davidgoddard/mower2026/external-hardware/esp32/motor-controller/README.md

# Motor Controller V2

## Purpose

This folder contains a self-contained ESP32 motor controller sketch for the second-generation mower protocol.

File:

- `motor-controller.ino`

## What it does

- runs as I2C slave at address `0x66`
- accepts explicit left/right wheel output commands (`-1.0..1.0`, where `1.0` is full output)
- accepts changed commands immediately and a refreshed unchanged command once
  per second as the Pi drive heartbeat
- rejects an older non-zero sequence that arrives after a newer neutral or
  disabled command; safety commands are always accepted so a restarted Pi can
  stop the motors even after its sequence counter resets
- disables drive if the command heartbeat exceeds its 2.5-second lease
- uses an independent five-second ESP task watchdog to recover a stalled sketch
- preserves asymmetric ramp-up / ramp-down behavior
- preserves stop-before-reverse behavior
- counts FG/tach pulses
- returns a direct-read, fixed 32-byte feedback snapshot at 20 Hz
- calibrates both current-sensor zero points on demand immediately before the
  first non-zero drive request from the Pi, while both PWM outputs are forced off
- builds feedback in an inactive buffer and atomically swaps buffers, leaving
  the I2C request callback with only a fixed-size `Wire.write()`

## I2C exchange

- Command: Pi writes a framed command only when it changes or its one-second
  refresh interval elapses.
- Feedback: Pi directly reads the latest 32-byte snapshot; there is no preceding
  feedback-request write.
- The feedback sequence is owned by the ESP32 and increments for every newly
  generated snapshot.
- `watchdogHealthy` reports whether the command heartbeat lease is current;
  fault bit 0 reports an expired or not-yet-established command lease.

## Important note

This firmware already uses the current wire protocol and feedback contract, but the wheel-speed execution is still intentionally simple:

- direct commanded PWM output with local ramping only
- no hardware-tuned closed-loop controller yet

That is good enough for manual bring-up and feedback validation, but not yet final precision control.

## Pin assumptions

Inherited from the legacy build:

- SDA `16`
- SCL `17`
- left PWM `5`
- left DIR `18`
- right PWM `14`
- right DIR `19`
- left tach `21`
- right tach `22`

## ESP32 wiring reference

The current motor controller sketch targets an ESP32-WROOM-32 dev board pinout.

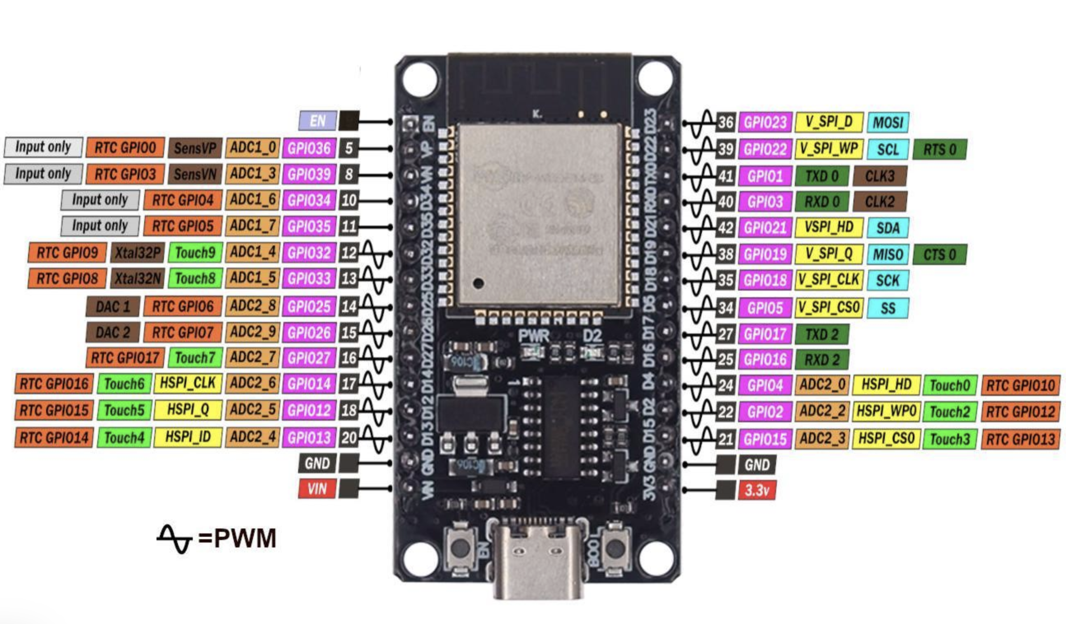
[picture p2: docs/images/esp32-wroom-d32.png]
ESP32-WROOM-32 pin reference


Motor controller signal mapping for the current sketch:

| Function | GPIO | Note |
| --- | --- | --- |
| I2C SDA | `GPIO16` | Pi-to-motor command and feedback bus |
| I2C SCL | `GPIO17` | Pi-to-motor command and feedback bus |
| Left motor PWM | `GPIO5` | PWM-capable output |
| Left motor direction | `GPIO18` | Digital output |
| Right motor PWM | `GPIO14` | PWM-capable output |
| Right motor direction | `GPIO19` | Digital output |
| Left motor FG/tach | `GPIO21` | Input with `3.3 V` pull-up |
| Right motor FG/tach | `GPIO22` | Input with `3.3 V` pull-up |

Wiring constraints:

- common ground between the ESP32, motor driver, and motor feedback wiring is required
- the `FG` lines are treated as `3.3 V` logic inputs on the ESP32 side
- route each `FG` line through a `74132` Schmitt-trigger gate before the ESP32 input
- use an external `4.7k-10k` pull-up to `3.3 V` on each `FG` line for mower installation
- do not feed `5 V` directly into the ESP32 GPIO pins
- do not power the `74132` from `5 V` when its outputs feed the ESP32

## FG feedback note

The current motors appear to provide `FG` speed feedback rather than a full quadrature encoder.

Known characteristics from the motor documentation:

- yellow wire = `FG`
- output type = open-collector `NPN`
- pulse rate = `12 pulses / round`

That means:

- the ESP input needs a pull-up
- the `74132` should be powered at `3.3 V` and used to square up each FG waveform before `GPIO21` / `GPIO22`
- an external pull-up to `3.3 V` is preferred over relying only on the ESP32 internal pull-up
- direction is inferred from a cached "last commanded direction" sign per wheel (`g_leftDirSign` / `g_rightDirSign`). The cache is updated in lockstep with the DIR-pin write inside `applyMotorHardware`, so the encoder ISR can sign each pulse from the cache without an extra `digitalRead`. This is correct during ramp-down and during the brake-to-stop coast (the cached sign is unchanged so coast pulses inherit the prior direction) and during direction reversals (the firmware ramps PWM through zero before flipping the cached sign, so deceleration pulses keep the OLD sign and post-flip pulses pick up the NEW sign).

If the mower reports motion while motor power is off, inspect FG wiring and the pull-up arrangement first.

## Manual test support

Use the companion host-side script:

- `../manual-tests/motor_manual_test.js`
- `../manual-tests/motor_mode_test.js`
- `../manual-tests/motor_idle_noise_test.js`

That script is intended to run on the Pi and exercise:

- spin one way
- spin the other way
- forward
- backward
- direction swaps
- gentle arcs

The idle/noise script is intended to run on the Pi with zero command and the mower stationary. Use it to verify that the FG lines do not produce false pulse counts when the motors are unpowered or idle.

The direct mode script is intended for confirming left/right inversion and mirrored motor mounting. It accepts physical wheel modes such as:

- `FF` = both wheels forward
- `FR` = left forward, right reverse
- `F0` = left forward only
- `0F` = right forward only

Expected result for a healthy idle run:

- `PASS`
- zero encoder deltas for the full run
- `watchdogHealthy: true` while the Pi command heartbeat is current, including
  a current zero-output or disabled command

The production Pi client establishes a disabled command during sensor-hardware
initialization and refreshes the latest active, zero-output, or disabled command
until the hardware gateway closes. This keeps idle health checks meaningful
without enabling the H-bridges; loss of the Pi still expires the lease.

Current sensing is deliberately not calibrated during ESP32 startup because the
ESP32 and Pi can be powered before the motor battery and current sensors are in
their operating state. The first non-zero command from mowing, web manual drive,
or game-controller drive sends a dedicated calibration request. The ESP32
invalidates any prior drive command, forces both PWM outputs off, averages 128
samples from both sensors, and only then can the Pi send the requested motion.
Until this happens, reported motor current is zero rather than an invalid value.
For direct maintenance clients that do not send the dedicated request, the ESP32
also recognizes the first non-zero wheel command, retains it with drive gated
off, performs the same calibration, and applies the command on the next control
step.
An explicit disabled motor command marks the calibration stale, since the motor
battery may subsequently be disconnected without rebooting the Pi or ESP32. The
next drive interaction therefore performs a fresh calibration.

## Before flashing

Check and adjust in the sketch if needed:

- inversion flags for left/right motors
- full-output pulses-per-second estimate
- PWM pins and tach pins
