davidgoddard/mower2026/docs/functional-specification.md

# Functional Specification

## Scope

This specification defines the mower control system that runs on a Raspberry Pi and coordinates with:

- a GNSS ESP node which is itself hooked up to a UM982 dual antenna GNSS module
- a motor ESP node
- a IMU 

All 3 of the above are sharing an i2c link running at 400k baud configured on the Pi.

The motors have output pulses for speed and rotational information and there are current sensing modules on the motor power lines.  This information is available over i2c.

Both heading and position information is available from the GNSS module over i2c.

At the current project stage there is no calibrated translational-speed model for mower motion. Runtime logic shall not use meters-per-second vehicle-speed assumptions or speed-based plausibility gates for control, GNSS validation, or learning behaviour unless this specification is explicitly extended to add that capability.

## System goals

The system shall:
- Provide a web page through which a user can:
    - verify the mower state seeing current GNSS pose, IMU reported heading and motor state.  
    - request a run of the turn tuning
        - separate large-angle and small-angle training runs shall be available
        - small-angle training shall keep repeating each bucket until the absolute error is below 2 degrees
        - large-angle training shall likewise keep repeating each requested angle until the absolute error is below 2 degrees
    - request a run of drive tuning
    - define the mowing areas
        - within each area capture zero or more obstacle perimeters
        - define the outer perimeter
        - allocate a name ot the area
    - start mowing of an area
- when turning: continually monitor the turning and adjust its internal control parameters to reduce errors:
    - turns should use IMU heading changes only
    - GNSS heading shall not be used or written into the IMU baseline while a turn is active; it may be considered only after motor output is zero and yaw motion has settled
    - encoder/motor-feedback-derived turn angle, wheelbase-based heading and IMU/encoder turn disagreement are diagnostic values only; they shall not steer, stop, correct, validate or otherwise influence a turn or any navigation decision
    - turns should request one wheel to go forward, the other backward to turn on the spot and run the motors at full speed.
    - turns should learn when to request zero speed (brake) so that the in-built motor ramping down time is built into the stopping distance/angle thus aim to stop with zero degree error
    - small-angle turns shall combine live IMU angular progress and angular rate with a learned per-direction, per-angle coast horizon from 3° to 60°; elapsed wall time alone shall never complete a turn
    - every turn ever should add to the learning
- when driving: continually monitor the driving and adjust its internal control parameters to reduce errors:
    - Every drive should be as straight as possible and arrive at the target with a minimal X and Y error distance
    - Every drive should follow a sequence of events:
        - settle
        - get current pose
        - if current angle to target is more than 5 degrees then call the turn component with the required angle
        - if the turn component does not report success, stop that segment and do not issue the translation
        - settle 
        - get current pose again
        - compute the travel line to the target
        - apply a straight-line drive controller that:
            - holds full forward or full reverse wheel power throughout the drive — the cutting blade and drive are mechanically coupled and slow speeds risk stalling on grass
            - applies proportional and CTE-rate damping left/right wheel trim to keep the mower on the line and suppress repeated baseline crossings
            - keeps both wheel commands in the selected travel direction; it shall never pivot, scrub one wheel, or reverse one wheel after translation has begun
            - stops the line drive if body-heading error becomes grossly inconsistent with the established line outside the final approach window, leaving any subsequent re-alignment to the segment executor and `TurnController`
            - uses the same geometry for reverse travel with the correct body-heading reference
        - loop reading current pose and measure CTE and remaining distance
        - when remaining distance to target is less than the learned braking distance request zero motor speed; if a severe short-drive overshoot has learned a braking distance at or beyond the leg length, request zero on the first post-start pose update rather than discarding the correction.
        - always stop when the arrival tolerance is reached, even if braking was not used
        - wait learned brake time
        - settle
        - get current pose
        - compute new control parameters based on the CTE and X/Y errors
- short drives up to 1 metre shall use positive and negative stop-trigger learning buckets at 5,10,15,20,25,30,35,40,45,50,55,60,70,80,90 and 100cm, and longer plateau drives shall use separate forward and reverse full-speed brake distances while still retrying each training distance as a forward/reverse pair until both legs meet the configured endpoint bound on both absolute X and absolute Y error (currently 3cm)
- short-drive tuning runs shall be able to alternate forward and reverse legs, taking a fresh pose/heading sample for each leg so the mower can train without walking far away from the test area
- short-drive tuning runs shall clear any stale stop latch at the start of a new user-requested run so a fresh Start action actually starts motion
- drive learning shall use a larger learning step for larger distance errors so a 10cm miss adapts faster than a 4cm miss; short-drive overshoot corrections shall not be clipped to the requested leg length
- drive learning shall maintain separate CTE gains for forward and reverse motion so reverse steering can learn independently from forward steering
- qualified completed mowing strips shall update only the direction-specific proportional and CTE-rate damping steering gains; they shall not alter braking or turn parameters. Training runs retain their existing wider learning responsibilities
- every straight translation shall also apply a bounded, transient terrain trim only when motor-current imbalance and encoder response per applied PWM corroborate the same loaded side. The trim shall slew gradually, decay when evidence disappears, reset between drives, and be disabled by stale/unsafe feedback, watchdog failure, motor faults, obstruction or wheel-slip evidence
- the drive tuning page shall let the operator choose a starting distance, defaulting to 50cm, so already-learned shorter buckets can be skipped during a session
- the drive tuning page shall train the fixed short-bucket distances through 100cm and then longer forward/reverse-brake sample distances at 200, 300 and 400cm
- the drive tuning page shall present a compact short-distance training view with a single start action, stop action, and a simple results table containing distance, average CTE, maximum CTE, X error, and Y error; its Status column shall report success only when execution completed and the configured X/Y endpoint requirements were both met
- the Drive & Paths page shall provide a second mowing start action that drives to the selected area perimeter and then begins the first strip nearest that perimeter without tracing the outer perimeter first
- the Drive & Paths page shall allow an operator to open a stored mowing area perimeter in an on-screen editor, straighten a selected section between two fixed anchors, or replace a selected section with a movable corner between two fixed anchors; the original and edited outlines shall remain visible until the operator explicitly saves the corrected perimeter, and saving shall retain the editor with the saved outline until the operator explicitly closes it
- the Drive & Paths homepage shall retain a header navigation strip linking to the other operator pages
- the system shall persist successful completed mowings in a small JSON datastore with completion date, area name, strip heading angle, and strip width; stopped or failed mowings shall not create history entries
- after the final mowing strip, the mower shall take the shorter route around the recorded area perimeter and return to the GNSS position at which that mowing session started; this return is part of the resumable mowing workflow and the mowing is not complete until the return succeeds
- the Mowing Records page shall allow the operator to save reusable named area, angle, and strip-width presets, delete those presets, record the blades' last-sharpened date, and configure the forward motor travel in metres before sharpening is due; blade usage shall accumulate the larger calibrated forward encoder distance reported by either motor in each feedback sample, while reverse encoder movement shall not count
- while creating a named mowing definition, the Mowing Records page shall show the selected area's actual boundary and generated mowing strips, refreshing as its angle or width changes so the settings can be visually fine-tuned before saving
- saving, updating, or deleting a mowing definition shall show explicit success or error feedback; saved definitions shall be available from an edit picklist, and clicking or keyboard-selecting a saved definition in the table shall load it into the form and refresh its preview
- a saved mowing preset shall populate the Drive & Paths area, angle, and width controls without preventing the operator from overriding those settings; the page shall remember the selected preset across refreshes and continue to show its name until the operator changes the area, angle, or width
- whenever an operator changes a field in an editable settings form, background refreshes shall stop replacing values in that form until the operator saves or cancels the edit; Save shall resume authoritative refreshes using the saved values, while an adjacent Cancel button shall discard the unsaved fields, reload the authoritative values, and resume refreshes. Live status and safety telemetry that does not write into the edited form shall continue updating.
- derive mowing patterns that avoid obstacles and ensure the least number of strips are mowed filling the mowing area with strips that are spaced at 3/4 of the cutting width.
- provide a one-off peg-layout utility for the saved Rear Lawn which uses Pattern A's 23-degree long axis, the production-shaped area perimeter, and every saved obstacle exclusion to divide the lawn from the top of the Drive & Paths map into successive bands of approximately 83.25 square metres of usable area. The mower shall segment-drive from its live trusted-GNSS pose to the first upper-left peg point, pause there for 10 seconds, and then alternate across and down the lawn with the same pause at every outer peg point. Transit to each peg shall use the production mowing free-space router and configured mowing standoff; obstacle-routing vertices are transit points and shall not create extra peg pauses. Preview shall be the default, physical execution shall require an explicit command-line flag, and loss of trusted GNSS, a failed segment, an unsafe route, or operator interruption shall stop the run.

## Operation

A Systemctl registered file must be available that will start the main application server which in turn will make the web page available.

```
sudo systemctl restart mower
```

## Configuration

The system shall store persistent configuration in the `config/` folder, split by concern:

- `config/motor-calibration.json`
  - motor ramp-up time
  - motor ramp-down time
  - motor-specific calibration values
- `config/imu-yaw-calibration.json`
  - persisted IMU yaw scale factor used by the sensor controller
- `config/pose-calibration.json`
  - encoder meters-per-tick calibration
- `config/path-following-parameters.json`
  - closed-loop detection, verification standoff, turn-only threshold, and obstacle outward offset values used for traced obstacle path following
- `config/turn-learning-parameters.json`
  - turn brake distances and turn learning history
- `config/drive-learning-params.json`
  - drive brake distance, forward/reverse CTE gain, and learning history

The application shall:
- load these files at startup
- create them with defaults when missing
- persist updates back to the same file
- keep hardware calibration separate from operational learning

## Stop Behaviour

The system shall maintain a global stop state that can be raised by:
- user action, such as pressing the stop button or calling the stop API
- execution failure, timeout, or other runtime safety condition

When stop is set:
- all active loops shall check the stop state and return or exit promptly

Before the application exits for an uncaught exception or unhandled rejection, it shall latch the global stop and issue an immediate motor emergency-stop command.

Mowing resume checkpoints shall be persisted in request order using atomic replacement. Rapid checkpoint updates and clear/save transitions shall not share a temporary filename, corrupt the canonical resume file, or terminate active control when persistence fails.
- every motor command written after that point shall carry the stop-disabled flag so no later command can accidentally re-enable drive while the stop latch remains set
- the sensor controller loop shall continue to send zero wheel speed commands while the current operation remains active
- the motor disable shall be asserted only when the active user-requested operation ends
- active operations shall not continue silently in the background

The stop state shall be cleared only when:
- the user requests a new operation
- the system restarts

Stop requests and clears shall be logged centrally, including the source that raised or cleared the state.

## Primitives

### Logging

A logger must be available that is asynchronous and runs in its own thread and writes out to a session log file using JSONL format entries.

Each time the main app is started a new session file must be created.

For log retention, keep:
- session files from the current startup date
- session files from the most recent prior date with logs

Remove older dated session files.

Entries should include the time, the application context, the class that invoked it and then the data.  

Log entry timestamps should be local time for operator readability.

Most Logs should be added only to aid debugging and removed once no longer required.

A sustained GNSS rejection shall log immediately when its primary reason changes and then at most once per minute while that reason remains active. Periodic entries shall include the number of suppressed repeated samples so an outage remains measurable without producing one warning per second.

Key events in application state progression such as starting something in response to a user request should be added to structure the logs but kept to a minimum.

### I2C bus

There must be one I2C bus in the entire application.

A controller for this will expose asynchronous read and write methods with a simple priority mechanism.

A "Stop" message must be sent next if one has been queued - priority 1

A "Motor Speed" message must be sent priority 2

A "GNSS" read is priority 3

A "IMU read" is priority 4

If a message of one of the priorities has already been queued, then replace the payload if applicable with the latest but keep only one message for that logical key in the queue.  Ie. if a new Motor Speed request arrives, only store the new speed but maintain only one entry in the i2c message queue.

The controller should send all messages in the queue in the priority order as soon as possible and clear the queue as quickly as possible.

A recoverable failure from one I2C address (`EIO`, `EREMOTEIO`, `ENXIO`, or a short transfer) shall be retried on the existing bus handle and shall not close or reopen the controller shared by the other nodes. A controller-wide busy or timeout failure may close and reopen the bus before retry. This distinction prevents a rebooting GNSS client from repeatedly disrupting motor commands and IMU samples.

### Web server

The user will interact with the controller through a web page.  A server will provide the support for this web page through HTTP API.

A HID games controller interface shall be supported for manual driving.

The web page must remain responsive at all times

#### Drive & Paths Home Page

The root web page shall be the Drive & Paths operating page. Its header shall contain compact live representations of the IMU, GNSS and motor-odometry widgets. Selecting any compact widget shall open the expanded dashboard at `/dashboard`.

The expanded dashboard provides a real-time view showing the current state of all sensors with graphical and numerical displays:

**IMU Widget:**
- Compass display showing heading (navigation convention: 0° = north, clockwise positive)
- Numeric heading value in degrees
- Pitch indicator: circular level meter showing front-to-back tilt angle
- Roll indicator: circular level meter showing side-to-side tilt angle
- Status indicator (running/error/idle)

**GNSS Widget:**
- Compass display showing GNSS heading (navigation convention)
- Position coordinates (X, Y in meters)
- Fix type (none/single/float/fixed)
- Position accuracy in meters
- Satellite count
- Numeric heading value
- Status indicator

**Motors Widget:**
- Left and right wheel speeds (m/s) derived on the Pi from raw encoder feedback only
- VU meter displays for motor current draw:
  - Real-time current level shown as gradient bar (green → yellow → red)
  - Peak hold indicator (holds maximum for 2 seconds)
  - Numeric display: current / peak in amps
  - Scale: 0-10A maximum
- PWM percentage for each motor
- Watchdog health status
- Fault flags (hexadecimal)
- Status indicator

**Navigation:**
- Header menu buttons for Turn Tuning and Drive Tuning pages
- Back buttons on tuning pages return to dashboard

**Heading Display Convention:**
All compass displays and heading values shown on the web interface use navigation/field heading convention (0° = north, clockwise positive). The internal system uses a different convention (0° = east, counterclockwise positive) which is converted for display purposes.

#### Primitives API

The primitives JSON API (`/api/primitives`) exposes sensor domains as distinct sections:
- `imu` - heading, pitch, roll
- `gnss` - position, heading, fix quality
- `motors` - speeds, currents, PWM, watchdog, faults

For motors, primitives include both:
- last commanded wheel output percentages
- latest feedback sample (derived wheel speed, encoder deltas, PWM, current, watchdog/fault state)

### Sensor Interface

A component is required to interface the controller to the sensor information.

The sensors are interfaced through i2c at 400000Khz set by the Raspberry Pi baud rate for i2c.

The sensor interface shall be implemented as one Sensor Controller boundary in the application layer with a clear separation between:
- application-facing sensor state and polling orchestration
- hardware-facing adapters/drivers for each device.

The Sensor Controller will be responsible for polling each configured sensor device on its own cadence and storing only the latest successful state (plus last error state where relevant). A single scheduler loop wakes every ~8 ms and dispatches reads only to the sensors whose individual deadline has elapsed: IMU at ~125 Hz, motor feedback at 50 Hz, and GNSS at 20 Hz. Polling is asynchronous to the main control code. Consecutive GNSS transport/decode failures shall exponentially reduce only the GNSS polling rate, capped at a one-second retry interval; the normal 20 Hz cadence resumes immediately after a valid sample, without reducing motor or IMU polling.

The Sensor Controller is the single owner of sensor polling cadence.  Device-specific polling loops are not to be run independently outside this controller in production runtime.

The Sensor Controller should expose a snapshot/read API for the latest sensor state so other components can consume sensor data without direct hardware coupling.

#### Motor interface

The sensor controller shall poll motor feedback at the motor cadence (~50 Hz) and expose the latest motor state in primitives.

The sensor controller shall expose motor command methods for:
- setting left and right wheel target percentages, where 1.0 is full output and 0.0 is stop
- issuing a stop command

Motor wheel commands shall be latest-wins across active, neutral and disabled states: all three use one logical I2C queue key, so if the application enqueues several commands before the bus drains only the newest state reaches the ESP32. An in-flight command may finish, but the newest command must be the next motor command written. While the global system-stop flag is latched, ordinary wheel-output requests shall be suppressed and the sensor loop shall continue reasserting the disabled state until the flag is explicitly cleared.

The motor I2C client shall own one resettable refresh timer for the latest active, neutral or disabled motor command. A changed command replaces the latest value immediately, cancels the prior timer, is queued to I2C as soon as possible, and starts a new one-second refresh interval. The timer callback shall read the current latest command rather than retain an older command snapshot. Command producers are not responsible for heartbeat traffic.

The Pi-to-motor-node command protocol shall use normalized percentages rather than metres-per-second targets.
The ESP32 motor controller shall treat the requested target percentage as the top-of-ramp destination and apply ramp-up/ramp-down over the configured duration.

Neutral and disabled motor commands must use the highest bus priority (`1`); commands requesting motion use priority (`2`).

Application-level motor command convention shall be:
- positive wheel speed means forward
- negative wheel speed means reverse

Where hardware wiring/motor node direction differs, inversion shall be applied only at the hardware adapter boundary, not in application control logic.

Motor feedback shall include, at minimum:
- encoder pulse delta per wheel since the previous sample
- watchdog health and fault flags
- motor current for both wheels

The sensor controller shall detect likely obstructions/stalls from its latest motor feedback, the current motor command and the latest pose estimate. During translational driving, commanded motion must produce meaningful trusted-GNSS positional progress over a short grace-adjusted observation window. During an in-place pivot, commanded motion must instead produce meaningful IMU heading change. Until the installed current sensors have been validated under load, motor current of at least 10 A sustained for approximately two seconds is independently sufficient stall evidence; it must fall below 9.5 A to clear that observation, preventing threshold chatter. On a confirmed stall, the controller shall emit an obstruction event, request a global stop and log the condition once.

The stall observation window shall restart whenever commanded motion changes between an in-place pivot and translational driving. Pivot progress shall be measured from IMU heading change rather than GNSS position. Forward or reverse progress shall be measured from trusted GNSS position; encoder movement alone must not hide a chassis that is stationary because its wheels are slipping.

The ESP32 motor node shall send raw encoder pulse deltas and PWM/current telemetry only. Because the ESP32 and Pi are powered before the separately connected motor battery makes the current sensors stable, current-zero calibration shall not occur at ESP startup. The shared Pi motor-command path shall request calibration before its first non-zero mowing, web-manual, or game-controller command; the ESP shall disable both outputs throughout calibration and report zero current until calibration has completed. A disabled motor command shall mark that calibration stale because the motor battery may be disconnected while the Pi and ESP remain powered, requiring the next drive interaction to calibrate again.
The Pi-side sensor controller shall convert encoder deltas into wheel speed estimates using the persisted encoder calibration.

Encoder pulse deltas are required so higher level components can integrate distance over time.

Motor commands and feedback shall use framed i2c request/response messages with these message types:
- `0x21` wheel speed command
- `0x22` feedback sample

Motor i2c default address shall be `0x66` and remain configurable for bring-up/testing overrides.

#### Manual drive controller interface

Manual drive arming/disarming shall use:
- right-top button to enable manual drive
- left-top button to disable manual drive and stop motors

Joystick speed/steering demands shall be mapped to left/right wheel speed targets using the previous proven manual-drive shaping model (including deadband and spin/arc behaviour), then sent via the standard motor command primitive. Manual drive shall remain on the normal motor-node path, but may use a faster manual-specific ramp profile than autonomous motion so operator start/stop response stays crisp.

Manual-drive commands must never bypass the motor node control path.

Manual-drive output commands shall be coalesced so tiny analogue stick jitter does not create unnecessary I2C writes, and unchanged held commands shall not be resent to the motor node.

If controller connectivity is lost while manual drive is armed, manual drive shall issue a gentle stop (zero wheel command, drive enabled) but shall keep manual drive armed for a short reconnect grace window so a flaky HID link can recover without the operator re-arming. If the grace window expires without reconnection, manual drive shall disarm via the normal stop path. A controller disconnect shall never trigger a hard motor disable.

#### IMU interface

The sensor controller must maintain IMU-based orientation, integrating yaw values and calculating tilt from the IMU.

**BMI160 IMU Sensor:**
- Gyroscope: 3-axis angular velocity for heading integration
- Accelerometer: 3-axis acceleration (X, Y, Z) for pitch and roll calculation

The runtime shall treat the BMI160 gyro as a `2000 dps` range sensor with the corresponding `16.4 LSB/dps` conversion already baked into the driver.

**Orientation Data Provided:**
- **Heading**: Integrated from the gyro vector projected onto the gravity axis derived from pitch and roll, normalized to signed range `[-180, 180]`
- **Pitch**: Tilt front-to-back (rotation around Y-axis), calculated from accelerometer
  - Positive pitch = nose up, negative = nose down
  - Formula: `pitch = atan2(-ax, sqrt(ay² + az²)) * 180/π`
- **Roll**: Tilt side-to-side (rotation around X-axis), calculated from accelerometer
  - Positive roll = right side down, negative = left side down
  - Formula: `roll = atan2(ay, az) * 180/π`

**Calibration and Zeroing:**
At startup, the IMU performs calibration:
1. Gyroscope bias: Averages all three gyro axes over the default stationary calibration window to determine drift offsets
2. Pitch/roll zeroing: Averages tilt calculations over the same stationary calibration window to establish level reference

This allows the mower to zero its orientation on uneven ground during startup. All subsequent readings subtract these calibrated offsets.

**Heading Reset:**
The sensor controller shall support an external absolute heading update (for example from GNSS) which resets the maintained IMU heading to the supplied value. During normal operation, the GNSS heading must already be close to the IMU heading. Every GNSS position or heading value consumed by pose fusion must pass the checks for that individual epoch; a latched TRUSTED state used for promotion/demotion hysteresis shall never make a currently rejected sample eligible for fusion. While the mower is stationary and safe to rebase, five consecutive GNSS samples that independently pass fix, position, heading-validity, heading-accuracy, baseline, and heading-stability checks shall permit a reset regardless of the IMU/GNSS heading difference. GNSS position accuracy shall be used separately for trusting x/y updates. After reset, yaw integration continues from the new heading baseline.

Heading resets must be timestamp-aware. When the caller can provide the controller-clock time of the reset, the sensor controller shall use that timestamp as the next integration reference; otherwise it shall use the current controller clock. This ensures rebasing the IMU does not discard or double-count a gyro interval during or immediately after a turn.

GNSS heading resets shall be deferred whenever the latest motor command is non-zero or the latest tilt-compensated IMU yaw rate is above the stationary threshold. The system may still observe the GNSS heading and use good GNSS position data in that state, but it must not write the GNSS heading back into the IMU heading baseline until the mower is stopped and yaw motion has settled.

When a non-zero motor command transitions to a stop command, the sensor controller shall capture a compact IMU diagnostic summary for the just-finished motion. Pose fusion shall prefer that stop-time summary when later logging a GNSS heading rebase, because the sustained stationary wait may otherwise hide the turn evidence from the rolling diagnostic window.

**Internal Heading Convention:**
IMU heading uses internal convention (0° = east, counterclockwise positive). The web interface converts this to navigation convention (0° = north, clockwise positive) for display.

#### GNSS interface

GNSS samples shall be obtained over the shared I2C bus from the GNSS node using request/response framing.

The GNSS node default i2c address is `0x52` and should remain configurable for bring-up/testing overrides.

The GNSS response payload should provide planar position and heading primitives, including:
- timestamp
- `xMeters`, `yMeters`
- fix type / quality
- optional heading and heading accuracy
- optional ground speed
- sample age and related health/debug ages where available.

The application and current GNSS firmware shall use one 40-byte GNSS payload layout. Bytes 36–39 report the GNSS ESP boot identifier, reset-reason code, and coordinate-origin source so the Pi can distinguish a radio/receiver-quality outage from an ESP restart and origin reacquisition.

The application shall validate exact frame length, protocol version, CRC,
node/message type, and request/response sequence before accepting a GNSS sample.
The firmware's `sampleAgeMillis=65535` no-receiver-sample sentinel shall be
treated as unavailable telemetry rather than as a genuine zero-satellite
measurement; the last successful satellite count may remain visible only when
clearly accompanied by stale/error state.

The I2C GNSS request path should be resilient to transient client errors using short retries on the existing shared bus handle before surfacing a read failure. Sustained failures shall be rate-limited as specified for the Sensor Controller, with one recovery event when valid frames resume.

The GNSS ESP shall derive the production local coordinate frame only from verified RTCM 1006 base-station data. After startup or reset it shall publish `fixType=none`, zero local coordinates, and unusable position accuracy until that stable origin is available; it shall not silently redefine the lawn origin from the first rover fix.

#### Planar coordinate and heading conventions

All runtime position, heading, and geometry calculations shall be performed on a Cartesian X/Y plane in meters.

Latitude/longitude shall not be used in control, planning, guidance, or estimator math.

If upstream GNSS data originates in latitude/longitude, conversion to planar X/Y meters must happen before the data enters the application estimator/control flow.

Internal heading conventions shall be tied to the X/Y plane:
- 0 degrees points along +X
- positive angles rotate counterclockwise toward +Y.

GNSS heading values that use field/navigation convention (clockwise from north) must be rotated into the internal X/Y heading convention before use in estimator/control logic (for example `internalHeading = normalize(90 - fieldHeading)`).

The GNSS heading exposed to application consumers must be this rotated internal heading and normalized to the signed range `[-180, 180]`.

The GNSS position exposed to application consumers shall be the mower control point rather than the raw antenna phase centre whenever a calibrated body-frame offset is available. That offset is fixed in mower coordinates and must be applied using the IMU heading aligned to the GNSS position's effective sample time (Pi arrival timestamp minus the receiver-claimed sample age), with wrap-safe interpolation between buffered IMU samples. The current arrival-time heading shall not be applied to a delayed position during a turn. Diagnostics shall retain the raw antenna coordinates, effective correction timestamp, correction heading, and corrected control-point coordinates.

IMU heading integration direction must match this same internal heading convention so that IMU and GNSS heading increases/decreases are aligned.

# Mid level building blocks

## Turning on the spot

An asynchronous turn component that takes on the responsibility of turning the mower.

Input is a single normalised turn angle

In general the code:

- note the start heading from the IMU only
- starts the motors at full power, 
- monitor the IMU heading only until the brake point is passed and wait
- Once at or beyond the brake point zero the motors
- wait for 2 * the motors configured ramp-down time
- re-read the IMU heading only
- compute the arrival error angle
- use the error angle to adjust the brake angle to improve future turn accuracy

Consideration must be given to the smaller angles where the brake angle is close to the angle to turn to ensure that the motor is asked to power up.  I.e. even if within the braking distance the motors still need to be engaged and the system must be able to turn reasonably small angles this way.

The web server and web app need a dedicated tab that shows requested and achieved angles for all turns between 10, -10, 20, -20 ... and 170, -170, 180, -180 degrees.  A suggestion is to show a table with the requested angles as the column headings and the achieved angle shown in the cell below.

The web page must provide a button to launch into a sequence of test iterations where one iteration goes through all angles to be tested.  

There shall be no separate stationary-pose helper. Whenever the system needs a pose reading, it shall use the normal live pose provider directly so the tuning and validation paths exercise the same building blocks as the rest of the app.

Every turn must feed back the error of the achieved angle to improve the braking angle to attain a zero degree error.

Being able to turn 10 degrees will be tough but consideration should be given to handle this being aware that the braking distance might be greater than the angle to turn and yet the system should engage motors and try to stop on target and so a different implementation might be required for small angles below N.

The operation of the braking is such that once the mower is up to full speed which it does not know so we will use a magnitude based gate, then small angles are managed one way and angles above the gate simply run at full speed until the remaining angle is less than the learned brake angle.  There will be one brake angle for positive and negative turns. 

For small angles, request zero speed when the remaining angle is no greater than the live IMU angular rate multiplied by the learned coast horizon. The horizon is bucketed by requested angle and direction so drivetrain asymmetry is retained. Overshoot increases the horizon and therefore brakes earlier; undershoot decreases it. A lack of physical angular progress must not be mistaken for completion merely because time has elapsed.

The transition from small to large angles will be a configuration value set initially to 30 degrees.

The control data such as braking distances learned, perhaps for a given angle, must be persisted and picked up the next time the server starts and must also be used by the next turn immediately.

If the system receives a "Stop" request from a user interaction or a failure condition, the turn must be stopped immediately.

An active turn shall treat the global system-stop latch as authoritative even while IMU samples continue arriving. Sensor feedback loss shall resolve the turn promptly as stopped rather than allowing healthy IMU events to keep the turn watchdog alive indefinitely. Primitive turn and line controllers shall not clear the global stop themselves; only the user-requested operation entry point may do so.

## Driving from point to point

An asynchronous segment-driving component that is responsible for moving the mower from one position(current) to a target position in the X/Y plane.

The input is a single target position

The segment drive goal is to turn to face the target and then drive as straight a line as possible arriving as close to the target as possible.

The straight-line portion is a self-contained line-drive component that assumes the mower is already aligned with the line of travel.  It is responsible for minimising cross-track error (CTE), along-track X error, and arrival Y error, while learning brake distance and CTE gain for both short and long drives.  Forward and reverse motion use separate line-control branches so the reverse case can treat the target as behind the mower while still using the same straight-line learning model.  The target arrival is mandatory. For an extremely short drive whose learned braking distance is at least the whole leg, the braking request is issued on the first post-start pose update; the learned evidence is not ignored merely because the physical ramp-down distance exceeds the requested travel. A heading preview term may assist steering while there is still comfortable distance to run, but it should taper off close to the target so that it does not create a sharp turn-in at arrival.  The live CTE correction should become progressively stronger as lateral drift grows so the mower fights a bowing path early rather than waiting for the next run to learn from it.

To control this the drive component will learn how to keep CTE small or zero and keep X/Y arrival errors small or zero.  In priority terms, X is more important than Y but Y should naturally be small if CTE is tuned well.

The logical sequence of steps is:
 
- get current pose
- calculate angle to target
- call the turn component with that angle
- get current pose 
- calculate line to target
- apply power to motors and wait for the initial command/current-calibration handshake to drain through I2C before accepting pose updates as drive progress or braking evidence
- monitor and correct CTE and monitor remaining distance.
- when at or beyond the braking distance stop the motors.
- wait for twice the configured motor ramp down time for things to settle
- get current pose
- use current pose to compute final X/Y errors 
- update configuration paraemters to improve the next CTE and X/Y and braking
- produce summary for web page
- return

`TurnController` owns motor ramp-down and settling for every alignment pivot, so the drive controller shall not add a duplicate time delay. After that settled turn completes, the drive controller shall read the fused position again and recompute both remaining distance and target bearing before constructing the straight line. A small residual heading error may be accepted when its projected lateral displacement fits within the requested CTE envelope, allowing the line controller's tapered short-drive heading correction to recover it as an arc. Otherwise the drive controller shall make no more than two corrective IMU turns, each with the ordinary turn-owned settling, before starting translation.

When an operation supplies an authoritative translation-path validator, the drive controller shall invoke it from the settled live pose after every alignment pivot and again immediately before handing off to straight-line motion. A rejection shall end the manoeuvre while motor output is neutral; the controller shall not make a corrective pivot or begin translation from that rejected pose. Mowing shall supply this validator for every segment using the frozen area and obstacle geometry. A wheelbase-contained pivot may leave the fused reference point up to 25 cm beyond the recorded outer perimeter; that pose is recoverable only through a sampled, obstacle-free segment whose distance outside the area decreases monotonically to an inside target. Obstacle-interior starts and positions farther than 25 cm outside remain hard failures.

An operational straight drive may supply an authoritative CTE-reference start distinct from the live mower pose. Initial and post-turn target bearings shall still be calculated from the settled live pose to the original planned endpoint, so translation begins without trying to manufacture a new start point. Mowing-strip CTE, line heading, along-track progress and arrival geometry shall remain referenced to the immutable planned entry-to-exit baseline. A displaced start may therefore create one initial convergence arc, but it shall not redefine the remainder of the strip as a new diagonal.

Before a normal or resumed mowing-strip translation starts, the executor shall validate the settled post-pivot pose against that immutable baseline. Residual heading is compared with the configured turn-alignment tolerance and observed pivot displacement with a 15 cm anomaly threshold. Entry CTE recovery shall use a 1.5-times hysteresis around the configured segmented-drive CTE limit, so ordinary GNSS variation just outside the line controller's target does not launch a point reapproach that the immutable-baseline controller can already converge. An ordinary offset inside those limits remains the line controller's convergence task. If a recovery limit is exceeded and the settled control point remains at least 25 cm from the planned entry, the executor may make one geometry-checked return to that entry (without the normal 15 cm mowing deadband) and one final alignment attempt. Inside 25 cm, a settled strip-facing heading shall be preserved and residual positional/CTE convergence delegated to the immutable-baseline strip controller; the executor shall not turn toward the close entry point when pivot displacement could consume the useful translation and force an immediate opposite turn back to the strip heading. This is a bounded quality recovery rather than a separate terminal safety gate: if the second observation is still outside a quality threshold, the executor shall log the degraded entry and pass the live pose to the existing geometry-checked drive controller, which retains responsibility for another material heading realignment, translation-path rejection, and convergence onto the immutable strip baseline. It shall not require operator resume merely because a single GNSS epoch or a small turn straddles a quality threshold, and it shall not redefine the strip or regenerate the remaining plan.

Straight-line telemetry shall record signed CTE against that immutable baseline, CTE integral, distance to the target band, baseline crossings and whether crossing amplitudes decay. One initial crossing is acceptable convergence. Repeated or non-decaying crossings shall teach additional direction-specific CTE-rate damping; once damping is already substantial, persistent repeated crossing may cautiously reduce excessive proportional authority. High CTE without oscillation may still strengthen proportional correction. Persisted steering learning shall retain enough range to continue adapting while qualified mowing evidence remains outside the target band; historical parameter values shall not become artificial saturation points. The combined proportional, heading, damping and terrain correction shall remain inside the existing steering-trim ceiling, and both wheels shall remain in the selected translation direction.

The drive controller shall not impose a duration-based timeout on a drive. Drives are bounded by measured error: arrival tolerance, the optional cross-track-error limit, and the global stall detector. Ground speed is not guaranteed and a drive that is making honest progress shall be allowed to continue.

Operational mowing drives may specify a 15 cm minimum useful translation. The controller shall remeasure distance after its alignment pivot and treat the operation as successfully reached when less than that minimum remains, preventing a pivot-induced pose change from causing another turn and centimetre-scale corrective drive. Calibration and training drives shall not inherit this mowing-only deadband.

Mowing strip sequencing shall divide the clipped free space using sweep topology. Whenever successive mowing offsets cause a mowable interval to appear, disappear, split or merge, the affected intervals shall form distinct stable regions. This decomposition shall discover visitable pockets and branches created by the outer area boundary as well as the regions around recorded obstacles. Each region shall have two complete sweep templates, one for each entry direction. The planner shall optimise the order and orientation of this small set of templates as a closed regional cycle whose last-to-first transition is also safely routable. The live mowing position shall select the nearest safely approachable region entry and rotate that fixed cycle rather than changing its transitions; after wrapping, every region is therefore completed once with the same efficient regional ordering. Within a selected region the adjacent-strip sweep remains a hard constraint. The rotated region IDs, order, strip IDs, entry/exit points, connectors and cost estimate form part of the mowing plan and shall be persisted before motion so resume continues the identical route. After the final region the mower shall return by the shortest safe route to the original GNSS position recorded when the mowing session began, and completion shall not be reported before that return succeeds.

Every region-to-region transition considered by the optimiser shall first be constructed and validated by the production safe-connector logic. An edge which cannot remain inside the mowing area and outside every obstacle shall be excluded rather than selected on geometric distance and rejected after optimisation.

Previously mown ground is a routing cost, not a forbidden area. Connector planning shall progressively consider direct travel, both directions around a shared boundary, both directions around intersecting obstacles, both directions around the area perimeter, and finally a shortest path through a visibility graph of safe inset-area and expanded-obstacle vertices. Only leaving the mowing area or entering an obstacle are hard exclusions. A connected mowing area shall therefore retain a route between every visitable region even when that route crosses completed strips or retraces an earlier connector.

The recorded outer perimeter is an authoritative traversable fallback when numerical inside-area sampling rejects travel exactly along that boundary. Regional optimisation shall evaluate cheap directly safe transitions and assign a finite high cost to transitions requiring routed travel; full perimeter or free-space route construction shall be deferred until the selected traversal is known so preview latency does not scale with every hypothetical regional edge.

The sparse free-space routing graph shall attach each requested transition endpoint to every visible roadmap node and shall preserve consecutive edges around each expanded obstacle standoff loop. Dense nearby strip waypoints must not isolate an obstacle-to-area transition by displacing the first visible escape node from a fixed nearest-neighbour set.

Every generated mowing strip, including its endpoint-to-standoff sections, shall be retained as a connected retrace edge in the routing graph. Consequently an obstacle-side endpoint can retreat along previously mown strips to the outer perimeter, and the outer perimeter provides the common connection between all otherwise separated mowing regions. Failure is valid only when no such connected free-space route exists.

Obstacle or perimeter clipping shall discard mowing-strip fragments shorter than 0.15 m. Such fragments are below the minimum post-pivot drive, are treated as arrival-position noise already covered by the mower footprint, and must not become route destinations whose configured standoff lies beyond the fragment. For longer strips shorter than twice the configured endpoint standoff plus 0.15 m, both endpoint standoffs shall shrink symmetrically to retain at least a 0.15 m mowing drive.

Using events for all sensor value inputs.

Ideally the heading is known at all times.  The mower shall run from the IMU heading continuously.  At startup, the first good GNSS heading shall rebase the IMU immediately if the mower is not already commanded to move and yaw motion is settled.  After that, GNSS headings shall only nudge the IMU when the fix is "fixed", the heading accuracy is good, the heading is stable, the mower is stopped, yaw motion has settled, and the new GNSS heading is already very close to the current IMU heading.  If the mower remains stopped and safe to rebase, five consecutive GNSS samples that pass every heading-quality check other than IMU agreement shall rebase the IMU regardless of the size of the heading difference, so the agreement gate cannot permanently prevent recovery from drift.  When the GNSS gives a silly value or loses fix quality a form of dead-reckoning is achieved by keeping the IMU heading and using the last known good position estimate.  Likewise for position, use GNSS when the fix is good but if fix is lost, then use a dead-reckoning using the motor feedback.  This will require a calibrated motor feedback tick to distance value.

It is suggested that the above fusion of values to make sensor readings is encapsulated into one place and can be called everytime a current pose is required.  The turn controller will directly hook the IMU and will not use this component.

Drives should use full speed.
When the start and end positions are obtained using good quality GNSS fixes, the code can optionally update the motor feedback tick to distance configuration value to improve dead-reckoning performance.

Dead-reckoning calibration shall first drive a GNSS-measured straight, defaulting to 10 m, and derive independent left and right metres-per-tick values by dividing that settled GNSS distance by each wheel's encoder count. It shall then drive long forward arcs in both directions, defaulting to 180 degrees, and calculate an effective moving track width for each arc from the difference between the calibrated wheel distances divided by the IMU heading change in radians. The suggested track width shall be the mean of the available CW and CCW results. Calibration shall retain and present the raw counts and calculated values; it shall not reject an arc or claim wheel slip from a dead-reckoning endpoint residual. Material disagreement between the two directional track-width results shall be reported for operator review before applying the calibration.

### Braking distance learning

Once the mower reaches full speed, the braking distance should stabilize and be roughly constant for all distances driven on level ground.  The system should learn a single brake distance parameter that applies to all drives once at full speed, but the drive controller must still stop on arrival even if braking was not applied early enough or is not needed.
In practice the learned full-speed brake distance should be allowed to move down to around 10cm, because the mower may only need a short ramp-down overrun once it is already at speed.

For very short drives where the mower does not reach full speed (due to motor ramp-up time), a different braking strategy is required.  These short drives should still engage motors and attempt to reach the target, but shall use short-distance stop-trigger buckets at 5,10,15,20,25,30,35,40,45,50,55,60,70,80,90 and 100cm with separate positive / negative learning variants, and paired forward/reverse retries when a bucket misses tolerance.

Short-drive tuning shall use a line-drive training mode that alternates forward and reverse legs around a local anchor so the mower can train in a compact area without needing a long run-up or large amount of free space.

The drive tuning web page shall trickle-feed short-distance training progress while a run is active so the operator can see the current bucket, pair attempt and latest leg result before the full run completes. Short-distance training shall still learn both brake fractions and CTE gain, but the live steering curve should remain nonlinear so the mower fights drift harder as it grows instead of waiting for the next run to discover the bow.

The brake distance may vary depending on terrain slope (uphill vs downhill).  Future enhancements could incorporate IMU pitch angle to adjust brake distance dynamically, but the initial implementation should focus on learning a single brake distance for level ground operation.

The learning algorithm should:
- maintain one primary brake distance parameter (in meters) for full-speed drives
- update this parameter after each drive based on X-axis arrival error
- if overshot target (positive X error): increase brake distance
- if undershot target (negative X error): decrease brake distance
- converge quickly since all full-speed stops should behave similarly

For short drives where full speed is not reached, the system shall:
- use dedicated stop-trigger buckets at 5,10,15,20,25,30,35,40,45,50,55,60,70,80,90 and 100cm
- use separate forward and reverse full-speed brake distances for longer plateau drives, while still sampling straight-line training at 200, 300 and 400cm
- maintain separate positive and negative variants of the short-drive buckets
- continue short-drive learning runs until the absolute X error is below 4cm, retrying forward/reverse pairs together when either leg misses the target
- sample the current pose and heading immediately before each leg starts so the mower drives from its current local frame
- pause briefly before each leg starts so the operator can see a clear training cadence on the web page
- stop a leg early if the cross-track error grows larger than the requested run distance, to avoid the mower drifting far away from the test area

For segment-drive learning, the system shall:
- use a fixed line defined by the mower's current pose and heading at the start of the run
- train segment distances from 105cm to 6m in 20cm increments
- use the segment controller so each leg turns to face its target and then drives the segment
- repeat each forward/reverse pair until the absolute X error is below 4cm
- present live learning progress and per-run results on the drive tuning page

For segment testing, the system shall:
- collect 7 rough waypoints by taking a live pose, driving forward for about 3 seconds, stopping, settling, and then sampling the next pose along the same line
- drive first back to the earliest waypoint using the existing segment controller
- then run 10 further test segments to random non-nearest waypoints using the same segment controller
- present live IMU and GNSS widgets on the left and a real-time results table on the segment testing page
- show distance to waypoint, required heading change, achieved heading change, drive quality, average CTE, maximum CTE, and X/Y errors for each run

## Path following

Automatic return to charge shall be triggered only when integrated drive-motor current usage reaches the configured remaining-capacity reserve. Combined wheel travel may be accumulated and displayed as a diagnostic but shall never request recharge. An explicit operator request may still schedule recharge after the active strip.

Recharge transit shall execute the complete ordered safe route returned by the mowing transit planner. When a direct approach is unsafe, the planner shall route on the inward standoff perimeter rather than offering raw recorded area vertices as shortest-path nodes; a mathematically in-bounds route along a physical wall is not an executable transit. The complete route shall be checked against the area and obstacles before motion, and meaningful route corners shall use the same stop, standard turn, and short outgoing-edge capture as routed mowing connectors. The mower shall follow that route until the charging drive-to point becomes safely reachable, then perform the final docking line. The return-to-mow route shall meet the same requirements. Consuming a route's starting waypoint shall retain the incoming first segment as the active projection segment rather than testing the mower against a later perimeter segment.

A closed perimeter trace entered from an inward approach pose shall use that live pose only for the initial join. Any perimeter vertices skipped by an ahead join shall be rotated to the end of the route rather than discarded. After joining, the mower shall traverse every authoritative perimeter edge and close at the first joined perimeter point; it shall not replace perimeter sections with diagonal shortcuts to either the join point or the inward approach pose.

A preferred area-trace entry derived from a strip intersection shall be projected onto the authoritative cleaned area perimeter before it is inserted into the trace route. Numerical clipping residue shall not create a new exterior perimeter vertex.

The initial drive to a mowing-area perimeter entry, including **Mow From Perimeter**, shall validate the complete approach before motion. From inside the area it shall use a safe routed transit when a straight line would cross an out-of-bounds concavity or obstacle. From outside the area it may enter only through the nearby boundary edge on an inward, obstacle-free approach; it shall reject a shortcut across exterior ground to a distant entry edge. A route that cannot be validated shall fail before motor movement.

Continuous perimeter and connector steering shall update at 50 Hz, express wheel-command slew limits per elapsed second, preserve full requested output on the faster forward wheel, and vary the inner wheel using the learned forward CTE, CTE-rate damping, and heading gains shared with straight driving. Persistent CTE above twice the configured target corridor while its filtered trend continues away from the path shall stop as non-converging before the wider route-loss guard is reached. The runtime shall log periodic tracking samples and a completed-run CTE summary so controller output can be correlated with actual convergence. Before motion, the complete ordered route shall be assessed to choose one stable moving-lookahead distance between the configured minimum and 1 metre maximum. The chosen distance shall be the longest candidate whose chords from every sampled route position remain within the configured maximum departure from the intervening reference path. The arrival section alone shall never impose the traversal lookahead. Ordered projection shall remain on the incoming edge of an unconsumed pivot corner, even when a hairpin's outgoing edge passes closer to the live pose; only explicit ordered progress or completion of the corner manoeuvre may consume that vertex. If even the minimum candidate cannot satisfy the departure limit at a genuine corner, the limit shall not be relaxed: the follower shall approach the corner, pivot, and perform a committed straight capture on the outgoing edge. Every planned connector and area-boundary execution path shall fail closed when its mower-centre geometry cannot be validated inside the allowed area and outside obstacles; an unsafe fallback path shall never be returned for execution.

There is a need to be able to trace around obstacles using manual driving and then have the mower re-trace that path whilst mowing. 

A path driving component is required which will take an array of path points which may be far apart or very close together and drive that path and return.

### Tracing

The user will be able to use manual driving or simply dragging the mower around an obstacle. The position part only is obtained and logged every time it moves more than 10cm.
Path and area-perimeter recording shall accept fused GNSS and dead-reckoning poses from pose fusion, shall ignore unknown-quality poses, and shall reject implausible jumps between consecutive recorded points, so degraded positioning cannot write large spikes into saved boundaries.

The root web page is the combined Drive & Paths page for this purpose, with the live manual-drive canvas at the top and the path recording and management controls alongside it.

A path will be associated with a name which will default to 'Obstacle N' where N is an increasing number based on already stored obstacles.  The user can add new names. For any name, the user can erase which removes it completely or they can 'record' in which case it starts capturing the path as the user moves/drives the mower. And a 'stop and save' button which will persist the array of positions against the name.

The same page shall also support recording one or more named mowing area perimeters. A mowing area perimeter is captured from position samples every 10cm, is persisted separately from obstacle perimeters, and defaults to a generated mowing-area name when the operator does not provide one. The live canvas shall auto-scale to show the current position history, stored obstacle perimeters, and stored mowing area perimeters together. During mowing, the runtime shall append the fused pose to a mower-owned JSONL progress file at 1 Hz. The Drive & Paths page shall load that file once when the page starts, then extend the displayed trail from live pose polling without repeatedly re-reading the file. The mowing-progress trail shall remain at constant opacity and persist across Wi-Fi loss, page refreshes, and **Carry On Mowing** operations. The runtime shall clear the progress file only after a new **Mow Area** or **Mow From Perimeter** request has been validated and begins successfully; **Carry On Mowing** shall append to the existing file. A large position discontinuity shall break the rendered trail rather than erase previously recorded progress or draw a false connecting segment.
Operators shall avoid deliberately starting or stopping a mowing area perimeter recording on a sharp corner. When a recorded mowing area loop closes with a rough non-corner seam, the perimeter cleaner may locally blend roughly 1 metre of the start/end neighbourhood using the neighbouring tangents before adaptive smoothing so the join becomes a single smooth boundary rather than a kinked splice.

For a selected mowing area perimeter, the page shall be able to preview logical mowing strips before motion starts. The operator can choose the strip heading, including by dragging a line on the canvas, and can choose the strip spacing. Explicitly clicking **Preview** shall clear the previously displayed and browser-stored mowing-progress trail so the generated plan is shown on a clean canvas; restoring an existing preview or editing its controls shall not clear that trail. The initial strip spacing shall be 30cm for the 40cm blade width to provide overlap. Once changed, the strip spacing shall be persisted in browser storage and restored after page refresh in preference to the default or an older area-capture value. The exact last generated preview shall also be persisted and restored with the mower's stored mowing-progress trail; restoring the page shall not regenerate or reorder the preview using the mower's current pose. When an active or resumable mowing operation has a frozen execution plan, that authoritative plan shall take precedence over the browser snapshot. The system shall clip the parallel strip lines to the selected mowing area perimeter and draw the resulting strips on the canvas.

Mowing strip previews shall treat recorded obstacle perimeters as exclusion zones. Strips shall be split rather than crossing obstacle boundaries, and connector previews between strips shall route around an obstacle perimeter when the direct connector would cross the obstacle.

### Re-tracing

From the same page as for tracing the obstacle's perimeter, there will be a button to 'Drive'.

There will also be a button to 'Verify'.

The drive button shall immediately follow the stored path from the mower's current position.
The verify button shall first execute a segment-style approach to about 10cm short of the nearest recorded point, then continue around the stored path until it returns to that join point. The 10cm standoff exists so the mower has body clearance to turn on the spot at arrival without fouling the recorded edge; it is not an inflation of the path itself.

Stored obstacle and area perimeter traces shall use the continuous path follower so the mower stays in smooth line-following mode once it has joined the perimeter. The complete reference polyline shall remain the execution geometry; it shall not be replaced by fitted circles or corner-cutting chords. Before motion, the complete route shall be sampled at 5cm spacing and assigned one stable lookahead between 25cm and 1 metre. The chosen value shall be the longest 5cm-increment candidate whose chord at every sampled route position remains within 5cm of the intervening reference path. The arrival section alone shall never impose the traversal lookahead. Before issuing its first forward command, the follower shall align once through `TurnController` when the live heading is outside the configured alignment tolerance of the initial moving-lookahead direction; this entry rule applies equally to new, resumed, return-to-start, recharge, and manual continuous routes. The moving target shall then advance by true ordered route distance during control while CTE remains referenced to the current path segment. Ordered projection shall search far enough forward by physical route distance to accommodate several densely sampled points without selecting a waypoint already behind the live pose. Meaningful corners shall cap lookahead at the corner. A lookahead target coincident with the current waypoint shall retain the incoming path heading and shall not create a synthetic outgoing heading. After entry alignment, the continuous steering loop shall have one behaviour only: forward differential steering toward the moving lookahead. It shall never independently request a pivot, recovery, or point-to-point segment drive because of accumulated lookahead curvature or heading error. The faster forward wheel shall remain at the requested mowing output while the inner wheel may slow continuously to zero, allowing the mower to turn about one stationary wheel without stopping. A genuine local waypoint corner identified by the execution-level corner test shall be the only mid-route stop-and-turn case; it shall delegate one outgoing-edge capture of up to 40cm to the ordinary drive controller, which owns the TurnController alignment and straight capture. Route-distance protection shall reject a gross departure beyond twice the corridor immediately, but an ordinary threshold crossing shall have to persist for ten consecutive 50Hz control samples before aborting; a single sample just beyond the threshold shall not stop mowing or start another motion mode. Wheel commands shall be rate-limited between control cycles. Verification, mowing first-encounter boundary traces, and longer perimeter-style inter-strip connectors shall reuse this follower and persist the exact ordered route and completed target index across mowing resume. A finite boundary trace shall finish when ordered progress has reached its final target and the mower has returned within the configured closed-loop detection tolerance. After tracing a boundary encountered at an unmown strip entrance, the ordinary pivot-then-straight controller shall rejoin that strip's inward standoff before strip mowing resumes. Every safe two-point inter-strip connector, regardless of length, shall use the ordinary pivot-then-straight `DriveController`; safe short multi-point connectors of at most 1 metre may also be simplified to that controller, while genuinely routed multi-point connectors retain their planner-provided path and use the aligned continuous follower.

Direct connector simplification shall be allowed only when the live-pose-to-target chord passes the same strict area and obstacle validator used immediately before translation. A chord that cuts across an area concavity shall retain or locally rebuild its routed connector. The 25cm outside-area allowance applies only when the mower is already just outside and the recovery segment moves monotonically inward.

Corner braking shall use the learned stop trigger for the full original incoming-edge length, even while continuous steering corrects CTE on that edge. The continuous follower shall retain ownership throughout: it requests neutral once, waits for calibrated ramp-down and pose settling, verifies arrival at the original vertex, turns once to the outgoing heading, and resumes continuous following. The corner shall not be consumed merely because ordered projection reaches or passes it. No capture chord or forward/reverse corrective translation shall be issued; a settled miss beyond the larger of the configured pivot distance and ordinary segmented-drive CTE limit shall fail closed.

Ordinary point-to-point segment drives shall turn in place when alignment exceeds the normal turn threshold and then drive a straight line. A target inside the 15 cm minimum useful translation distance shall instead be accepted before any alignment turn. After a strip-entry pivot, a settled position inside that same deadband shall be accepted without a corrective centimetre-scale drive or a second turn when heading is already suitable for the strip. Curved driving is reserved for continuous perimeter and obstacle-path following. Continuous lookahead may span gentle successive curve points, but shall stop at a meaningful recorded corner so the controller neither rounds an obstacle corner nor cuts across an area boundary unnecessarily.

Immediately before executing a planned inter-strip connector, the executor shall validate it against the same authoritative mowing area and obstacle geometry used for live safety. If that frozen connector is unsafe from the settled strip-end pose, the executor shall preserve its intended destination and make one local routing attempt from the current fused GNSS position to that destination. If continuous following subsequently aborts because the live pose has persistently left the connector corridor, the executor shall make the same single local routing attempt from the new settled pose rather than stopping the entire mowing job for a recoverable connector miss. A safe replacement shall be persisted as the active connector operation and executed without regenerating or reordering the remaining mowing plan. An unavailable, unsafe, or repeatedly failed replacement shall fail closed with the specific connector error.

A continuous follower shall reject recovery motion when the live pose is more than the minimum continuous lookahead from its ordered route and shall command neutral motor output before every successful, stopped, or failed return. When resuming a boundary trace from a live pose 25 cm to 1.5 m from the saved remainder, mowing shall discard the stale join, use the ordinary segment drive to reach a verified safe tangent-approach point, use the ordinary turn controller to align with the chosen perimeter direction, and only then start continuous following from genuine perimeter points. The displaced live pose shall never be prepended to the closed perimeter because that would create both an unsafe approach chord and a synthetic corner. When resuming an interrupted inter-strip connector from more than 25 cm away, mowing shall preserve the frozen strip order, locally plan a safety-checked transit from the current fused pose to the saved pending connector target, append the untouched remainder of that connector, persist the replacement as the active resume operation, and execute it from its first moving target. If no safe transit exists, recovery shall fail before commanding motion and expose a specific resume error. Greater boundary displacement or an unsafe boundary approach shall likewise fail before commanding perimeter-follow motor motion.

Before starting a perimeter follow, the runtime shall choose the nearest recorded perimeter point, turn to align tangentially with the selected travel direction, then re-evaluate the nearest join point from the post-turn pose while preserving that chosen direction. This prevents the mower from short-cutting the loop or jumping into the wrong lane after the alignment turn.

The recorded perimeter points are the boundary to follow as faithfully as the simplifier allows. No outward inflation is applied to either obstacle or area perimeters; the original manually driven trace is presumed to already respect the safe edge of the obstacle or area.

Driving a mowing area perimeter assumes the mower is already on or close to the perimeter: the runtime shall choose the nearest recorded perimeter point and continue in the direction that best matches the mower's current heading. Verifying a mowing area perimeter shall drive to the nearest perimeter point, stop there, turn to align with the chosen path direction, then continue around the perimeter using the same continuous path follower as the other perimeter workflows.

At execution time the segmented executor shall re-anchor the target list to the nearest target to the mower's current pose and skip targets already reached, so it resumes from where the mower meets the boundary rather than returning to the saved path's first point. The executor shall abort the run if the measured segment cross-track error exceeds the configured path-following limit.

Generated strip previews define geometry only. They do not start mowing motion until an execution workflow is added.

The closed-loop tolerance, closed-loop detection tolerance, verification approach standoff, verification turn-only distance, segmented-drive simplification tolerance, segmented-drive maximum vertex turn angle, segmented-drive maximum segment length, segmented-drive minimum segment length, segmented-drive maximum CTE, and path-retry reverse distance shall be loaded from persisted path-following configuration rather than being hard-coded in the path helpers.

A "Stop" button shall be prominent on the screen and immediately terminate a drive.

Driving should initially be performed at full speed as this ensures the blades are moving quickly and it overcomes the friction — a slow drive could get stuck. The fastest forward-moving drive wheel powers the rotating blades, so autonomous forward steering may reduce the inner wheel but shall keep the outer wheel at the requested full output. It shall not reduce both forward wheel outputs together in response to curvature, heading error, or cross-track error. When the requested curvature cannot be achieved reliably within the available differential output, the mower shall stop, pivot, and then resume forward travel.

## Obstructions - retry

The mower has two current meters; one for each motor. The system shall classify obstruction events into three types:

- **high_current** — either motor draws above the configured current threshold (currently 10 A pending validation of the installed sensors). This is treated as the mower hitting thick grass or a clump that the blades may yet cut through with another run-up.
- Motor-feedback integrity is safety-critical: impossible encoder deltas shall be rejected, feedback recovered after an outage shall not be trusted until three consecutive coherent frames have arrived, and ten consecutive failed polls shall latch a system stop and request a hardware motor disable. Repeated identical poll failures shall be rate-limited in the session log and summarized on recovery.
- The Pi shall establish a disabled motor command during hardware initialization and refresh the latest active, neutral, or disabled command before the ESP command lease expires. Idle motion-start checks shall therefore observe a current healthy watchdog without enabling the H-bridges, while loss of the Pi heartbeat shall still expire the lease and leave drive disabled.
- **wheel_slip** — wheels are turning per encoder feedback but the fused position is effectively stationary.
- **stall** — trusted GNSS position remains stationary during translational driving, IMU heading remains stationary during a pivot, or motor current remains high while motion is commanded. Encoder-stationary evidence is a fallback when the motion-specific reference is unavailable; spinning encoders do not by themselves prove chassis progress.

`high_current` events trigger the configured obstruction recovery. In addition, a GNSS non-progress `stall` during an active mowing-strip translation may be retried exactly once when the triggering feedback reports no sustained high current and no motor-controller fault flags. The strip drive shall first settle under the global sensor stop, then require a fresh GNSS-quality pose and revalidate the direct line from that pose to the unchanged persisted strip target against the mowing area and every obstacle. Only that specific `motor_stall_detected` stop may then be cleared before the normal turn-then-drive controller is invoked again.

A second stall on the same strip attempt, an unsafe or unavailable retry line, loss of GNSS quality, an operator or area-safety stop, a pivot stall, or a fault/high-current stall shall not be cleared by this one-shot path. `wheel_slip` and all other `stall` events shall stop the active operation and abort the session.

The high-current retry strategy depends on the active operation:

- **Line driving**: reverse for the configured duration (initial 2 s, roughly half a metre at full speed), settle, then drive forward to the original target again.
- **Path following / boundary tracing**: stop the segmented executor cleanly, then retrace the most recently completed targets backward — re-issuing each as a reverse-direction segment drive — until measured reverse displacement reaches the configured retreat distance (initial value 0.5 m). Each reverse leg must report success. When no completed target is available, the timed reverse must complete and produce at least 10 cm of measured chassis displacement. A stopped reverse, a reverse with insufficient displacement, or a stall/wheel-slip event during recovery shall abort the session and shall not restart the boundary follow. Once clear, restart the same boundary follow; the executor resumes from the current location.
- **Turn on the spot**: turn the opposite direction for the configured escape duration, then resume the original turn from the new heading. Angles must be managed so that the original target heading is still reached even after the back-up.

If the same operation accumulates more than the configured maximum number of high-current retries (initial value 3) without making progress, the session shall be aborted and the motors powered off.

Logging shall indicate that the retry has occurred, which obstruction type was detected, and the context (line driving, path following, or turning).

## Mowing Strip Planning

### Strip geometry

The mowing planner divides a recorded area perimeter into a set of parallel mowing strips whose axis is set by the operator-chosen heading angle.  The planner projects the perimeter polygon onto the normal to that axis and generates one strip line per spacing interval across the full width of the area.  Each strip line is then clipped to the area polygon boundary so strip endpoints land exactly on the perimeter.  Where a recorded obstacle polygon intersects a strip, the overlapping section is removed and the strip is split into two or more shorter sub-strips, each of which is treated as an independent mowing segment.  The strip spacing defaults to 30 cm for a 40 cm blade to provide a 10 cm overlap on each pass.

### Traversal sequencing and directional consistency

Once all strips are computed the planner sequences them as an adjacent-strip sweep. The first strip is chosen at the lowest normal-axis offset and entered from the end with the highest projection along the mowing direction, or is chosen nearest a supplied perimeter start. After the first transition the planner records which side of the area (which normal-axis direction) it advanced toward and locks that crossing direction in for the remainder of the plan. The preferred start affects only the first strip. Subsequent choices must use the next unmown normal-axis offset in that direction while one remains; only when the local sweep is exhausted may the planner cross back or seek an isolated fragment.

Geometric strip fragments shorter than 30 cm shall not enter the executable mowing sequence or create their own sweep regions. These narrow boundary slivers are covered by the mandatory area/obstacle perimeter trace. The 30 cm planning minimum deliberately exceeds the drive controller's 15 cm minimum command so pose settling and arrival tolerance cannot turn a previewed cutting pass into a sequence of stationary turns. The executor shall never count a drive explicitly skipped as below the minimum command distance as a completed mowing strip.

When adjacent measured strip traces prove a cutter-width coverage gap for the configured confirmation distance, the mower shall drive the full bisector between those traces and then remow the current strip. The repeat restores the mower to the current strip's planned exit so the alternating traversal direction and the next persisted connector remain correct.

Before a mowing point-to-point movement, the 15 cm minimum useful translation shall be checked before an initial alignment pivot and again after any necessary pivot. A target already inside that deadband shall not cause a stationary turn. At strip entry, residual heading within the ordinary 5-degree line-drive turn threshold shall be left to forward CTE/heading convergence rather than causing an immediate opposite corrective pivot.

Mowing start and resume require both a fused pose whose position quality is `gnss` and an IMU heading that has been synchronised to an individually accepted absolute GNSS heading since the current pose-fusion process started. If GNSS position is unusable at start, mowing shall remain stopped with reason `poor_gnss`; if the absolute heading baseline has not yet been established, it shall remain stopped with reason `gnss_heading_not_synchronized`. Once established, heading synchronisation remains valid while the IMU owns heading between safe stationary GNSS rebases; an isolated rejected GNSS-heading epoch shall not erase that established baseline. If pose quality remains below `gnss` for 2 seconds during mowing, the runtime shall request a global stop with reason `poor_gnss`. Brief validator transitions shorter than that debounce do not stop an otherwise healthy mow. This gate applies to autonomous mowing only.

Drive and turn learning shall obey `config/learning-policy.json`. The default `training_only` mode permits parameter updates only for dedicated web tuning and validation sessions; ordinary mowing, path driving, retries, and ad-hoc movement shall use the learned parameters without modifying them. An explicit `always` mode may enable operational learning for controlled experiments.

Within each strip the mower always enters at one end and exits at the other, giving a boustrophedon (back-and-forth) pattern across the area. A directly reachable fragment on the adjacent offset always outranks a candidate that requires obstacle-perimeter routing, regardless of route-cost score. Cost scoring chooses only among candidates that satisfy those sequencing constraints.

Disconnected sweep regions shall be ordered as the open route that the mower will actually execute from its selected entry. Transition scoring shall use a bounded geometric distance plus a penalty when direct travel is unavailable, so region ordering remains responsive for complex lawns. Complete safe connector geometry shall then be constructed and validated for every selected transition; an unsafe selected route shall fail planning. The planner shall not optimise an artificial closed regional cycle and then rotate that cycle to the entry point.

### Boundary standoff distance

No mowing strip or connector segment shall bring the mower closer than 15 cm to any recorded boundary (area perimeter or obstacle perimeter) unless that boundary is being explicitly driven as part of a boundary-tracing pass (see below).  This standoff gives the mower sufficient room to execute a turn-on-the-spot at a strip end without fouling the boundary.  The standoff distance of 15 cm is a configurable parameter stored in the path-following configuration.

### First-arrival boundary tracing

For Carry On, trusted GNSS means both trusted fused position and an accepted absolute GNSS heading baseline established during the current pose-fusion process; checking position quality alone is insufficient.

The first time the mower reaches any boundary — whether the outer area perimeter or an obstacle perimeter — during a mowing session it must perform a complete boundary trace of that boundary before continuing with strip mowing.  This ensures a clean mowed edge is cut all the way around the area and around each obstacle, which the strip pattern alone would not achieve since strips stop short of the boundary by the standoff distance.

When mowing stops or errors after an operation has begun, the Drive & Paths page shall offer a **Carry On Mowing** control. Carry On shall be rejected before clearing the global stop unless fused pose quality is trusted GNSS and motor feedback has produced at least three consecutive coherent frames, the newest no more than 250 ms old, with no watchdog failure or motor fault flags. The saved state shall include the active operation, its exact ordered route and, for continuous boundary or connector following, the completed target index so resumption continues from the interrupted ordered path position rather than restarting the saved execution geometry. An interrupted multi-point connector shall always be replaced by a validated route from the current fused pose to its saved pending target, followed by the untouched connector remainder, even when the mower remains inside the old route corridor. An interrupted mowing-strip translation is the exception: if the mower has not reached that strip's exit target, Carry On shall first return to the frozen plan's entry standoff for the current strip, then turn and mow that strip again from start to finish before continuing the unchanged strip sequence. The control shall become available after the active executor has settled and shall remain available across process restarts while the saved state exists. A temporary failure of any initial page request shall not prevent later mowing-status polling or leave Carry On permanently hidden, and Start/Carry On actions shall allow only one request at a time. If the resumed GNSS pose is outside the mowing area by no more than 75 cm, Carry On shall first find the nearest perimeter point, construct a target at least 25 cm inside the area, reject a recovery line that intersects an obstacle, pivot toward that target through the ordinary drive controller, and drive into the area before continuing the saved operation. A resumed pose materially inside a recorded obstacle shall fail closed with the obstacle index and live coordinates logged so the operator can carry the mower into mapped free space. The sole automatic exception is a fused-control-point offset no more than 25 cm inside one obstacle after a wheelbase-contained pivot: the executor may follow only the unchanged saved point-to-point target when that target is outside every obstacle, 5 cm samples of the complete line remain inside the mowing area, avoid every other exclusion, monotonically reduce penetration into the source obstacle until clear, and the settled forward heading itself immediately reduces that penetration. This same bounded check applies immediately after a mowing-strip entry pivot, so a mower already facing safely out may proceed without an artificial stop-and-resume cycle. A deeper start, a tangential or initially inward heading, a line that moves farther inside, re-entry, another obstacle, or any unsafe target shall remain stopped. After outside-area recovery, this bounded obstacle-offset recovery, or operator relocation, any saved point-to-point operation shall be checked from the new live pose: a direct line that leaves the area or intersects an obstacle shall be replaced by a safety-checked, persisted mowing transit route rather than issuing one unconstrained straight drive to the stale target. An unsafe live pose, a farther outside pose, unavailable safe target, blocked or unsafe recovery route, or failure to enter the polygon shall fail closed without resuming mowing.

An interrupted boundary trace shall rebuild its boundary join from the settled live pose before continuing. Carry On shall not replay a failed corner capture against the same stale incoming baseline.

During each mowing-strip translation the executor shall retain a spatially sampled trace of trusted fused positions. The terminal trace point shall use the drive result's final position when supplied and otherwise the current trusted fused position. After a strip completes, consecutive strips in the same sweep region shall be compared along their shared mowing axis. If the perpendicular separation of the two actual traces exceeds the plan's cutter width for at least 20 cm, the executor shall create a temporary line whose corresponding endpoints are the midpoints of the two actual driven traces. It shall mow that bisector in the previous strip's direction, then re-mow the current strip in its original direction before proceeding. The repair sequence and its line anchors shall be resumable, and each adjacent pair shall receive no more than one automatic repair.

The sequence on first arrival at a boundary is:

1. **Stop short.** The mowing strip or connector brings the mower to within the standoff distance (15 cm) of the boundary, then stops.  The boundary is flagged as not yet traced.
2. **Align to the boundary tangent.** The mower turns on the spot to face tangentially along the boundary at the nearest recorded boundary point, choosing the direction that will travel around the boundary in the correct orientation (clockwise around obstacles, following the recorded direction for the area perimeter).
3. **Line-follow the boundary.** The mower switches to the continuous path follower and follows the recorded boundary path at the highest configured non-stalling output. For a known sharp corner, that same follower shall use the original incoming edge's learned braking distance to settle at the exact recorded vertex, turn to face the outgoing edge, and continue. No second line-drive manoeuvre shall be inserted. The trace continues until it returns to the point at which it joined the boundary — the join point is detected when the mower is within the closed-loop tolerance of that starting point and has travelled enough distance to have genuinely completed a loop.
4. **Mark boundary as traced.** The boundary is flagged as fully traced for this mowing session.
5. **Resume strip sequencing.** The mower returns to the strip end at which it first stopped and continues the normal strip-mowing sequence from that point.

### Connector routing at strip ends

At the end of a mowing strip the mower cannot simply drive a straight line toward the start of the next strip.  The perimeter boundary, an obstacle edge, or uneven terrain may lie immediately in that direction, and driving blindly across unknown ground risks the mower falling into a hole, hitting a kerb, or colliding with an obstacle.

The safe transition sequence at a strip end is therefore:

1. **Stop at the standoff point.** The strip drive ends when the mower reaches the point on the strip that is the standoff distance back from the boundary.  If this is the first arrival at this boundary the mower performs the boundary trace described above before continuing.
2. **Turn to face along the boundary.** The mower performs a turn-on-the-spot to align its heading tangentially with the recorded boundary at the nearest boundary point.
3. **Line-follow the boundary to the next strip entry.** When the connector contains a perimeter leg, the mower stays in the same continuous path-following mode and travels along the recorded boundary — known safe ground — until it reaches the standoff point of the next strip's entry end.  Because the boundary has already been traced at this stage, this leg travels inward of the boundary by the standoff distance rather than on the boundary line itself.
4. **Segment drive down the next strip.** At the next strip's entry standoff point the mower executes a segment drive: it turns on the spot to face along the strip axis and then drives the strip in a straight line using the straight-line drive controller until it reaches the standoff point at the far end.

This means inter-strip travel is always composed of two phases: a boundary-following phase (safe known ground, inside the standoff margin) and a segment-drive phase (straight mowing pass).  The planner pre-computes the full sequence of strip standoff endpoints and connector waypoints before motion starts so the operator can preview the entire planned route on the canvas.

### Cost model summary

The total connector cost between two strips is the geometric path length of the connector: the Euclidean distance, or the obstacle-perimeter walk distance when a direct line would cross an obstacle.

The planner selects the traversal sequence that minimises total connector cost across all strip transitions, minimising total non-mowing travel distance.
