davidgoddard/mower2026/docs/system-map.md

# System mapping

This document maps problem domains to candidate files removing the need for Codex to scan files looking for where logic etc. is located

## Constants
- `src/constants.ts`: system-wide DESIGN DECISION constants (see `docs/CONSTANTS-ARCHITECTURE.md`).
  - timing design decisions: sensor poll intervals (sensor loop / IMU 100Hz, GNSS polling 20Hz, motor polling 50Hz), pose-fusion downstream emit cadence (50Hz), manual drive loop rate, retry policies
  - authoritative Pi-side I2C defaults: GNSS (0x52), motor (0x66), IMU (0x69), and bus number (1); production startup, server/gateway fallbacks, sensor modules, and manual hardware utilities import these values rather than repeating literals
  - ESP32 sketches retain their own compiled slave-address constants because they cannot import the TypeScript module; those firmware constants must match the Pi-side defaults
  - manual drive tuning: 12 parameters for joystick response, deadbands, spin thresholds
  - motor configuration: direction signs for hardware inversion, max wheel speed
  - network configuration: HTTP server defaults, port validation
  - calibration parameters: IMU sample count
  - turn controller parameters: polling interval, settle times, learning rate, angle handling
- Implementation constants (protocol formats, scaling factors, register values) are LOCAL to their modules, not in this global file.

## Configuration
- `src/config/jsonFileStore.ts`: shared JSON persistence helper for config files.
- `src/config/motorCalibration.ts`: motor ramp calibration and persistence.
- `src/config/imuCalibration.ts`: IMU yaw scale calibration and persistence.
- `src/config/poseCalibration.ts`: encoder calibration persistence (per-direction left/right m/tick are optional Phase-4 fields; pose fusion picks forward vs reverse per encoder-delta sign when both are present, otherwise falls back to the symmetric values).
- `src/config/geometryCalibration.ts`: body-frame GNSS-to-vehicle reference offset persistence.
- `src/config/pathFollowingConfig.ts`: path tracing/following safety parameters for closed-loop detection, approach standoff, turn-only threshold, segmented-drive simplification (chord tolerance, max vertex turn angle, max/min segment length, max CTE), and path-retry reverse distance.
- `config/motor-calibration.json`: persisted motor calibration values.
- `config/imu-yaw-calibration.json`: persisted IMU yaw scale factor.
- `config/pose-calibration.json`: persisted pose calibration values.
- `config/geometry-calibration.json`: persisted GNSS position offset values for the vehicle control point.
- `config/path-following-parameters.json`: persisted segmented-drive perimeter follow parameters.
- `config/drive-learning-params.json`: persisted drive learning values, including forward/reverse CTE proportional and damping gains plus qualified operational steering sample counts.
- `config/turn-learning-parameters.json`: persisted turn learning values.
- `src/config/mowingRecordsStore.ts`: atomic JSON persistence for completed mowing history, reusable area/heading/strip-width presets, and blade-sharpening distance settings/usage.
- `src/maintenance/bladeUsageTracker.ts`: accumulates blade wear from the hardware gateway's already-normalized motor feedback as the larger calibrated logical-forward encoder distance in each sample; reverse wheel movement is ignored and usage is periodically persisted by `MowingRecordsStore`.
- `data/mowing-records.json`: runtime-created mowing records datastore.

## Heading and Angle Types
- `src/geometry/headingTypes.ts`: branded types for heading representations to prevent mixing incompatible angle conventions at compile time.
  - `FieldHeading`: GNSS/navigation heading, clockwise from north, range [0, 360)
  - `InternalHeading`: Cartesian heading, counterclockwise from +X axis, range (-180, 180]
  - `RelativeAngle`: signed angular difference for turns/errors, range (-180, 180]
  - `RawAngle`: unnormalized angle marker type
  - conversion functions: `fieldToInternal()`, `internalToField()`
  - angle operations: `headingDifference()`, `addRelativeAngle()`
  - normalization: `normalizeAngleTo180()`, `normalizeAngleTo360()`
- `test/headingTypes.test.js`: comprehensive tests for heading type system including edge cases and real-world scenarios.
- `docs/heading-types-guide.md`: developer guide for using branded heading types safely.

## Logging
- `src/logging/sessionLogger.ts`: public async logger API and session lifecycle management.
- `src/logging/logWriterWorker.ts`: dedicated worker-thread JSONL writer.
- `src/logging/types.ts`: logging entry and API types.
- `src/logging/index.ts`: logging exports.
- `test/logger.test.js`: logger unit tests (local timestamp format, scope, transitions, retention).

## UI Dialogs
- `src/server/homePage.ts`: full expanded sensor/control dashboard served at `/dashboard`; the root route now serves Drive & Paths.
- `src/server/appDialogs.ts`: shared lightweight modal alert/confirm overlay used by operator pages.
- `src/server/manualDrivePage.ts`: Drive & Paths page asset loader and HTML/CSS/JS assembly for the manual-drive UI.
- `src/server/manual-drive-page/page.html`: Drive & Paths HTML shell.
- `src/server/manual-drive-page/page.css`: Drive & Paths styles, including map/layout styling and the responsive stored-perimeter editor modal.
- `src/server/manual-drive-page/page.js`: Drive & Paths browser logic for map drawing, mowing preview, recording, and path actions.
  - an explicit mowing-plan Preview click clears the displayed/browser-stored mowing-progress trail before generating the clean preview; restoring previews and changing controls leave progress intact
  - initial page loading tolerates individual request failures and always starts the recurring state/status poll, so a brief server restart cannot leave Carry On hidden permanently; mowing Start and Carry On requests are single-flight to prevent duplicate submissions
  - mowing previews shade the strips by planned region so the selected regional traversal is visible before motion
  - served as the `/` home screen (and at `/manual-drive`) with compact live IMU, GNSS, and motor-odometry widgets linking to `/dashboard`
  - area-perimeter saves include the current mowing strip heading and strip spacing, and selecting an area restores those saved defaults into the preview controls
  - the mowing controls also expose a perimeter-entry start path that skips the initial area loop trace and goes straight into the first strip
  - each stored mowing area exposes an editor that overlays the original and proposed boundaries, supports two-anchor straightening and two-anchor/one-control-point corner reshaping, undo/reset, and explicit save
  - the homepage header includes navigation to all operator pages, and its mowing controls can apply reusable presets while still allowing per-run angle and width edits
  - the selected reusable mowing preset is retained in browser storage across page refreshes; manual area, angle, or width changes return the selector to custom settings
- `src/server/mowingRecordsPage.ts`: left-aligned mowing history, reusable definition, and distance-based blade-sharpening maintenance page served at `/mowing-records`; definition inputs call the production mowing-plan preview API and render the selected area with its generated strips for fine tuning before save, with visible mutation feedback plus picklist, pointer, and keyboard selection for loading and previewing saved definitions. Maintenance and definition forms preserve unsaved fields across data reloads and expose adjacent Cancel buttons that restore server values before refreshes resume.
- `src/server/appServer.ts`: mowing-definition saves validate area display names through `PathStore.pathExists()` so names containing spaces resolve to the same sanitized file used by preview and loading.
- `src/server/turnTuningPage.ts`: turn tuning UI uses the shared popup overlay for alerts and confirm prompts.
- `src/server/driveTuningPage.ts`: drive tuning UI uses the shared popup overlay for alerts.
  - staged tuning flow: short-distance brake/CTE learning, long heading-bias tuning, and long heading-gain tuning
- `src/server/segmentTestingPage.ts`: segment testing UI uses the shared popup overlay for alerts.

## Stop State
- `src/control/systemStop.ts`: global stop latch for user actions, timeouts, and runtime safety faults.
- `src/server/appServer.ts`: stop API entry points and operation reset wiring.
  - `POST /api/stop` is the unconditional emergency-stop route used by the web UI; it raises `systemStop`, immediately sends a hard motor halt, and then fans out stop requests to active controllers/runners.
  - every other POST action route clears `systemStop` before handling, so any non-stop operator action on the web UI re-enables motion after a prior stop button press
- `src/sensing/sensorController.ts`: sensor loop stop checks and stop-command keepalive while stopped.
  - while the global stop latch is set, ordinary wheel-output writes are suppressed before they can alter commanded state or reach I2C; the sensor loop keeps reasserting disabled frames until a new user-requested session clears the latch
  - neutral stop requests while `systemStop` is latched must resend disabled motor frames rather than zero-speed enabled frames, so the ESP32 keeps seeing a hard stop and never resumes on a stale command
  - stall progress is motion-specific: trusted GNSS displacement for translation and IMU heading change for pivots; encoder rotation alone does not prove chassis progress, while at least 2.8 A sustained for roughly two seconds is independently sufficient to stop, with 2.6 A clear hysteresis
  - IMU yaw-bias auto-recalibration is idle-only: motion-session owners suppress it during tuning/test runs, and the controller only re-arms after a long idle period.
  - GNSS-to-IMU heading rebase readiness ignores motor encoder feedback: rebasing is blocked for the full lifetime of every motion session and until motor commands are zero, fresh IMU yaw-rate samples remain within 1 degree/second for one continuous second.
- `src/control/manualDriveCoordinator.ts`: manual-drive stop clearing and disconnect handling.
  - live HID input while manual drive is armed clears a latched global stop so the operator can consciously recover from a stall/stop during manual manoeuvring
  - unchanged held-stick commands are coalesced; the motor I2C client is the sole owner of latest-command heartbeat refreshes, including neutral and disabled states, while HID snapshots retain their independent stale-input halt window
  - shutdown now unregisters HID event listeners and closes the controller before awaiting the control-loop drain, so tests and process shutdown do not stay alive on stale manual-drive events
- `src/control/turnController.ts`: turn stop checks and stop handling.
  - IMU heading watchdog timers are internal safety timers only and are `unref()`'d so an abandoned turn test does not keep Node alive by itself
  - owns its sensor motion session until the asynchronous turn result resolves, including ramp-down, settling, and final IMU measurement, so pose fusion cannot rebase heading mid-turn
  - small turns brake from live IMU angular progress and rate multiplied by the learned angle/direction coast horizon; elapsed time alone cannot terminate a slow or traction-limited pivot
- `src/control/driveController.ts`: drive stop checks and stop handling.
- `src/pathfollowing/segmentedBoundaryExecutor.ts`: perimeter-follow stop checks and stop handling.
- `src/pathfollowing/mowingExecutor.ts`: mowing workflow stop checks while approaching, tracing, mowing, and following connectors.
  - Carry On first recovers a GNSS pose up to 75cm outside the area to a validated 25cm-inset target through the ordinary pivot-then-straight drive controller; farther, blocked, or unsuccessful recovery fails closed
  - after outside recovery, a saved point-to-point operation is never driven blindly from the new pose: an area- or obstacle-crossing direct segment is replaced by a validated and persisted transit route to the unchanged target
  - continuous operations persist their exact ordered route with progress and validate connector samples against the area and obstacles before initial or resumed execution
  - area boundary tracing now uses the continuous follower and aborts the mow if tracing fails, instead of continuing into strips from a bad pose
  - after tracing a boundary encountered at an unmown strip entrance, re-approaches that strip's inward standoff through the ordinary pivot-then-straight drive controller before strip mowing resumes, including after resume
  - before a normal or resumed strip drive, validates settled pivot displacement (15 cm anomaly threshold), immutable-baseline CTE (1.5-times recovery hysteresis around the configured CTE limit), and residual heading; an excessive result at least 25 cm from entry gets one geometry-checked return to the frozen entry and one final turn, while a closer correction keeps the settled strip heading and delegates residual convergence to the immutable-baseline strip controller instead of point-facing toward a target too near to translate usefully
  - normal mowing segment requests use the 15 cm post-pivot minimum translation; the single exceptional strip-entry correction disables that deadband so an observed position error above the configured 5 cm CTE limit can actually be corrected; routed connectors and perimeter traces use the conservative continuous follower
  - an unsafe frozen inter-strip connector receives one local repair attempt from the current fused pose to its unchanged destination; the replacement must pass executor safety validation and is persisted for resume without replanning the remaining strips
  - area-escape monitoring uses an `unref()`'d interval so safety polling still works during execution but does not pin test shutdown if a run aborts early
  - after the final strip, follows the shorter direction around the recorded area perimeter and then returns to the session's original GNSS start position; the return path and start point are persisted for stop/resume recovery
  - qualified strip-entry pivots identify themselves as mowing turns so the configured mowing-and-training policy can update turn learning
- `src/pathfollowing/mowingCoverage.ts`: compares adjacent measured strip traces perpendicular to the planned strip heading and detects sustained cutter-width gaps; constructs the full bisector between both traces for the coverage repair pass, after which the executor remows the current strip to restore the planned alternating traversal endpoint
- `src/pathfollowing/mowingPlanner.ts`: clips strips to the area and obstacles, removes sub-30cm boundary slivers that the mandatory perimeter trace covers, assigns stable sweep-topology regions only to executable passes, builds both sweep orientations for every region, and optimises the actual open route from the preferred entry using a fast distance-plus-routing-penalty estimate before fully constructing and validating only the selected safe connectors. Free-space transit routing uses the inward-offset area loop, never raw physical-boundary vertices, when a concavity prevents a direct line. Region metadata and the combined-wheel-travel estimate are persisted in the plan and returned by preview APIs.
- `src/pathfollowing/mowingExecutor.ts`: the initial approach to a selected perimeter entry uses safe transit routing from an inside start; an outside start may enter only through its nearby boundary edge on an obstacle-free inward path. An approach that would cut across an out-of-bounds corner fails before motion. This applies to both Mow Area and Mow From Perimeter.
- `src/pathfollowing/continuousPathFollower.ts`: continuous perimeter and routed-connector control that performs one TurnController-owned entry alignment before starting, then runs 50Hz forward-only differential steering with elapsed-time wheel-command slew limiting, learned forward CTE/heading gains, learned incoming-edge corner braking, ordered local-path projection, and a stable route-wide moving lookahead. The single execution-level genuine-corner test delegates only the outgoing pivot to `TurnController`; sustained route-deviation confirmation owns abort decisions.
  - applies the straight-drive learner's forward CTE-rate damping as well as proportional CTE and heading correction, logs one-second tracking samples plus a completed-run CTE summary, and aborts a persistent growing error near the configured tracking corridor instead of waiting for the broad route-loss limit
  - owns each genuine corner from incoming-edge tracking through the learned braking trigger and calibrated settle, verifies the original vertex directly, turns once to the outgoing heading, then resumes continuous following
  - contains no discrete forward/reverse corner correction and no synthetic capture chord; a missed vertex fails closed instead of starting another translation mode
  - route projection interprets the current index as the next target vertex and always retains its incoming segment; consuming a start point therefore cannot make a recharge/return transit falsely appear distant from the mower
  - ordered projection cannot select the outgoing edge of an unconsumed pivot corner, preventing a nearby hairpin exit from advancing route progress before the mower reaches and pivots at the vertex
- `src/pathfollowing/conservativeLookahead.ts`: samples the complete stored boundary at 5cm spacing before motion, independently of the mower's arrival section, and selects the longest stable 25cm-to-1m lookahead whose chords remain within the configured path-deviation budget everywhere; reports when genuine corners require learned braking and a pivot rather than relaxing safety, and normalises floating-point residue on collinear paths to zero.
- `src/maintenance/motorBatteryUsageTracker.ts`, `src/config/rechargeConfigStore.ts`, `src/server/batteryManagementPage.ts`, and recharge wiring in `src/server/appServer.ts`: integrate drive-motor current into the battery-use estimate and trigger automatic recharge only at the configured remaining-Ah reserve. Combined wheel travel remains a displayed diagnostic and never enters recharge eligibility; explicit operator recharge remains available. Recharge and return routes are geometry-validated before motion, identify whether the trigger was explicit or battery-driven in one start log, and use the routed-connector corner pivot/capture behaviour. Battery polling continues updating read-only metrics while an edited settings form is protected from replacement; Save or Cancel releases that edit lock, with Cancel reloading stored settings.

## Pose Fusion
- `docs/pose-fusion.md`: detailed pose-fusion design, end-to-end flow diagram, GNSS validator state machine, and degraded-input behaviour notes.
- `src/sensing/poseFusion.ts`: fused pose estimate
  - maintains the latest IMU/GNSS/encoder-derived pose estimate
  - throttles downstream `poseUpdate` emissions so control consumers do not rerun on every upstream IMU/GNSS/encoder event burst
  - GNSS heading accuracy and fix quality drive IMU heading priming/rebasing; GNSS position accuracy is used separately for trusting x/y pose updates
  - the first intrinsically good GNSS heading primes the IMU while stationary, then IMU remains the live heading reference; normal GNSS nudges require close agreement and a safe stationary rebase state, while five consecutive intrinsically good GNSS heading samples may rebase by any angle when the mower is stationary and safe to rebase
  - consumes only GNSS position and heading values that pass the checks for their current epoch; validator promotion/demotion hysteresis never permits an individually rejected sample to snap position or rebase heading
  - encoder-implied turn, wheelbase-derived heading, slip comparison and DR confidence are diagnostics only; no turn controller, line controller, path follower or other navigation decision consumes them
  - GNSS pose is only trusted when fix quality, position accuracy, heading accuracy, heading stability, and the current IMU/GNSS heading alignment gate all pass for the part of pose being updated
  - `getCurrentPose()` returns the latest fused pose without settling
  - sustained GNSS rejection reasons log on transition and then as one-minute summaries with suppressed-sample counts instead of producing a warning every second
- `src/sensing/gnssValidator.ts`: GNSS sample acceptance / trust state machine
  - position and heading are validated separately, with heading requiring position to pass first
  - no speed-based or meters-per-second physical-jump gate is allowed at the current project stage; trust is based on GNSS quality/accuracy plus temporal promotion/demotion and heading consistency only
  - heading trust now demotes only after a much longer failure window so brief slow-mower glitches do not flicker it off

## Motor Control
- `src/motors/motorProtocol.ts`: normalized motor command frame contract and raw motor feedback telemetry types.
- `src/motors/motorCodec.ts`: motor command/feedback frame encoding and decoding.
- `src/motors/motorNodeClient.ts`: Pi-side motor I2C client, including ramp timing injection and percent-based command transmission.
  - before the first non-zero command, sends a dedicated current-zero calibration request and waits for the ESP32 sampling window; this shared path covers mowing, web manual drive, and game-controller drive
- `src/sensing/sensorController.ts`: converts raw motor encoder deltas into wheel-speed estimates using persisted calibration.
  - runs the top-level sensor loop, with IMU on every loop tick while GNSS and motor polling run at their own lower cadences to reduce CPU and I2C load
  - exponentially backs off only failed GNSS polls to at most one per second, rate-limits repeated identical errors, restores 20 Hz immediately on recovery, and logs GNSS ESP boot-ID changes
  - rejects impossible encoder jumps, requires three coherent frames after a motor-feedback outage, rate-limits repeated poll errors, and safety-stops motion after ten consecutive failed feedback polls
  - exposes motion-start motor-feedback health: three coherent frames, a frame age no greater than 250 ms, healthy watchdog state and zero motor fault flags
- `src/sensing/sensorHardwareGateway.ts`: clamps normalized wheel outputs (`-1..1`) and applies direction mapping before sending to the motor client.
- `external-hardware/esp32/motor-controller/motor-controller.ino`: ESP32 motor controller firmware; acts as a ramped PWM bridge that applies commanded wheel targets, handles safe zero-crossing on reversals, and reports encoder/current telemetry back to the Pi without local wheel-speed regulation.
  - current zero calibration is requested by the Pi after the motor supply is available; the ESP invalidates prior drive state, forces both PWM outputs off, samples both channels together, and reports zero current before the first calibration
  - direct maintenance clients are also safe: a first non-zero command while uncalibrated is retained but cannot enable PWM until the same calibration has completed
  - no local motor-command watchdog is enforced; the node intentionally holds the last accepted command until the Pi sends a different target or an explicit disable
  - command frames and feedback-request metadata are now copied under a small critical section so the control loop cannot consume a partially written command struct while the I2C callback is updating it
- `src/motors/motorMapping.ts`: motor sign mapping and normalized wheel-output clamp helpers.

## GNSS ESP32 Firmware
- `external-hardware/esp32/gnss-mower/gnss-mower.ino`: rover-side GNSS ESP32 firmware; receives broadcast RTCM over ESP-NOW without requiring receive-peer registration, relays corrections to the UM982, parses receiver logs, and serves compact GNSS frames to the Pi over I2C. ESP-NOW startup verifies and reports fixed-channel selection, initialization, and callback registration; callback-wide packet count/source-MAC telemetry occurs before filtering, while base diagnostic probes have dedicated count/age telemetry and are never forwarded to the receiver. ESP-NOW callbacks enqueue bounded RTCM packet copies for main-loop processing, and I2C receive callbacks preload CRC-framed immutable payload snapshots with request-time freshness checks for the original ESP32. Receiver logs are checksum-validated; UART RX/TX buffering and startup servicing are bounded.
  - the 40-byte payload and 51-byte framed sample are compile-time constrained to the Pi contract; stale receiver state is published as the explicit `sampleAgeMillis=65535` unavailable sentinel rather than as a live solution
  - Pi decoding rejects that unavailable sentinel and rejects response frames whose protocol version, exact length, CRC, node/message identity, or sequence does not match the active request
- `external-hardware/esp32/gnss-base-station/gnss-base-station.ino`: base UM980 RTCM ingestion, CRC validation, bounded transmit queue and asynchronous broadcast-only ESP-NOW delivery. Each message has two identical-identity passes for direct/relay loss recovery, with one outstanding callback, stale-queue expiry and reboot recovery for missing callbacks. Send counts describe local transmissions, never rover acknowledgement.
- `test/gnssFirmware.test.js`, `test/firmware/gnss-firmware.cpp`, and `test/firmware/stubs/`: native regression tests execute both actual sketches with deterministic UART/radio/I2C substitutes.
- `docs/gnss-transport-verification.md`: firmware scheduling, build/test results and hardware acceptance procedure.
- `external-hardware/esp32/gnss-relay/gnss-relay.ino`: optional ESP-NOW range relay; filters packets by the configured base MAC, forwards each packet unchanged so the rover can deduplicate direct and relayed copies, and pulses the onboard GPIO2 blue LED after each successful forward.
- `external-hardware/esp32/gnss-base-station/README.md`: base-station wiring and peer-configuration notes.

## Turn Controller
- `src/control/turnController.ts`: turn execution controller with self-learning brake points
  - executes on-the-spot turns using IMU heading integration
  - polls heading at the sensor controller update rate
  - large-turn rate estimation uses a rolling `1000ms` IMU progress window before converting rate × learned scalar into a predicted coast angle
  - adaptive per-angle timeout learning per turn angle and direction
  - small-angle turns brake after a learned number of milliseconds from turn start
  - large-angle turns use live angular velocity multiplied by a learned per-bucket scalar to predict coast and decide when to brake; intermediate requested angles interpolate between their nearest stored buckets for prediction only
  - pauses for a deliberate one-second settle before final measurement and learning, and inserts a one-second pause between successive training turns so the operator can see each turn fully finish before the next begins
  - both large-angle and small-angle training now repeat each requested angle until the turn error is within target or the per-angle retry cap is reached
  - emergency stop support during turn execution
  - checks the global stop on live IMU updates, so motor-feedback loss resolves a non-moving turn promptly instead of re-arming the IMU watchdog indefinitely; nested turn execution never clears the operation-owned stop latch
  - large-angle and small-angle tuning runners for comprehensive parameter learning
  - integrates with retry system for obstruction recovery
- `src/control/turnValidationRunner.ts`: wrapper for real-pose turn validation sweeps
  - uses the live pose provider directly at the start and end of each turn
  - chooses a large turn target for each iteration, with turn magnitudes above 45 degrees
  - records IMU-achieved angle versus real pose change for tuning-page inspection
- `src/control/turnLearningModel.ts`: turn parameter learning and persistence
  - direction-specific learning (CCW vs CW asymmetry)
  - small-angle learning uses 3° rate-horizon buckets up to the configured small-angle threshold; each bucket supplies the milliseconds of live angular-rate projection used to predict coast, intermediate requested angles interpolate between neighboring buckets, and learning only writes back when the requested angle is effectively on a real bucket
  - default small-angle rate-horizon buckets are seeded from clean tuning results through 30° and conservatively extrapolated above 30°; loading a pre-calibration parameter file migrates only buckets with zero samples, preserving genuinely trained values
  - small-turn learning uses normalized achieved angle so tiny reverse movement cannot be mistaken for a near-360° overshoot
  - large-angle learning uses independent 10° angular-rate scalar buckets per direction above the small-angle threshold; each scalar multiplies the live angular rate to predict remaining coast, and intermediate requested angles interpolate between neighboring bucket scalars for prediction only while learning only writes back when the requested angle is effectively on a real bucket
  - JSON persistence at `config/turn-learning-parameters.json`
- `src/control/turnControllerTypes.ts`: turn controller type definitions
- `src/server/turnTuningPage.ts`: modern responsive web UI for turn tuning
  - real-time turn execution and monitoring
  - shared angle field used for single-turn execution and as the starting bucket/angle for small-angle and large-angle training sweeps
  - results table with error visualization and without the misleading legacy brake-distance display
  - each turn result row now shows the active control mode, learned bucket, and the actual brake trigger used (timeout for small turns, predicted brake angle for large turns)
  - real-pose validation sweep table comparing IMU and pose fusion headings
  - learning parameter display showing the actual persisted small-angle rate-horizon buckets, large-angle rate-scalar buckets, and learning-rate diagnostics used by the current controller
  - sticky IMU and GNSS live widgets in a left sidebar, cloned from the main dashboard
  - prominent STOP button for emergency abort
- `src/server/driveTuningPage.ts`: drive tuning UI with live primitive sidebar
  - short-distance drive training controls and results table
  - sticky IMU and GNSS live widgets in a left sidebar, cloned from the main dashboard
- `src/control/segmentTestRunner.ts`: segment test harness
  - collects a rough line of 7 waypoints by briefly driving forward, stopping, settling, and then sampling the next live pose
  - runs one return-to-start segment and then random non-nearest waypoint segments using the existing segment controller
  - records distance to waypoint, required heading change, achieved heading change, drive quality, average CTE, maximum CTE, and X/Y errors
- `src/server/segmentTestingPage.ts`: segment testing UI
  - sticky IMU and GNSS live widgets in a left sidebar, cloned from the main dashboard
  - start/stop controls on the right
  - live results table for the collected segment runs, including required heading, achieved heading, signed heading difference, average CTE, and maximum CTE; CTE and X/Y arrival errors are displayed in centimetres while source telemetry remains in metres
- `test/turnController.test.js`: turn controller unit tests
- `test/turnValidationRunner.test.js`: real-pose validation wrapper tests
- API endpoints:
  - `GET /turn-tuning` - turn tuning web page
  - `GET /api/turn/status` - controller state and history
    - also returns persisted turn-learning parameters and learning diagnostics for the turn-tuning page
  - `POST /api/turn/execute` - execute single turn
  - `POST /api/turn/train-large` - run large-angle training sequence
  - `POST /api/turn/train-small` - run small-angle training sequence
  - `POST /api/turn/train-real-pose` - run real-pose validation sweep
  - `POST /api/turn/stop` - emergency stop current turn
  - `POST /api/turn/clear-history` - clear turn history
  - `POST /api/turn/reset-learning` - reset parameters to defaults

## One-off Peg Layout
- `scripts/run-peg-layout.mjs`: read-only-by-default command-line runner for the Rear Lawn peg-marking operation. It loads production-shaped lawn and obstacle geometry, prints the actual equal-area bands, checks the live service and trusted GNSS pose, routes every leg through the production mowing transit planner, calls the ordinary segment-drive API, pauses only at peg endpoints, and requests the global stop on failure or interruption.
- `scripts/peg-layout-geometry.mjs`: pure rotated-axis polygon geometry for equal usable-area bands, actual cross-lawn spans, configured endpoint standoff, and the alternating upper-left to upper-right peg order.
- `test/pegLayoutGeometry.test.js`: fixed-width, obstacle-area, and serpentine-order coverage for the one-off geometry.
- `docs/peg-layout-utility.md`: operator preview, execution, stop, and interpretation guidance.

## Drive Controller
- `src/control/driveController.ts`: segment drive controller that turns to face the target, recomputes bearing from the settled post-turn pose, performs a bounded corrective IMU turn only when the projected residual would exceed the requested CTE envelope, and then delegates straight-line travel
  - segment orchestration only; no straight-line CTE, brake, or arrival learning logic
  - accepts an optional operation-owned translation-path validator and invokes it after every settled alignment turn and immediately before line-drive handoff; a rejected live pose ends the manoeuvre before any corrective turn or translation
  - accepts an optional authoritative CTE-reference start; target bearing always comes from the settled live pose while the line controller keeps CTE on the planned entry-to-exit baseline
  - automatic turn-to-face-target before driving
  - requires every initial or corrective `TurnController` result to be successful; an errored or stopped turn cannot fall through into translation
  - short and long point-to-point segments use the same turn-then-straight rule; only an explicit caller request may skip the initial pivot
  - callers may supply a minimum useful translation; mowing uses 15 cm and checks it before spending power on an initial pivot as well as after any necessary pivot, while training leaves the option unset
  - delegates to line controller immediately after the turn, then records successful segment history
  - `getCurrentPose()` exposes the live fused pose for higher-level path executors that need to re-evaluate progress between segment drives
  - stop requests are unconditional: they are awaited through both the turn phase and the line-drive phase when active, and still issue an immediate stop command even when no drive is currently active
  - surfaces short-distance and segment training progress to the drive tuning page state while a training run is active
  - segment-learning runner for 105cm to 6m fixed-line runs in 20cm steps
  - integrates with retry system for obstruction recovery
- `src/control/driveLineController.ts`: straight-line drive controller with proportional-plus-CTE-rate cross-track trim, bounded live terrain compensation, and brake distance learning
  - executes straight-line drives from current position to target position
  - holds full forward (or full reverse) wheel power and combines proportional CTE, CTE-rate damping, heading and bounded terrain trim inside the existing steering ceiling; both wheels remain in the selected travel direction for the whole translation, and a gross heading loss stops the line rather than escalating into an in-place pivot
  - keeps CTE/heading/progress geometry on an optional immutable planned baseline even when the live translation start is displaced
  - derives transient terrain trim only from corroborated current imbalance and encoder response per applied PWM; it slews, decays, resets per drive and fails neutral on unsafe evidence
  - reverse travel uses the same geometric controller with the correct body-heading reference
  - hard arrival stop plus separate forward/reverse full-speed brake distance learning for longer sample drives
  - per-run RunRecord instrumentation: anchor / brake-trigger / settled pose snapshots, 2 Hz steering/current heartbeat, peak encoder tick-rate, signed-CTE convergence/crossing metrics, and obstruction/slip/GNSS-demoted events surfaced to the learner; emits `drive.line.run_record` and writes `<MOWER_LOG_DIR>/run-records/<date>.jsonl`
  - encoder calibration is NOT updated opportunistically from line drives; calibration is owned by the dead-reckoning workflow
  - short-drive stop-trigger learning uses exact buckets at 5, 10, 15, 20, 25, 30, 35, 40, 45, 50, 55, 60, 70, 80, 90, and 100cm
  - straight-line training runs those short buckets plus longer sample drives at 2m, 3m, and 4m, with the short/long distinction taken from the intended training distance rather than raw floating-point geometry
  - explicit training requests beyond the canned bucket list are preserved as custom distances instead of silently falling back to the full default training sweep
  - short-drive legs resample the current pose and heading before each forward/reverse leg, so targets are built from the mower's live heading rather than a stale pair anchor
  - short-drive legs pause briefly before motion, clear stale stop latches at the start of a new run, and stop early if cross-track error grows beyond the requested run distance
  - the initial wheel command is awaited before the pose listener is attached, preventing current-sensor calibration latency from allowing a short leg to brake and complete before its start command reaches the motor ESP
  - self-contained stop handling and learning updates for the line-following phase
- `src/control/runRecord.ts`: per-line-drive RunRecord schema and JSONL writer (Phase-1 instrumentation)
  - one record per drive: anchor / brake-trigger / settled poses, coast distance measured, peak encoder tick-rate, events seen during run, heartbeat samples
  - written to `<MOWER_LOG_DIR>/run-records/<YYYY-MM-DD>.jsonl`; best-effort, never throws into the controller
  - emitted alongside the existing `drive.line.run_record` log event by `DriveLineController`
- `test/runRecord.test.js`: unit tests for the JSONL writer (date routing, append ordering, basic schema fidelity)
- `src/control/driveSteeringMetrics.ts`: pure distance-domain CTE convergence analysis, including hysteretic baseline crossings, crossing-amplitude decay, CTE integral and distance to the target band
- `src/control/adaptiveTerrainSteering.ts`: bounded per-drive terrain-load compensator using corroborated motor-current and encoder-response asymmetry; stale or unsafe feedback clears its trim
- `src/control/driveLearningModel.ts`: drive parameter learning and persistence
  - long-drive brake distance learning from final X error with separate forward/reverse values
  - short-drive brake distances bucketed at the exact short distances from 10cm through 100cm; large overshoot corrections may exceed the leg length (bounded by the overall training-distance ceiling) and therefore request braking on the first post-start pose update; all longer plateau drives use the long forward/reverse brake distances
  - direction-specific proportional CTE gain and CTE-rate damping adaptation uses convergence and repeated-crossing metrics; one initial convergence crossing is not treated as oscillation
  - qualified mowing strips use a steering-only learning scope, so terrain-dependent line evidence cannot perturb the already-tuned braking or turning models
  - JSON persistence at `config/drive-learning-params.json`
- Drive sequence: settle → get pose → turn to target → turn-owned settle → recompute distance/bearing from the settled pose → optionally realign when the residual cannot fit the requested CTE envelope → delegate line drive with tapered short-drive heading/CTE correction and arrival braking → measure errors → update learning
- API: `driveToTarget(target)`, `reverseForDuration(ms)` for retry recovery
  - `POST /api/drive/train-short` - short-drive forward/reverse training sequence
  - `POST /api/drive/train-segment` - segment-drive forward/reverse training sequence

## Retry System (Obstruction Recovery)
- `src/retry/retryManager.ts`: **EVENT-DRIVEN RECOVERY SYSTEM** - handles obstruction detection and context-aware recovery
  - subscribes to `obstructionDetected` events from sensor controller via the appServer wiring
  - generic recovery fires for `high_current`; `stall` and `wheel_slip` otherwise stop and abort the active session
  - before generic dispatch, an active `MowingExecutor` may claim one low-current, fault-free translation non-progress stall while actually driving a mowing strip; after the drive settles it requires fresh GNSS, revalidates the live-pose-to-frozen-target line, clears only the matching sensor stall, and reissues the ordinary strip drive once
  - session tracking: max 3 recoverable-obstruction retry attempts per session before abort
  - implements `RecentTargetSink` so the segmented executor can record completed targets while a path follow runs; the path-context recovery walks that trail backward
  - context-aware recovery strategies:
    - **Line driving**: reverse 2 seconds (~half a metre at full speed), retry forward to original target
    - **Path following / boundary tracing**: stop the segmented executor, retrace the most recently completed targets in reverse (rear-first via `DriveController.driveSegment(target, -1)`) until measured reverse travel reaches the configured retreat distance, then call `pathRestart(waypoints)` which re-runs the same boundary follow. Every recovery leg must return a successful drive result; the fallback timed reverse must complete and show at least 10 cm of physical displacement before the perimeter can restart. A stall or wheel-slip event during recovery aborts the session.
    - **Turn on spot**: escape turn opposite direction 2 seconds, retry original heading from the new pose
  - emergency abort: powers off motors after max retries exceeded
- `src/retry/checkpointStore.ts`: checkpoint storage for recovery points
  - maintains circular buffer of last 10 checkpoints
  - context-specific checkpoint retrieval (line, path, turn)
  - automatic cleanup of old checkpoints
- `src/retry/retryTypes.ts`: type definitions for retry system
  - `ObstructionType`: high_current, wheel_slip, stall
  - `OperationContext`: line, path, turn
  - `Checkpoint`: recovery point with pose and context metadata
- `src/retry/operationContextTracker.ts`: in-process holder for the active `OperationContext`. Perimeter routes and the mowing run set "path" while running; the obstruction-event handler reads this to decide whether to dispatch to recovery and which flow to use. Returns `null` when nothing is active so unrelated obstruction events are ignored.
- Obstruction detection conditions (sensorController):
  - sustained motor current at or above 10A is independent stall evidence pending validation of the installed sensors
  - Wheel slip: encoder movement but position stationary — stops and aborts the active operation
  - Stall: no physical position progress while a motion command remains active; encoder-stationary evidence is used as a fallback when trusted position is unavailable. The narrowly bounded active-strip retry described above is the only low-current stall exception.
- `src/server/appServer.ts` wiring:
  - constructs `OperationContextTracker`, `CheckpointStore`, and `RetryManager` after the drive/turn controllers
  - injects a `turn(angleDeg)` adapter that calls `turnController.executeTurn({ targetAngle, direction })`
  - injects `pathRestart(waypoints)` that re-runs `executeSegmentedBoundaryPath` with the same recent-target sink
  - subscribes `sensorController.on("obstructionDetected", ...)` and routes the event to `retryManager.handleObstruction(...)` only when the operation-context tracker reports an active context
  - `runSegmentedPerimeterFollow` helper wraps each perimeter-follow route (path drive/verify, area-perimeter drive/verify) with operation-context set/clear + retry session start/end + path checkpoint registration
  - area-perimeter save/drive/verify now reuse the same inward-safe smoothing + continuous-follow approach used by obstacle tracing, except the safe offset is inward rather than outward
  - mowing run wires `recentTargetSink: retryManager` into `MowingExecutor` and brackets the background execution with the same retry-session lifecycle
  - releases the settled `MowingExecutor` reference after complete/stopped/error so `/api/mowing/status` can advertise the saved resume state; the Drive & Paths page continues polling until that terminal resume state is visible and presents a **Carry On Mowing** button
  - mowing start now seeds an initial path checkpoint with the area boundary itself, so a recoverable failure during the very first "join and trace the perimeter" phase can reverse and rejoin instead of aborting with `no_checkpoint`

## Path Following
- `src/pathfollowing/pathFollowerApi.ts`: **PATH FOLLOWING API** - shared types for recorded paths and path storage
  - `PathPoint`, `StoredPath`: shared geometry types
  - `StoredPath` may include optional `mowingDefaults` for area-specific strip heading and strip spacing
  - `IPathRecorder`: interface for recording paths during manual driving
  - `IPathStore`: interface for persistent path storage
- `src/pathfollowing/obstaclePathShaper.ts`: closed-loop path shaping for recorded perimeters
  - obstacle recordings are smoothed and offset outward so the mower follows just outside the mapped obstacle
  - mowing-area recordings are left raw on disk; the obstacle shaper now delegates area cleanup to the dedicated inward-constrained area cleaner below
- `src/pathfollowing/areaPerimeterPathCleaner.ts`: inward-constrained cleanup for recorded mowing-area perimeters
  - trims start/end overlap, resamples the loop, protects real corners, removes short double-backs, simplifies only when the replacement stays inside or touching the recorded polygon and within the configured 10cm deviation bound, and applies only light safe rounding to unprotected wiggles
- `src/pathfollowing/pathRecorder.ts`: save-time path post-processing
  - legacy save-processing flags remain for compatibility but recording now persists raw points so shaping policy can evolve without forcing a perimeter re-trace
- `src/pathfollowing/segmentedBoundaryExecutor.ts`: segmented perimeter-follow implementation for general stored paths and exact waypoint sequences
  - simplifies manually recorded wiggles using a chord tolerance plus a per-vertex turn-angle gate, so any kept vertex is one the mower will pivot through on the spot
  - subdivides long simplified spans into bounded segment-drive targets
  - re-anchors target execution to the nearest target at runtime and skips targets already under the current pose
  - verification flows can preserve the intentional first join-point target even when the mower is already sitting on it, preventing closed-loop verify from terminating immediately after the tangent turn
  - the passed-waypoint helper also supports a closed-loop start-target progression mode so a preserved join point can become passed once the mower has genuinely moved down the first segment, preventing obstacle verify from orbiting the join point
  - before every segment drive, advances completed waypoints strictly in order using a small pass margin; if the mower has already overshot a tiny segment, that waypoint is skipped only after it is truly passed
  - once the next required waypoint is known, it can still choose a short look-ahead target farther along the same ordered route to reduce needless micro-turns
  - stored obstacle path drive/verify disables that look-ahead and uses exact next-target tracing so the mower does not cut chords across the inside of the obstacle
  - stored obstacle path drive/verify also bypasses runtime simplification/resampling and follows the saved smoothed-safe points directly
  - completion is based on all ordered waypoints having been passed, not merely on exhausting a selected-target list
  - callers that already chose a specific join point can preserve that target order while still dropping any first target that is already within the minimum segment distance of the mower
  - drives targets with the calibrated segment drive controller and aborts when segment CTE exceeds the configured threshold
- `src/pathfollowing/continuousPathFollower.ts`: continuous forward follower for smooth perimeter traces and multi-point lane connectors
  - pre-analyses the complete ordered route and uses one stable conservative lookahead up to 1m; meaningful corners still cap the moving target so obstacle corners cannot be cut
  - supports ordered-progress protection so projection stays on the local segment window instead of jumping ahead to a later non-adjacent segment
  - supports sharp-corner waypoint pivots: when close to a waypoint that implies a steep outgoing turn, it pivots to the new heading instead of trying to arc-cut outside the perimeter
  - supports a caller-supplied minimum trace speed so perimeter loops do not slow into near-stall commands
  - keeps the faster forward wheel at the requested mowing output while allowing the inner wheel to slow below that output, including to zero; a low inner-wheel command alone never triggers a pivot
  - treats a lookahead target coincident with the current waypoint as incoming-segment guidance, avoiding a fictitious zero-vector outgoing heading
  - ordered projection searches a bounded 50cm forward route window so dense samples cannot leave progress pinned to a stale waypoint behind the mower
  - never turns accumulated lookahead curvature or ordinary heading error into a stop/pivot/segment fallback; continuous guidance has one output mode, a forward differential arc with either inner wheel permitted to reach zero
  - aligns once to the initial moving-lookahead direction through the standard `TurnController` before any forward output, covering connector, resume, return-to-start, recharge, and manual continuous-route entry without adding mid-route branching
  - confirms an ordinary route-corridor breach for twenty-five consecutive 50Hz samples before aborting, while retaining an immediate abort at twice the corridor; it never converts route deviation into recovery motion and clears the stateful wheel command on every exit path
  - obstacle encounters and displaced obstacle-boundary resumes up to 1.5m away use a safety-checked ordinary segment drive to a tangent-approach point, then the ordinary turn controller, before continuous following begins on genuine perimeter points; the live off-route pose is never inserted into the closed loop as a synthetic chord/corner
  - inter-strip connector resumes always retain the saved pending target and untouched connector remainder, locally route from the current fused pose to that target, validate and persist the replacement route, then continue without regenerating or reordering the mowing plan; this applies even while the pose remains inside the old route corridor, so an interrupted segment is never resumed from stale geometry
  - a connector corridor-deviation abort gets one equivalent live local replan to its unchanged destination; repeated deviation or unavailable/unsafe routing still fails closed
  - the execution-level local waypoint test is the sole owner of genuine 20° corner stops; `ContinuousPathFollower` brakes at the learned incoming-edge stop trigger, delegates only the outgoing in-place alignment to `TurnController`, and treats the advanced ordered target as authoritative so a completed corner cannot be selected again merely because projection remains closest to its incoming edge
  - perimeter traces and routed perimeter connectors keep the faster wheel at their requested speed while allowing the inner wheel to slow to zero; execution settings persist across mowing resume
  - applies a per-control-cycle wheel-command slew limit so curvature, heading, and CTE corrections change motor demand progressively instead of jumping between fast and slow outputs
  - drives saved or planned polylines using direct left/right wheel outputs instead of turn-drive-turn segments
  - mowing traces/connectors can enable strict ordered progress so nearby non-adjacent segments, including the closing leg back to the join point, cannot falsely jump the follower far ahead in the route
  - advances ordered path progress using the same passed-waypoint logic, then projects the mower onto the ordered polyline and picks lookahead by true forward arc-length progress instead of only waypoint index
  - continuously steers with the learned forward CTE and heading gains shared by straight driving
  - mowing execution sends every safe two-point connector through `DriveController` regardless of length, and may similarly simplify a safe multi-point connector up to 1m; direct simplification uses the same strict live-pose area/obstacle validator as translation, so a chord across an area concavity retains or locally rebuilds the routed connector
  - closed-loop obstacle verify enables the start-target progression mode so the follower can leave the preserved join point after tangential departure instead of repeatedly steering back into a tight local loop
  - adaptively reduces forward speed on tighter local path curvature, larger live heading error, and larger live cross-track error, while allowing broader smoother perimeters to run faster
  - can pivot in place only as a fallback for very large heading errors and now uses pivot-entry / pivot-exit hysteresis so it does not flap between arc-drive and pivot-turn modes
- `src/pathfollowing/pathStore.ts`: JSON-based persistent storage for recorded paths
  - file format: `{name}.path.json` by default, with configurable suffix for separate collections such as mowing area perimeters
  - in-memory caching for loaded paths invalidates every display-name/sanitized-name alias when a shared file is saved or deleted, preventing list-driven reloads from returning stale perimeter geometry
  - path metadata: total distance, point count, creation timestamp
  - mowing area entries may also persist optional strip-heading / strip-spacing defaults alongside the geometry
- `src/pathfollowing/pathRecorder.ts`: records paths during manual driving
  - records fused GNSS and dead-reckoning poses, ignores unknown-quality poses, and skips implausible segment jumps while keeping skip counts in the stop summary
  - always persists raw recorded points so future perimeter-shaping fixes can be applied at runtime without forcing an operator re-trace
- `src/pathfollowing/obstaclePathShaper.ts`: reshapes recorded obstacle loops into a convex, slightly outward-offset, Chaikin-smoothed loop and nudges any stray points back outside the originally recorded obstacle polygon
  - obstacle shaping remains separate from mowing-area cleanup so the obstacle-safe outward offset logic does not leak into area-perimeter handling
  - shaping behaviour is defined by clearly named local constants, including the obstacle outward offset, per-step outside nudge, and Chaikin pass count
- `src/pathfollowing/pathVerification.ts`: rotates a stored path so verification/drive starts at the nearest recorded point and (for closed perimeters) loops back to the join point
  - pose-joined closed perimeter routes use the live pose only for the initial approach leg; vertices skipped by the ahead join are rotated to the end of the route so every recorded perimeter edge is retained before closing at the first joined perimeter point
- `src/pathfollowing/mowingExecutor.ts`: projects a strip-derived preferred area-trace anchor onto the authoritative cleaned perimeter before inserting it, preventing small clipping/intersection residue from creating an exterior perimeter vertex
  - chooses forward or reverse traversal by tangent alignment at the nearest point
  - verification approach stages 10cm short of the join point so the mower has body clearance to pivot before joining the perimeter
  - obstacle verify now reuses the chosen direction but recomputes the nearest perimeter join from the post-turn pose before starting the follow loop
  - mowing area perimeters preserve the recorded geometry verbatim; obstacle paths may now be saved as a smoothed outward-safe loop for easier tracing and then followed by the continuous obstacle follower
  - path safety distances are supplied from `PathFollowingConfig` rather than hard-coded in this helper
- `src/pathfollowing/mowingPlanner.ts`: preview geometry for mowing-area strip plans
  - normalizes the requested mowing axis to 0-180 degrees because opposite directions produce the same strip layout
  - clips parallel strips to the selected mowing area perimeter using the requested strip spacing, defaulting to 30cm spacing for the 40cm blade
  - stages preview generation as plan prep, obstacle-band filtering, strip interval clipping, traversal sequencing, and connector generation so the heavy preview work stays modular
  - selects the nearest obstacle-clear line-of-sight area perimeter entry point for mow-start entry planning
  - outside-area starts may join directly from outside so long as the approach only meets the area boundary at the chosen join and does not cross an obstacle; the "midpoint must stay inside" guard applies only when already inside the area
  - shifts mow-start perimeter joins away from sharp perimeter corners so the first tangent turn and follow do not begin on a fragile corner/kink
  - inside-area starts also require the straight approach midpoint to remain inside the mowing area, helping reject joins that would cut out through a concavity
  - performs sweep-topology decomposition: interval appearances, disappearances, splits and merges caused by either the area boundary or obstacles create stable visitable regions, including concave outer-boundary pockets
  - globally optimises the small set of region templates as a closed cycle, validates its last-to-first connector, and rotates the fixed cycle to the region entry nearest the preferred live start while preserving boustrophedon order inside each region
  - filters the regional optimisation graph through the production safe-connector builder, preventing oblique mowing angles from selecting an infeasible transition and failing later during preview connector generation
  - caches each oriented region-to-region connector evaluation so exact optimisation does not repeatedly run expensive geometry validation for the same edge
  - safe connectors treat repeated ground as a cost rather than a prohibition: they evaluate direct travel, both boundary directions, all intersecting obstacles, both area-perimeter directions, then a free-space visibility-graph fallback before declaring genuinely disconnected geometry
  - treats the driven outer perimeter as an authoritative retrace route when polygon sampling is numerically ambiguous, and defers expensive routed-connector construction until after regional optimisation
  - explicitly connects transition endpoints into the sparse roadmap and preserves expanded obstacle-perimeter loops, allowing obstacle-to-area transitions without unsafe obstacle chords
  - preserves complete generated strips, including boundary-to-standoff sections, as retrace edges joining obstacle-side work to the common outer-perimeter network
  - rejects clipped strip fragments below the 15 cm minimum drive before sequencing and symmetrically caps standoffs on other short strips to retain a 15 cm commanded drive, preventing endpoint overshoot
  - `scripts/verify-mowing-plan-angles.mjs` verifies every integer heading from 0° through 179° against a stored area and all recorded obstacle paths; `npm run verify:mowing-angles` defaults to Rear Lawn at 38 cm and reports every failure
  - `test/manual/mowingPlannerAllAngles.test.js` exposes that exhaustive sweep to the mower MCP runner without adding it to the normal `test/*.test.js` suite
  - records stable strip IDs, region order, region entry/exit points, and an estimated combined-wheel-travel cost in the plan
  - builds connector previews from configured mowing standoff points and follows the same boundary when consecutive strip endpoints touch the same area or obstacle boundary
  - treats obstacle perimeters as holes, splits strips around them, and returns connector paths that route around an obstacle perimeter when a direct connector would cross it
  - exact regional optimisation is used for up to twelve regions; unexpectedly complex layouts use a deterministic bounded fallback
  - returns logical strip segments, region shading metadata, and the selected connector route for preview and execution
- `src/pathfollowing/experimentalAdaptiveAreaSmoothing.ts`: experimental adaptive low-pass area smoothing harness module
  - resamples the recorded area loop, applies curvature-weighted smoothing, and iteratively blends failing points back toward the original geometry until they are inside and within the allowed deviation
- `src/pathfollowing/areaPerimeterPathCleaner.ts`: production mowing-area perimeter cleanup now uses the adaptive smoother plus bounded-error reduction
  - repairs rough non-corner closure seams first by blending about 1 metre of the tail/head neighbourhood into a tangent-aligned join, so start/end recording noise does not survive as a splice kink
  - keeps adaptive smoothing within the configured 10cm raw-boundary deviation budget, then applies a tighter 5cm reduction bound when decimating the smoothed result
  - emits raw, smoothed, reduced, and chosen outlines so the preview UI can compare the recorded perimeter against the production outline
- `src/pathfollowing/mowingExecutor.ts`: mowing execution workflow
  - gates start/resume on both GNSS-quality fused position and a process-local accepted absolute GNSS heading baseline, and stops an active mow as `poor_gnss` after a 2-second sustained GNSS-position-quality loss
  - persists exact in-progress mowing step state through the app-server callback so failed or stopped sessions can resume from the saved operation rather than rebuilding the strip plan from scratch
  - when Carry On resumes an interrupted strip translation before its exit target, returns to that strip's planned entry standoff and mows the complete strip again before continuing the frozen sequence
  - supplies frozen area/obstacle validation to every in-area segment drive; a post-pivot control-point offset no more than 25cm inside one obstacle may execute only its saved, area-safe line when 5cm samples move monotonically out of that obstacle, avoid every other exclusion, and the settled forward heading immediately reduces penetration, while deeper, tangential, or non-outward obstacle starts remain stopped
  - permits a post-pivot outer-boundary offset only within the normal 25 cm escape envelope and only for a monotonically inward, obstacle-free recovery segment
  - gives every strip its planned entry standoff as an immutable CTE reference while leaving the initial bearing tied to the settled live pose, so a displaced start converges onto rather than redefines the frozen strip
  - records trusted actual strip traces; a cutter-width gap sustained for 20 cm triggers one resumable repair that mows the adjacent-strip bisector in the previous direction and then repeats the current strip
  - executes the planner-provided inter-strip connector without replacing its route; planner-approved two-point connectors use direct line drive, while multi-point perimeter connectors use conservative continuous following over the exact ordered geometry
  - when a continuous boundary or connector follow stops, saves the completed waypoint index and resumes from that ordered progress point rather than restarting the saved path at index zero
- `src/server/appServer.ts`: mowing start/resume HTTP handlers reject requests before creating an executor when fused position is not GNSS quality (`409 poor_gnss`) or the current pose-fusion process has not established an absolute GNSS heading baseline (`409 gnss_heading_not_synchronized`)
  - Carry On also rejects with `409 motor_feedback_unhealthy` until the sensor controller reports coherent, recent, fault-free motor feedback
- `src/pathfollowing/mowingCoverage.ts`: pure projection/interpolation logic for comparing perpendicular separation between actual adjacent-strip traces and constructing a repair line through the midpoints of their actual corresponding ends
- `src/config/learningPolicyConfig.ts` and `config/learning-policy.json`: shared persisted `training_only`/`mowing_and_training`/`always` policy enforced inside drive and turn controllers; production enables qualified mowing-strip steering plus explicit training
  - dedicated drive/segment and turn-validation/training runners label their controller requests as `training`; mowing strip translations use `mowing_strip`; turns and ordinary transit remain ordinary operations
- `src/control/driveLearningModel.ts`: persists direction-specific straight-drive learning; qualified mowing traces distinguish sustained drift from repeated baseline crossings and can continue strengthening proportional or damping response beyond the former saturated values, while the line controller retains the unchanged hard wheel-trim and translation-direction limits
- `src/pathfollowing/mowingResumeStore.ts`: JSON persistence for the saved mowing resume state
  - stores the exact active mowing operation, continuous-follow target index, traced-boundary progress, saved strip plan, and recorded area/obstacle geometry used by `/api/mowing/resume`
- `src/pathfollowing/mowingProgressStore.ts`: mower-owned JSONL mowing trail persistence
  - samples fused poses at 1 Hz while a mowing executor is active, queues asynchronous appends outside the pose callback, tolerates a partial final row, and preserves sequence numbering across **Carry On Mowing**
  - stores the current trail at `data/mowing-progress.jsonl`; a validated fresh mowing start truncates it, while resume appends to it
- `scripts/rebuild-mowing-progress-from-run-records.mjs`: operator/development recovery utility that rebuilds a representative mowing-progress JSONL file from timestamped drive RunRecord poses within a supplied mowing-session time range
  - serializes save and clear requests through one ordered promise queue, preventing rapid progress checkpoints from racing each other or an initial clear
  - uses the shared collision-proof atomic JSON writer; app-server persistence failures are logged as `mowing_resume.persist_failed` and do not terminate active motor control
  - on mow start, now tries to select a strip-adjacent area-perimeter anchor that is directly reachable without re-leaving the area after entry; when one is found it re-anchors the strip order to that perimeter point, drives to the associated inside standoff, traces the full area loop once, and then starts strip mowing from that same strip-adjacent point instead of re-planning again from the post-trace pose
  - that forced first area trace now injects the chosen strip-adjacent perimeter point into the traced loop itself and also refreshes the retry checkpoint with that ordered loop, so a stall during the first lap resumes on the same anchored perimeter order instead of falling back to a generic nearest-point boundary restart
  - initial area entry traces the full area perimeter before strip mowing begins; when no safe strip-adjacent area anchor can be chosen up front it falls back to re-anchoring strip order from the live post-trace pose
  - perimeter tracing for areas and obstacles uses conservative continuous following on straight/gentle runs, with explicit locked pivots only at genuine sharp corners or extreme heading errors
  - perimeter tracing now uses a less aggressive tight-arc pivot fallback threshold so, after a corner, it prefers to settle onto the new edge instead of repeatedly flapping between pivot and arc drive
  - mowing-area perimeter tracing now follows the recorded area boundary verbatim at runtime rather than passing it through the obstacle/area shaper, so corner logic sees the operator-drawn perimeter instead of a synthetic convex/smoothed substitute
  - after an explicit perimeter corner turn, continuous following resumes directly on the outgoing recorded edge; no synthetic capture segment is inserted
  - includes a 25 cm outside-area watchdog that stops the mow if the pose escapes beyond the saved area boundary
  - if the mower starts outside the area, adjusts the perimeter-entry approach target so the staging point lies inside the recorded area before tracing begins
  - skips the initial perimeter-entry drive when the live pose is already within the same small "close enough" tolerance of the staging point, preventing large corrective turns for a few centimetres of error
  - approaches the planned line-of-sight area perimeter standoff point before strip mowing
  - traces the area perimeter first and marks it traced before continuing into strips
  - rebuilds the strip order from the mower's actual post-trace pose so the first strip and its connector sequence are chosen from where the mower really ended up, not only from the pre-entry estimate
  - uses the planner-provided strip boundary references so first-encounter tracing is tied to the actual area/obstacle endpoint, not whichever recorded loop happens to be geometrically nearest
  - re-evaluates the nearest perimeter join after the tangent turn, then follows the resulting explicit closed loop without enabling closed-loop start progression in the live follower, preventing immediate perimeter-trace completion at the join point
  - ordinary strip-to-strip transfers now prefer a single direct drive from the live end-of-strip pose to the next strip entry target, so small X/Y arrival errors do not trigger long corrective dances around saved connector geometry
  - follows multi-point inter-lane connectors with the same continuous follower used for perimeter tracing so lane changes and obstacle-wrap connectors stay smooth instead of degenerating into repeated micro turn-drive retargets
  - only falls back to routed connector following when a direct transfer line is blocked by an obstacle
  - skips approach / strip / direct-connector micro-corrections when the live pose is already within 10 cm of the target, avoiding large turns for effectively completed 5 cm moves
  - accepts a settled strip-entry pivot inside the 25 cm point-reapproach usefulness threshold when its heading is already suitable, avoiding a short point-facing reapproach whose pivot displacement can consume the translation and force a redundant opposite turn
  - keeps two-point connectors as direct line drives between standoff targets
  - starts an in-run area watchdog after the initial perimeter trace and requests an immediate stop if the mower drifts more than 25 cm outside the mowing area
  - stops the mowing workflow if a boundary trace does not complete successfully
- `src/server/manualDrivePage.ts`: combined Drive & Paths UI asset loader
  - serves the HTML shell from `src/server/manual-drive-page/page.html`
  - injects shared dialog markup/script/styles and the sensor-widget bundle into the external page assets
  - exposes the page-specific `/manual-drive.css` and `/manual-drive.js` assets through the server routes
  - live position map at the top of the page
  - manual-drive telemetry cards
  - path recording controls for named obstacle paths
  - mowing area perimeter recording controls and stored perimeter management
  - mowing strip preview controls for selecting an area, setting strip width, and setting the strip angle with either a slider or a canvas drag gesture
  - the first mowing-plan field edit protects those controls from recurring area-list refreshes; a successful Preview/Mow commits the values, while the adjacent Cancel changes button restores the prior plan controls and resumes refreshes
  - persists the operator's strip-width selection in browser storage so refreshes do not reset it to 30 cm or overwrite it with an older area-capture default
  - drive and verify actions for stored paths (single segmented drive mode — no per-path algorithm choice)
  - canvas map auto-scales across live position history, obstacle paths, and mowing area perimeters, with a minimum view range and stationary jitter coalescing so centimetre-scale GNSS drift does not dominate the display
  - loads the mower-owned mowing progress trail once during page startup, retains a browser copy as a fallback, and then adds live polled poses; large pose jumps create a visual discontinuity instead of erasing prior progress
  - canvas map overlays generated mowing strips and obstacle-aware connectors for the selected area
  - stored path and area-perimeter detail loads are skipped individually if invalid so one bad/missing file does not suppress all overlays
  - prominent stop button for path following aborts
- `src/server/pathTracingPage.ts`: route wrapper that serves the combined Drive & Paths page
- Path tracing server behavior:
  - drive immediately follows the stored path from the current position via the segmented executor
  - verify first executes a segment-style approach to about 10cm short of the nearest point on the stored path
  - verify then follows the rotated loop back to the join point via the segmented executor
  - drive and verify route handlers always claim their API paths; when runtime controllers are not initialized they return a 503 JSON error with a `missing` dependency list rather than falling through to `not_found`
  - mowing area perimeter drive now uses a simpler merge: choose the perimeter direction closest to the mower heading, perform one alignment turn, then inject the live mower pose as the first follow point and begin continuous follow from roughly 50 cm ahead along that chosen perimeter direction so the join does not degenerate into a chain of tiny virtual turn-drive targets
  - mowing area perimeter verify segment-drives to the nearest perimeter point, turns to align with the chosen path direction, then follows the perimeter
  - mowing plan preview clips parallel strip lines to the selected mowing area perimeter, excludes stored obstacle perimeters, and returns the strips/connectors without starting motion
  - startup does not seed review fixture paths; mowing previews use only operator-recorded area perimeters and obstacle paths
- Path-following API endpoints:
  - `GET /api/path/list` - list stored paths for the page
  - `POST /api/path/record/start` - start recording a named path
  - `POST /api/path/record/stop` - stop recording and save the path
  - `POST /api/path/record/cancel` - discard the current recording
  - `GET /api/path/record/status` - current recording point count
  - `POST /api/path/drive` - drive a stored path from the current position
  - `POST /api/path/verify` - join a stored path at the nearest point and loop back to that join point
  - `POST /api/path/stop` - stop active path following
  - `POST /api/path/delete` - delete a stored path
  - `GET /api/area-perimeters` - list stored mowing area perimeters
  - `GET /api/area-perimeters/{name}` - load a mowing area perimeter with points
  - `POST /api/area-perimeter/record/start` - start recording a named mowing area perimeter
  - `POST /api/area-perimeter/record/stop` - stop recording and save the mowing area perimeter
  - `POST /api/area-perimeter/record/cancel` - discard the current mowing area perimeter recording
  - `GET /api/area-perimeter/record/status` - current mowing area perimeter recording point count
  - `POST /api/area-perimeter/drive` - follow a stored mowing area perimeter from the nearest point and current-facing direction
  - `POST /api/area-perimeter/verify` - drive to the nearest mowing area perimeter point, align, and follow it
- `POST /api/area-perimeter/delete` - delete a stored mowing area perimeter
- `POST /api/area-perimeter/update` - validate and atomically replace the points of an existing mowing area perimeter while retaining its saved mowing defaults
  - `POST /api/mowing-plan/preview` - generate a strip preview for a selected mowing area perimeter, heading, and strip spacing
    - emits `mowing.preview_timing` with timing breakdowns for area load, area shaping, obstacle shaping, and plan generation
    - returns raw, smoothed, and reduced area outlines plus area-geometry timings and per-stage mowing-plan timings for the preview canvas
  - subscribes to `poseUpdate` events from pose fusion
  - records position every 10cm (configurable distance threshold)
  - start/stop recording with named paths
  - automatic point filtering based on movement threshold
- `src/geometry/positionTypes.ts`: geometry functions for path following
  - cross-track error calculation for line/arc following
  - point-to-line distance calculations
  - along-track progress measurement
  - body-frame position translation from raw GNSS reference points to the mower control point
  - circle-fit helper use cases in geometry calibration utilities

## Sensors and Hardware
- `src/imu/bmi160ImuSensor.ts`: BMI160 gyro and accelerometer access over I2C.
  - gyro: 3-axis angular velocity for heading integration
  - accelerometer: 3-axis (X, Y, Z) for pitch and roll calculation
  - bias calibration on startup across all three gyro axes for drift compensation
  - pitch/roll zeroing to establish level reference on uneven ground
- `src/imu/bmi160Registers.ts`: BMI160 register/command constants.
- `src/imu/types.ts`: IMU sample and sensor contracts.
- `src/gnss/gnssProtocol.ts`: GNSS sample contract used by runtime.
- `src/gnss/gnssCodec.ts`: GNSS sample payload decoding for the compact 40-byte GNSS frame.
- `src/gnss/gnssDebugCodec.ts`: low-satellite raw-text debug payload decoding for the diagnostic I2C frame.
- `src/gnss/gnssNodeClient.ts`: GNSS request/response polling client over I2C framed protocol, plus low-satellite raw-text debug fetches.
- `external-hardware/esp32/gnss-mower/gnss-mower.ino`: rover GNSS firmware; relays verified RTCM to the UM982, uses decoded RTCM 1006 base-position messages as the stable local origin, reports no usable position until that origin is available, converts rover lat/lon to local X/Y, serves immutable framed snapshots over I2C, exposes boot/reset/origin diagnostics, and retains the latest low-satellite raw `PVTSLNA` payload for Pi-side logging.
- `src/motors/motorProtocol.ts`: motor command/feedback contracts.
- `src/motors/motorCodec.ts`: wheel-speed command encoding and motor-feedback payload decoding.
- `src/motors/motorMapping.ts`: app-facing forward-positive wheel convention mapping to/from raw motor node direction signs.
- `src/motors/motorNodeClient.ts`: motor command send + feedback polling over framed I2C protocol.
  - includes motor current sensing data in feedback samples
  - owns the ESP32 command heartbeat through one resettable timer: changed commands replace the latest value and restart the timer, callbacks resend only the current command including neutral and disabled states, and hardware-gateway shutdown explicitly cancels refresh
  - active, neutral, disabled and heartbeat wheel frames share the single `motor.command` replacement key; neutral/disabled frames use stop priority so an older queued motion target can never execute after a newer stop
- `src/controller/hidGameController.ts`: HID game controller input adapter and button event source.
- `external-hardware/manual-tests/controller_inspector.js`: HID controller bring-up inspector; prints connection state, decoded axes/buttons, and raw packet data without depending on the legacy full-system parameter file.
- `src/control/manualDriveProfile.ts`: manual drive demand shaping (deadband/arc/spin response).
- `src/control/manualDriveCoordinator.ts`: manual-drive loop; maps controller input to motor commands.
  - arm/disarm mapping: `right-top` arms, `left-top` disarms and stops.
  - coalesces tiny held-stick command jitter and only sends a motor command when the requested wheel pair actually changes.
  - uses a faster 20ms operator loop and manual-specific 120ms ramp-up/ramp-down overrides while still sending commands through the normal motor node path.
  - safety behavior: controller disconnect while armed triggers disarm + stop.
- `src/protocols/commonProtocol.ts`: shared node/message identifiers and frame header shape.
- `src/protocols/codecPrimitives.ts`: optional scalar codec helpers for protocol payloads.
- `src/bus/frameCodec.ts`: frame encode/decode and CRC validation.
- `src/bus/crc.ts`: CRC16-CCITT implementation.
- `src/sensing/sensorController.ts`: single 100Hz sensor polling controller and latest sensor state integration.
  - heading API: `getHeading()` returns `InternalHeading`; `setHeading(InternalHeading, timestampMillis?)` for timestamp-aware absolute heading reset integration.
  - heading convention: uses `InternalHeading` type internally; GNSS field headings converted via `fieldToInternal()`.
  - IMU yaw integration: projects the 3-axis gyro vector onto the gravity axis derived from pitch and roll, then uses `addRelativeAngle()` with `RelativeAngle` deltas from that tilt-compensated yaw rate and applies the persisted IMU yaw scale factor before updating the heading.
  - buffered IMU diagnostics: retains a short in-memory window of recent gyro integrations, snapshots that window when motor motion stops, and can expose a compact summary for turn debugging without per-sample file writes.
  - heading rebase readiness: exposes whether GNSS heading may safely rebase the IMU; rebasing is blocked while a motor command is active or the latest tilt-compensated yaw rate exceeds 1 deg/s.
  - GNSS geometry correction: buffers recent IMU headings and applies the configured body-frame offset to raw GNSS reference coordinates using a wrap-safe interpolation at the fix's effective timestamp (arrival minus receiver sample age), avoiding arrival-time heading artefacts during pivots; diagnostic events retain both raw and corrected inputs.
  - GNSS fault isolation: backs repeated transport/decode failures off exponentially to a one-second maximum interval, logs the first/reason-changed failure and recovery, and identifies GNSS-node restarts from the firmware boot ID without slowing motor or IMU polling.
  - IMU pitch/roll: calculated from accelerometer using atan2 formulas
  - motor command deadband: sub-10% wheel outputs are treated as zero before hardware transmission and zero-timestamp tracking.
  - minimum active motor command: non-zero wheel outputs are raised to at least 30%, and one-wheel motion commands are converted before reaching hardware.
  - motor API: `setMotorWheelOutputs(...)` publishes the requested state before awaiting I2C and sends the desired wheel pair through the normal queue, so an older async send cannot restore stale non-zero state after a stop; `stopMotors()` issues a ramped zero-output stop with the drive still enabled so the ESP32 honours the configured deceleration profile, and `emergencyStopMotors()` issues a hard H-bridge disable for the operator stop button / stall detection / watchdog only
  - **obstruction detection**: emits `obstructionDetected` events for high motor current, wheel slip, and stall conditions; requests global stop when stall is detected after the startup grace period and a generous motion-observation window shows no meaningful progress; pivot-to-translation and translation-to-pivot command changes restart that observation window
- `src/sensing/sensorEvents.ts`: type-safe event definitions for sensor controller.
  - `ImuHeadingUpdateEvent`: heading, pitch, roll from IMU
  - `GnssPositionUpdateEvent`: position, heading, fix quality from GNSS
  - `MotorFeedbackUpdateEvent`: wheel speeds, encoder deltas, PWM, current, watchdog/fault state
  - `ObstructionDetectedEvent`: obstruction type, motor currents, wheel speeds, active motion kind, sustained-current evidence and raw controller fault flags
- `src/sensing/sensorHardwareGateway.ts`: hardware adapter boundary between application sensor controller and physical sensor drivers, including the optional low-satellite GNSS debug-line fetch used for Pi-side raw-text logging.
  - direct gateway construction resolves omitted GNSS and motor addresses through `src/constants.ts`, matching the production server entry point
- `src/i2c/types.ts`: I2C transport and queued request types.
- `src/i2c/priorities.ts`: queue priorities for stop/motor/GNSS/IMU operations.
- `src/i2c/i2cBusController.ts`: single-bus queued priority controller with key-based request replacement.
- `src/i2c/liveI2cTransport.ts`: live Raspberry Pi I2C transport (`i2c-bus` module wrapper).
  - retries address-level failures (`EIO`, `EREMOTEIO`, `ENXIO`, or short transfers) once on the same handle so one restarting client does not disrupt the other nodes; only controller-wide `EBUSY`/timeout faults reopen the shared bus before retry
- `external-hardware/manual-tests/*.js`: Pi-side hardware utilities use the built defaults from `dist/constants.js` and retain the same `MOWER_I2C_BUS_NUMBER`, `MOWER_GNSS_I2C_ADDRESS`, and `MOWER_MOTOR_I2C_ADDRESS` overrides as production where applicable.
- `external-hardware/manual-tests/imu_manual_test.js`: manual BMI160 bring-up poller script; uses built runtime modules from `dist/i2c/*` and `dist/imu/*` after `npm run build`.
- `external-hardware/manual-tests/imu_gnss_turn_calibration.js`: interactive IMU/GNSS heading capture utility; press `S` to start a run and locally align the IMU to the current GNSS heading, then press `E` to save paired start/end headings, a suggested yaw-scale correction to JSONL, and the averaged export to `config/imu-yaw-calibration.json`.
- `external-hardware/manual-tests/rotation_center_calibration.js`: manual GNSS geometry calibration utility that spins the mower through at least one full rotation and writes `config/geometry-calibration.json`.
- `test/i2cBusController.test.js`: queue priority and replacement behavior tests.
- `test/liveI2cTransport.test.js`: verifies same-handle retry for client faults and reopen/retry for controller-wide faults.
- `test/bmi160ImuSensor.test.js`: BMI160 initialise/calibration/read conversion tests.
- `test/sensorController.test.js`: sensor controller loop and state integration tests.
- `test/motorNodeClient.test.js`: motor command priority, duplicate suppression, active/neutral/disabled latest-command heartbeat, queued motion-to-neutral replacement, shutdown cancellation, and feedback-frame decode tests.
- `test/motorMapping.test.js`: motor direction sign mapping tests.
- `test/manualDriveProfile.test.js`: manual-drive demand shaping tests.

## Pose Estimation and Sensor Fusion
- `src/sensing/poseFusion.ts`: **POSE ESTIMATION IS HERE** - combines GNSS, IMU, and encoder feedback for best-estimate pose.
  - maintains current position (X, Y meters) and heading (InternalHeading)
  - quality tracking: "gnss" (RTK fixed/float), "dead-reckoning", or "unknown"
  - GNSS position updates: accepts high-quality GNSS fixes (RTK fixed/float with <0.1m accuracy)
  - GNSS heading fusion: updates from a currently valid stable GNSS dual-antenna heading when available, already close to the current IMU heading, and safe to rebase; while stationary and safe to rebase, five consecutive samples that pass all GNSS heading checks except IMU agreement rebase the IMU regardless of disagreement angle; GNSS heading write-back is deferred while the sensor controller reports active motor motion or active yaw, and latched trust never admits a rejected current epoch.
  - turn-heading ownership: active turns use IMU yaw exclusively; GNSS rebasing waits until after motor and yaw settling, while encoder-implied turn and IMU/encoder disagreement remain dashboard/log diagnostics with no navigation authority
  - exposes a primitive snapshot flag indicating whether the IMU has been synchronised to an accepted absolute GNSS heading during the current process, so the web UI does not confuse one unconsumed epoch with loss of the established baseline
  - logs heading-only GNSS rejection reasons, including the validity flag and reported antenna baseline, even while GNSS position remains trusted
  - turn diagnostics: logs the motor-stop IMU summary when GNSS heading rebases after a stop or consistent offset, so turn evidence can be reviewed without 200Hz disk writes
  - IMU heading integration: continuously integrates IMU yaw for heading during GNSS gaps
  - encoder dead-reckoning: integrates motor encoder deltas for position during GNSS gaps
  - heading reset API: `setHeading()` for external absolute heading corrections
  - pose API: `getCurrentPose()` returns current position, heading, and quality
  - encoder calibration is persisted via `src/config/poseCalibration.ts`
  - emits bounded-rate `poseUpdate` events for downstream control consumers, while trusted GNSS corrections can still force an immediate emission
- `src/geometry/positionTypes.ts`: branded types for position and pose.
  - `Meters`: branded number for type-safe distance values
  - `Position`: X/Y position in meters
  - `Pose`: position + heading + quality indicator
  - geometry functions: `distanceBetween()`, `angleTo()`, `crossTrackError()`, `calculateXError()`
  - vehicle geometry helpers: body-frame offset translation and projection for GNSS control-point calibration

## Operation And Server Entry
- `src/server/main.ts`: production entrypoint (compiled to `dist/server/main.js`).
  - directly starts the single app/control HTTP server by delegating to `src/server/controlMain.ts`, so the operator pages and `/api/*` share one process and one port
- `src/server/controlMain.ts`: hardware-facing runtime entrypoint (compiled to `dist/server/controlMain.js`).
  - defaults to the single production app port (`8090`) when no explicit port env var is provided
- `src/server/webServer.ts`: optional proxy-style web server that serves operator pages and proxies `/api/*`, `/health`, and other non-page requests to a separate control process; kept for non-production use only.
- `src/server/appServer.ts`: app/control HTTP server bootstrapping, routing, and graceful shutdown.
  - owns both the operator pages and the hardware-facing API routes in the production runtime
  - serves shared browser assets including `/sensor-widgets.js` and `/operator-page-common.js`
  - owns the mowing executor lifecycle (`MowingExecutor`) and dead-reckoning calibrator lifecycle
  - API endpoints: `GET /dead-reckoning`, `POST /api/dead-reckoning/start`, `POST /api/dead-reckoning/stop`, `POST /api/dead-reckoning/apply`
  - API endpoint: `POST /api/mowing/start`, `POST /api/mowing/stop`, `GET /api/mowing/status`, `GET /api/mowing/progress`
- `src/server/homePage.ts`: expanded dashboard served at `/dashboard`, including navigation to Drive & Paths and a low-satellite warning banner when raw GNSS counts drop below the trusted threshold.
- `src/server/deadReckoningPage.ts`: focused three-phase dead-reckoning calibration page (GNSS-measured straight, long forward CW arc, long forward CCW arc); presents raw encoder totals, independently derived wheel scales, each arc's converted wheel distances and effective track width, followed by explicit apply controls.
- `src/server/driveTuningPage.ts`: simplified drive tuning page with a start-distance input, a single short-distance training action, and a compact results table that polls live status without browser caching; result distances are signed, with reverse-learning legs displayed as negative values, and Status is derived from both execution completion and the configured X/Y acceptance requirements.
- `src/server/sensorWidgets.js`: **WEB COMPONENT DEFINITIONS** — pure static JS served at `GET /sensor-widgets.js` (cached 1 hour).
  - `<imu-sensor-widget>`: custom element with shadow DOM; attributes: `status`, `error`, `heading-deg`, `pitch-deg`, `roll-deg`, `synced`
  - `<gnss-position-widget>`: custom element with shadow DOM; attributes: `status`, `error`, `heading-deg`, `heading-accuracy-deg`, `x-meters`, `y-meters`, `position-accuracy-meters`, `fix-type`, `satellites`, `synced`
  - Both components own all their CSS inside shadow DOM — page styles cannot reach in, so appearance is identical on every page by construction
  - CSS custom properties (`--primary-color`, `--bg-primary`, etc.) pierce the shadow boundary so the shared colour palette still applies
  - `synced="true"` attribute triggers a green border highlight; `synced="false"` triggers an amber border highlight via `:host([synced="..."])` CSS selectors
  - Pages update widgets via `element.setAttribute('heading-deg', value)` — no element ID bookkeeping needed
- `src/server/liveSensorWidgets.ts`: **WIDGET MODULE BRIDGE** — thin TypeScript module that serves the web component bundle and provides page helpers.
  - `SENSOR_WIDGETS_JS`: `Buffer` of `sensorWidgets.js` read once at startup; served by appServer at `/sensor-widgets.js`
  - `getSensorWidgetScriptTag()`: returns `<script src="/sensor-widgets.js" defer></script>` for page `<head>`
  - `getSensorWidgetLayoutStyles()`: returns minimal layout CSS (flex/grid placement of the custom elements); contains no typography or colour rules so it cannot override component shadow CSS
  - used by: deadReckoningPage, driveTuningPage, homePage, segmentTestingPage, turnTuningPage
- `src/server/operatorPageCommon.ts`: shared browser utility bundle for operator pages; served at `/operator-page-common.js`.
  - centralises `window.operatorPage.fetchJson(...)`, `postJson(...)`, and `stopAll()` so operator pages share one fetch/error-handling contract
- `src/server/primitivesStore.ts`: in-memory primitives state holder for the live web widgets.
  - primitives payload shape contains `imu`, `gnss`, `poseFusion`, and `motors` sections.
  - `poseFusion.usingGnssHeading` is the app-level flag consumed by the live widgets to show whether the IMU has an accepted absolute GNSS heading baseline in the current process.
  - all four sections (`imu`, `gnss`, `poseFusion`, `motors`) are guaranteed non-null objects — initialised with defaults at construction and deep-merged on update.
- `docs/sensors.md`: sensor boundary/API contract, heading convention, GNSS frame/payload documentation, and primitive field purpose.
- `scripts/mower-launch.sh`: launcher used by both `npm run start` and systemd; pins `MOWER_LOG_DIR` to the repo `logs/` folder by default.
- `systemd/mower.service.template`: systemd unit template for runtime process management; explicitly sets `MOWER_LOG_DIR` to the repo `logs/` folder.
- `systemd/install-mower-service.sh`: installer for `/etc/systemd/system/mower.service`.
- `test/server.test.js`: server unit/integration tests.

## Dead-Reckoning Calibration
- `src/control/deadReckoningCalibrator.ts`: three-phase dead-reckoning calibration procedure
  - Phase 1 (straight line, default 10 m): line-drives forward and independently derives left/right `metersPerTick` from the settled GNSS chord and each wheel's encoder total
  - Phase 2 (arc CW, default 180 degrees): drives a constant-speed forward clockwise arc until the IMU reaches the requested sweep and derives effective moving-turn track width from the calibrated left/right travelled-distance difference divided by IMU heading change
  - Phase 3 (arc CCW): mirror of phase 2
  - arc endpoint disagreement and encoder/IMU progression remain diagnostic data and do not reject calibration or claim wheel slip; CW/CCW track-width spread above 20% is reported for operator review
  - outputs the straight-derived per-wheel scales and mean CW/CCW effective track width for operator review before applying
  - completed status retains phase anchors, counts and calculated values but removes the high-rate telemetry arrays before exposing the result to the one-second web poll
  - settle diagnostics: logs `dead_reckoning.pose_not_settled` with the live blocker reason plus pose-fusion diagnostics whenever the 2-second settle dwell is interrupted, logs `dead_reckoning.pose_settled_anchor_rejected` when the pose is settled but the raw GNSS anchor is unusable, and logs the final fused/gnss snapshot on timeout
  - integrates with `systemStop` for safe abort during any phase
  - API: `run()`, `requestStop()`, `getState()`
- `src/server/deadReckoningPage.ts`: dead-reckoning calibration web UI (see Operation And Server Entry above)
  - defaults to a 10 m straight and 180-degree arcs, accepts 90–180-degree arc sweeps, and retains the completed result after motion stops

## Project Build And Test Tooling
- `package.json`:
  - `build`: TypeScript compile (`node ./node_modules/typescript/bin/tsc -p tsconfig.json`)
  - `test`: runs full unit test suite (`node --test test`)
  - `start`: runs production launcher (`./scripts/mower-launch.sh`)
  - `lint`: runs static validation via TypeScript (`npm run typecheck`)
  - `typecheck`: strict type validation (`node ./node_modules/typescript/bin/tsc --noEmit -p tsconfig.json`)
- `tsconfig.json`: TypeScript compiler and project type-check settings.
- `src/index.ts`: main module exports including heading type system for external consumers.
- `test/index.test.js`: basic runtime module tests including heading normalization.
- `scripts/run-area-smoothing-harness.mjs`: local/manual harness that loads an area perimeter, runs the experimental adaptive smoother, prints stats, and writes an SVG overlay for visual inspection.

## Remote Tooling — On-Mower MCP Server
- `docs/mcp-server.md`: usage guide and operator/workstation setup for Codex and Claude Code. **Required reading** when remote on-mower verification is needed.
- `tools/mcp-server/server.js`: HTTP MCP server that runs on the mower. Exposes workstation-agent tools for remote verification and diagnosis: `getLatestLogs(...)` with optional regex filtering, `readFile(...)` for bounded remote file inspection, `build`, `test` (including narrowed test-file / test-name runs and optional saved output), and `sync` (`git fetch --all --prune` + `git pull --ff-only`). Bearer-token auth, stateless streamable-HTTP transport, per-request server/transport pair.
- `tools/mcp-server/package.json`: isolated dependency manifest for the server (`@modelcontextprotocol/sdk`, `zod`); kept separate from runtime dependencies so the mower app's `node_modules` is not affected.
- `systemd/mower-mcp.service.template`: systemd unit template; reads `MOWER_MCP_TOKEN` from `/etc/mower-mcp.env` and runs the server as the `mower` user on port 8765 by default.
