davidgoddard/mower2026/docs/sensors.md

# Sensors API

This document defines the current sensor boundary and the payload contracts used by the mower runtime.

## Overview

The application has one sensor polling owner:

- `SensorController` (`src/sensing/sensorController.ts`)

Hardware access is isolated behind:

- `SensorHardwareGateway` (`src/sensing/sensorHardwareGateway.ts`)

This keeps application logic independent from device/protocol details.

## Polling Model

- One scheduler loop drives all sensor reads, but each sensor has its own
  cadence. The loop wakes at `SENSOR_SCHEDULER_TICK_MS` (8 ms by default)
  and only enqueues an I2C read for a sensor whose own deadline has elapsed.
- Default per-sensor cadences (from `src/constants.ts`):
  - IMU: `IMU_POLL_INTERVAL_MS` ≈ 8 ms (~125 Hz). Turn execution needs >100 Hz
    yaw integration to be accurate.
  - Motor feedback: `MOTOR_FEEDBACK_POLL_INTERVAL_MS` ≈ 20 ms (50 Hz).
    Encoders feed dead-reckoning and current sensing feeds stall detection.
  - GNSS: `GNSS_POLL_INTERVAL_MS` ≈ 50 ms (20 Hz). Matches the GNSS node's
    update rate; reading faster wastes I2C bandwidth.
- The IMU read is one 12-byte burst that returns gyro + accelerometer in a
  single I2C transaction.
- Latest successful value is retained per sensor; on error, last good values
  are preserved and error state is updated.
- If a tick falls more than one interval behind real time the scheduler
  snaps forward instead of busy-spinning to catch up.

## Application-Facing API

### IMU heading API

The controller exposes a heading-focused API:

- `getHeadingDegrees(): number`
- `setHeadingDegrees(headingDegrees: number): void`

`setHeadingDegrees(...)` resets the integrated IMU heading baseline to an absolute value (for example from GNSS), then integration continues from the new baseline. GNSS heading rebases supply the controller-clock reset timestamp, and direct heading resets fall back to the current controller clock, so the next IMU sample does not skip or double-count a turn interval.

For rough yaw-scale checks without a turn rig, the interactive utility `external-hardware/manual-tests/imu_gnss_turn_calibration.js` can log paired IMU and GNSS headings at `S`/`E` points while applying a local per-run IMU offset so the session starts aligned to the current GNSS heading. When you finish runs it exports the averaged yaw scale factor to `config/imu-yaw-calibration.json`, which `SensorController` loads at startup and applies to the integrated gyro heading.

### Primitive snapshot API

The web/API primitives payload contains separate domains:

- `imu`
- `gnss`
- `motors`

Current sensor-related shape:

```json
{
  "sampledAt": "2026-05-17T16:00:00.000Z",
  "sensorController": {
    "status": "running",
    "pollIntervalMs": 10,
    "lastLoopDurationMs": 3
  },
  "imu": {
    "status": "running",
    "error": null,
    "headingDeg": 42.1,
    "pitchDeg": 2.3,
    "rollDeg": -1.5
  },
  "gnss": {
    "status": "running",
    "error": null,
    "xMeters": 12.345,
    "yMeters": -1.234,
    "headingDeg": 88.7,
    "positionAccuracyMeters": 0.024,
    "headingAccuracyDeg": 0.6,
    "fixType": "fixed",
    "satellitesInUse": 22,
    "sampleAgeMillis": 110
  },
  "poseFusion": {
    "status": "ok",
    "error": null,
    "xMeters": 12.345,
    "yMeters": -1.234,
    "headingDeg": 42.1,
    "quality": "gnss",
    "usingGnssHeading": true
  },
  "motors": {
    "status": "idle",
    "error": null,
    "commandedLeftWheelOutputPercent": null,
    "commandedRightWheelOutputPercent": null,
    "leftRpm": null,
    "rightRpm": null,
    "leftEncoderDelta": null,
    "rightEncoderDelta": null,
    "leftPwmAppliedPercent": null,
    "rightPwmAppliedPercent": null,
    "leftMotorCurrentAmps": null,
    "rightMotorCurrentAmps": null,
    "watchdogHealthy": null,
    "faultFlags": null
  }
}
```

The `poseFusion.usingGnssHeading` flag is the app-level indicator the live widgets use for the green/orange sync background. It becomes true after the current pose-fusion process safely synchronises the IMU to an accepted absolute GNSS heading and remains true while the IMU owns heading between GNSS rebases. The browser does not compare headings itself, and one rejected GNSS epoch does not erase an already established heading baseline.

### Motor command API

The controller exposes motor command methods:

- `setMotorWheelOutputs(leftWheelOutputPercent, rightWheelOutputPercent)` to update the latest controller-level motion request
- `stopMotors()` brings the wheels to rest under the configured deceleration profile by sending a ramped target=0 with the drive still enabled. This is the only stop path used by drive completion, turn completion, mowing handovers, and similar end-of-operation transitions
- `emergencyStopMotors()` immediately disables the H-bridges. Reserved for the operator stop button (`POST /api/stop` and any per-feature "stop" button), confirmed stall detection, the I2C watchdog, and other genuine emergencies — anywhere the drivetrain shock of a hard kill is preferable to letting the wheels keep coasting for the deceleration window

The latest requested wheel pair is sent through the normal I2C queue when it changes. The motor I2C client owns one resettable timer which resends the current latest active command after one second, so a long-running controller does not need to generate heartbeat traffic. A changed command cancels the old timer before being queued, and the callback reads the current command rather than capturing an older target. Zero-output and disabled commands cancel the timer because an expired ESP32 lease is already safely stopped.
While `systemStop` is latched, `setMotorWheelOutputs` short-circuits and the sensor loop re-asserts the H-bridge disable on every poll; both together guarantee that no in-flight wheel-target value can race the latch.
The stationary pose-fusion timer is armed by an explicit zero-output command or a user/abort stop path, so a mower that has been stopped by the controller can still qualify for a GNSS heading rebase after the timeout.
Motor output commands at or below 10% magnitude are treated as zero before transmission, which gives the controller a little tolerance around the joystick center and helps stationary detection settle cleanly.
Non-zero motor output commands are raised to at least 30% magnitude before transmission. A one-wheel motion command is converted into a minimum active arc command so the hardware is not asked to move with only one active motor.
The stationary timer uses the controller clock rather than the GNSS sample timestamp, so a stale GNSS receiver time cannot suppress the stop timeout.
The motor node command payload sent over I2C uses normalized percentages, where `1.0` is full output and `0.0` is stop.
IMU yaw-bias auto-recalibration is an idle-only maintenance action. It is suppressed while any motion session is active and only re-arms after the mower has been idle for about 30 minutes, so active tuning and test runs do not get their heading baseline nudged mid-session.

### Obstruction detection

The sensor controller raises a stall obstruction when:

- one or both wheels are commanded hard but the mower does not make progress over the observation window

That keeps normal steering corrections available while still catching a mower that is slipping or stuck and no longer advancing on GNSS even though motion is still being commanded.

## Heading Convention

Internal heading convention for both IMU and GNSS:

- `0°` points along `+X`
- positive rotation is counterclockwise toward `+Y`
- normalized to signed range `(-180, 180]`

GNSS heading from field/navigation convention (`0° = north`, clockwise positive) is rotated before exposure:

- `internalHeading = normalize(90 - fieldHeading)`

## IMU Integration Details

### Data Sources

The IMU sensor provides:

- **BMI160 gyroscope**: 3-axis angular velocity (`xDegreesPerSecond`, `yDegreesPerSecond`, `zDegreesPerSecond`)
- **BMI160 accelerometer**: 3-axis acceleration (X, Y, Z in m/s²) for pitch and roll calculation

The BMI160 gyro is configured for the `2000 dps` range, which corresponds to `16.4 LSB/dps` in this runtime.

### Heading Integration

- `heading += tiltCompensatedYawRateDegPerSec * deltaSeconds`
- the controller projects the 3-axis gyro vector onto the current gravity axis derived from pitch and roll before integrating yaw
- first sample sets timestamp reference only
- subsequent samples integrate using sample-to-sample timestamp delta
- heading always normalized to `(-180, 180]`

`SensorController` also keeps a short in-memory IMU diagnostic window so the runtime can emit one compact turn summary when pose fusion rebases GNSS heading. That gives us the raw sample interval and integrated yaw evidence without writing a log line for every IMU sample.
When a non-zero motor command transitions to a stop command, the controller snapshots that same window as `sensor.imu.motion_stop_summary`. Pose fusion prefers this stop-time summary when it later logs a GNSS heading rebase, because the actual turn may be several seconds behind the stationary rebase. A GNSS heading rebase is forbidden while any motion session remains active and subsequently requires zero commanded motor output plus fresh IMU yaw-rate samples continuously within 1 degree/second for one second. Encoder feedback is not used to decide rebase readiness.

GNSS heading rebases are only allowed when no motion session is active, the motor command is stopped, and the bias-corrected tilt-compensated yaw rate has remained within 1 deg/s for one second with fresh IMU sampling. During active turns the GNSS heading can still be observed for quality and position updates, but it does not write back into the IMU heading baseline.

### Pitch and Roll Calculation

Pitch and roll are derived from accelerometer readings using the gravity vector:

- **Pitch** (rotation around Y-axis, tilt front-to-back):
  - `pitch = atan2(-ax, sqrt(ay² + az²)) * 180/π`
  - Positive pitch = nose up, negative pitch = nose down
  
- **Roll** (rotation around X-axis, tilt side-to-side):
  - `roll = atan2(ay, az) * 180/π`
  - Positive roll = right side down, negative roll = left side down

### Calibration and Zeroing

At startup, the IMU performs calibration by sampling sensor noise:

1. **Gyroscope bias calibration**: Averages all three gyro axes over the default 240 stationary samples to determine drift offsets
2. **Pitch/roll zeroing**: Averages pitch and roll calculations over the same stationary sample window to establish level reference
3. All subsequent readings subtract these calibrated offsets

This allows the mower to zero its tilt reference on uneven ground during startup.

## GNSS I2C/Protocol

### Addressing and transport

- `src/constants.ts` is the sole source of Pi-side default bus and device addresses. Production modules and built manual utilities import those defaults; environment variables remain the supported override boundary.
- Shared Pi I2C bus: `MOWER_I2C_BUS_NUMBER` (default `1`)
- GNSS node I2C address: `MOWER_GNSS_I2C_ADDRESS` (default `0x52`)

### Framed request/response

Request/response uses framed messages:

- Start-of-frame: `0x4d`
- Header bytes:
  - `version`
  - `nodeId`
  - `messageType`
  - `flags`
  - `sequence` (`uint16`, little-endian)
  - `payloadLength` (`uint16`, little-endian)
- Payload bytes
- CRC16-CCITT (`uint16`, little-endian) over header+payload excluding start byte

The Pi requires an exact frame length, the current protocol version, GNSS node
and message identifiers, a valid CRC, and a response sequence matching the
request. A response from an earlier transaction is rejected rather than being
published as current telemetry.

The 40-byte GNSS sample uses `sampleAgeMillis = 65535` to mean that the rover
ESP has no fresh, usable `PVTSLNA` receiver sample. This is an unavailable-data
sentinel, not a real satellite observation. The Pi rejects the entire sample,
marks GNSS transport/receiver status as errored, and retains the last successful
position and satellite count for diagnosis.

GNSS sample request:

- `nodeId = 0x10`
- `messageType = 0x01`
- empty payload

GNSS low-satellite debug request:

- `nodeId = 0x10`
- `messageType = 0x02`
- empty payload

When the receiver reports fewer than the trusted satellite threshold, the ESP32
retains the latest raw `PVTSLNA` text payload after the semicolon and exposes
it through this debug frame so the Pi can write it into the normal session log.
That keeps the forensic text available over SSH without needing a USB serial
console on the machine.

### GNSS payload variants

The runtime currently supports the compact `40` byte GNSS sample layout from
node firmware.

### `GnssSample` fields and meaning

- `timestampMillis`: sample timestamp reported by node
- `xMeters`: planar X in meters
- `yMeters`: planar Y in meters
- `headingDegrees` (optional): field/navigation heading before rotation
- `pitchDegrees` (optional): pitch estimate from node
- `groundSpeedMetersPerSecond` (optional): speed estimate
- `positionAccuracyMeters`: horizontal position accuracy estimate
- `headingAccuracyDegrees` (optional): heading accuracy estimate
- `fixType`: one of `none | single | float | fixed`
- `satellitesInUse`: satellites used in the current solution
- `sampleAgeMillis`: node-reported age of GNSS sample
- `debug` (optional):
  - `receiverLineAgeMillis`
  - `pvtslnaAgeMillis`
  - `uniheadingAgeMillis`
  - `rtcmAgeMillis`
  - `logConfigMask`

### Vehicle geometry correction

The runtime treats the GNSS sample position as a fixed receiver reference point and then translates that point into the mower control point using a calibrated body-frame offset:

- `positionOffsetForwardMeters`: distance from the raw GNSS reference point toward the mower nose
- `positionOffsetRightMeters`: distance from the raw GNSS reference point toward the mower's right-hand side

That offset is applied before the position is exposed through `SensorController`, `PoseFusion`, and the primitive snapshot. Because the receiver position may arrive late while the mower is pivoting, `SensorController` subtracts the receiver-claimed `sampleAgeMillis` from the Pi arrival timestamp and uses wrap-safe interpolation in its recent IMU-heading history. Applying the arrival-time heading to an older antenna position would rotate the 23 cm geometry offset to the wrong place and can falsely appear as chassis translation. Drive diagnostics retain the raw antenna position, effective correction timestamp, correction heading, and adjusted control point for later comparison.

The manual calibration utility `external-hardware/manual-tests/rotation_center_calibration.js` estimates the offset by slowly spinning the mower through at least one full rotation and fitting the observed GNSS trace to a circle.
For quick field tuning, `config/geometry-calibration.json` is the live persisted value the runtime loads at startup, so small manual nudges to `positionOffsetForwardMeters` and `positionOffsetRightMeters` will immediately affect the mower reference point on the next restart.

## Error Handling

- GNSS read path retries short transient failures (`maxAttempts`, short delay).
- Frame decode rejects invalid SOF, short frame, bad CRC, and unexpected node/message types.
- Sensor controller updates `gnss.status = "error"` with message and keeps previous numeric values for visibility.

## Motor I2C/Protocol

### Addressing and transport

- Motor node I2C address: `MOWER_MOTOR_I2C_ADDRESS` (default `0x66`)
- Motor direction signs:
  - `MOWER_LEFT_MOTOR_FORWARD_SIGN` (default `-1`)
  - `MOWER_RIGHT_MOTOR_FORWARD_SIGN` (default `-1`)

Runtime convention is application-facing forward-positive normalized wheel output (`-1..1`, where `1` is full forward output). Direction-sign inversion is applied in the motor hardware gateway when converting:
- app command -> raw motor command
- raw motor feedback -> app-facing feedback

### Framed messages

The same common frame contract is used.

Motor message types:

- `0x21`: wheel output command
- `0x22`: motor feedback sample

### Wheel output command payload (`15` bytes)

- `timestampMillis` (`uint32`)
- `leftWheelTargetPercent` (`int16`, scale `1/1000`)
- `rightWheelTargetPercent` (`int16`, scale `1/1000`)
- `enableDrive` (`uint8`, `1` enabled / `0` stop)
- `commandTimeoutMillis` (`uint16`)
- `maxAccelerationPercentPerSecond` (`uint16`, optional, `0xffff` sentinel, scale `1/1000`)
- `maxDecelerationPercentPerSecond` (`uint16`, optional, `0xffff` sentinel, scale `1/1000`)

### Motor feedback payload (`22` bytes)

- `timestampMillis` (`uint32`)
- `leftEncoderDelta` (`int32`)
- `rightEncoderDelta` (`int32`)
- `leftPwmAppliedPercent` (`int8`)
- `rightPwmAppliedPercent` (`int8`)
- `leftMotorCurrentAmps` (optional `uint16`, `0xffff` sentinel, scale `1/10`)
- `rightMotorCurrentAmps` (optional `uint16`, `0xffff` sentinel, scale `1/10`)
- `watchdogHealthy` (`uint8`)
- `faultFlags` (`uint16`)

The ESP32 motor node sends raw encoder deltas only. The Pi-side hardware gateway applies the configured motor direction signs before the sensor controller publishes them, so positive app-facing deltas mean logical forward travel. No metres-per-second conversion is performed at runtime, because the encoder-to-metres calibration is the responsibility of the dead-reckoning calibrator alone and the rest of the system avoids absolute speeds on principle.

For control and stationary-detection purposes the only motor feedback values consumed are the raw encoder deltas per sample (`leftEncoderDelta`, `rightEncoderDelta`).

The sensor controller rejects samples above 1,000 ticks per wheel as physically implausible. After any failed or rejected feedback sample it requires three consecutive coherent frames before publishing motor feedback again. Ten consecutive failed polls latch `systemStop` with reason `motor_feedback_unavailable` and request an H-bridge disable; the disable is retried periodically while feedback remains unavailable. Repeated poll errors are logged at most once every five seconds and a recovery summary records the outage duration and failure count.

The Pi motor client establishes a disabled command during hardware initialization and refreshes the latest active, neutral, or disabled command before the ESP command lease expires. An idle mower therefore continues to report a healthy command watchdog for motion-start validation, while loss of the Pi heartbeat still expires the lease and leaves the H-bridges disabled. Hardware-gateway shutdown cancels the refresh timer after sending the final disabled command.

### Motor queue priorities

- Stop command priority: `1` (`I2C_PRIORITY.stop`)
- Normal motor speed commands priority: `2` (`I2C_PRIORITY.motorSpeed`)
- Motor feedback read priority: `2`

This ensures queued stop commands are sent ahead of other queued traffic.

## Game Controller Interface

The runtime supports a HID game controller interface for manual drive.

Default controller signs in this runtime:
- `MOWER_CONTROLLER_STEERING_SIGN=-1`
- `MOWER_CONTROLLER_SPEED_SIGN=1`

### Manual drive arm/disarm

- `right-top` button: arm manual drive
- `left-top` button: disarm manual drive and issue motor stop

### Joystick mapping

The mapping follows the previous working model:

- Steering byte: `data[3]` to angle in `[-90, 90]` degrees
- Speed byte: `data[4]` to speed demand in `[-1, 1]`
- Speed deadband near center: magnitude under `0.02` is treated as `0`

Manual demand shaping then converts speed + turn demand into wheel targets (straight/arc/spin modes) and sends those targets through the normal motor command path.
Manual wheel outputs are quantized into small 2% steps before comparison so tiny held-stick jitter is coalesced instead of creating unnecessary I2C writes.

Path and perimeter recording consumes fused poses, but it only writes GNSS-quality poses and skips implausible jumps between consecutive recorded points. This prevents degraded GNSS or dead-reckoning drift from being persisted as long spikes in saved boundaries.

### Motion path

Manual-drive commands are not applied directly to PWM. They flow through the same wheel-speed command primitive used by the rest of the app, so the motor node's ramping and latched-command behavior still apply.

If controller connection drops while manual drive is armed, the runtime disarms manual mode and issues a stop command.
