davidgoddard/mower2026/external-hardware/manual-tests/manual_drive_dashboard.html

# Manual Drive Live

Controller-driven mower view. Press controller top or right-top to enable drive, and press cross or left-top to stop and disable drive.

Position Map (Last 10 Minutes)

Waiting for position data...

Heading History (last hour)

IMU (fused) GNSS heading ± accuracy

Waiting for heading data...

Position Accuracy History (last hour)

GNSS position accuracy (m)

Waiting for accuracy data...

Controller

Waiting

No controller state yet

Command

Stopped

No wheel command yet

Estimate

Waiting

No fused estimate yet

Controller Demand

Angle

Speed

Left Target

Right Target

No button events yet

Motion Feedback

Left Actual

Right Actual

Vehicle Speed

Turn Bias

No motor feedback yet

GNSS

Fix

Heading

Speed

Age

No GNSS data yet

IMU

Roll

Pitch

Gyro Z

Gravity

No IMU data yet

Raw Controller State

Waiting for controller packets...

Notes
