davidgoddard/mower2026/external-hardware/manual-tests/imu_viewer.html

Manual Bring-Up

# Mower IMU Viewer

Incline shows the overall angle away from level. Roll and pitch show which axis is tilted. Yaw is relative only and is integrated from the Z gyro while this page is running.

Waiting for IMU stream...

Incline

0.00 deg

Roll

0.00 deg

Pitch

0.00 deg

Yaw

0.00 deg

Gravity

0.00 m/s^2

Angular Velocity

x: 0.000 y: 0.000 z: 0.000

Acceleration

x: 0.000 y: 0.000 z: 0.000

Timestamp

No samples yet

The viewer is mainly for orientation sanity checks. If the mower is stationary, gyro values should hover near zero and gravity magnitude should stay close to 9.8.
