davidgoddard/mower2026/external-hardware/manual-tests/site_capture_dashboard.html

# Site Capture

Drive manually, start perimeter capture, then add obstacles. Points are auto-sampled from live pose changes and saved as site JSON.

Controller

Waiting

No controller state yet

Pose

Waiting

No fused estimate yet

Capture

Idle

No active capture

Capture Controls

Start Perimeter Finish Perimeter Start Obstacle Finish Obstacle Undo Last Point Discard Obstacle Finish Capture Discard Capture

Actions are sent directly to the live capture server.

Live Pose

X

Y

Heading

Confidence

No capture samples recorded yet

Capture Summary

Perimeter Points

Obstacles

Active Points

Warnings

No site JSON saved yet

Geometry Preview

Green = perimeter. Rust = obstacle. Dotted grey = active capture. Blue dot = current pose.

Warnings

Raw Capture State

Waiting for capture state...

Notes
