davidgoddard/mower2026/external-hardware/esp32/motor-controller/motor-controller.ino

#include <Arduino.h>
#include <Wire.h>
#include "driver/ledc.h"
#include "esp_task_wdt.h"
#include "esp_idf_version.h"

// Second-generation motor controller for ESP32.
// It accepts explicit left/right wheel percentage targets over I2C, applies
// local ramping and safe direction reversals, and returns a coherent feedback
// snapshot with FG pulse deltas, applied PWM, current, and watchdog/fault
// state.
//
// This sketch intentionally does NOT run any local wheel-speed regulation from
// encoder feedback. The Pi is the controller. This ESP32 is only a ramped PWM
// bridge plus telemetry source.
//
// Encoder signing: each tachometer line is single-channel (no quadrature), so
// pulse direction is inferred from a cached "last commanded direction" sign
// per wheel (g_leftDirSign / g_rightDirSign). applyMotorHardware updates the
// cache in lockstep with the DIR-pin write, so the cache is the canonical
// record of the last commanded direction and the encoder ISR signs each
// pulse from it directly. The cache is only flipped after the firmware has
// ramped PWM magnitude through zero, so coast pulses during brake-to-stop
// and during direction reversals are signed by the direction the wheel was
// actually rolling at the moment of the pulse — not by whether the motor
// is currently powered.

// ===== I2C / protocol =====
static const uint8_t I2C_SLAVE_ADDRESS = 0x66;
static const uint8_t PROTOCOL_START_OF_FRAME = 0x4D;
static const uint8_t PROTOCOL_VERSION = 0x01;
static const uint8_t NODE_ID_MOTOR = 0x20;
static const uint8_t MESSAGE_TYPE_WHEEL_SPEED_COMMAND = 0x21;
static const uint8_t MESSAGE_TYPE_MOTOR_FEEDBACK = 0x22;
static const uint8_t MESSAGE_TYPE_CURRENT_CALIBRATION_COMMAND = 0x23;

static const size_t FRAME_HEADER_SIZE = 9;
static const size_t FRAME_CRC_SIZE = 2;
static const size_t WHEEL_COMMAND_PAYLOAD_SIZE = 15;
static const size_t MOTOR_FEEDBACK_PAYLOAD_SIZE = 21;
static const size_t MOTOR_FEEDBACK_FRAME_SIZE = FRAME_HEADER_SIZE + MOTOR_FEEDBACK_PAYLOAD_SIZE + FRAME_CRC_SIZE;
static const size_t MAX_FRAME_SIZE = MOTOR_FEEDBACK_FRAME_SIZE;

// ===== Pins =====
static const uint8_t SDA_PIN = 16;
static const uint8_t SCL_PIN = 17;

static const uint8_t LEFT_PWM_PIN = 5;
static const uint8_t LEFT_DIR_PIN = 18;
static const uint8_t RIGHT_PWM_PIN = 14;
static const uint8_t RIGHT_DIR_PIN = 19;

static const uint8_t LEFT_TACH_PIN = 21;
static const uint8_t RIGHT_TACH_PIN = 22;
static const uint8_t LEFT_CURRENT_SENSE_PIN = 34;
static const uint8_t RIGHT_CURRENT_SENSE_PIN = 35;

// ===== PWM =====
static const uint32_t PWM_FREQ_HZ = 30000;
static const ledc_mode_t PWM_MODE = LEDC_HIGH_SPEED_MODE;
static const ledc_timer_bit_t PWM_RESOLUTION = LEDC_TIMER_8_BIT;
static const ledc_timer_t PWM_TIMER = LEDC_TIMER_0;
static const ledc_channel_t LEFT_CHANNEL = LEDC_CHANNEL_0;
static const ledc_channel_t RIGHT_CHANNEL = LEDC_CHANNEL_1;
static const int PWM_MAX_DUTY = 255;

// ===== Control / reporting =====
static const uint32_t CONTROL_PERIOD_MS = 10;      // 100 Hz
static const uint32_t FEEDBACK_PERIOD_MS = 50;     // 20 Hz
static const uint32_t TASK_WATCHDOG_TIMEOUT_SECONDS = 5;
// Decel / accel rates in %/s.  At 100 Hz (10 ms ticks):
//   stepPerTick = rate × elapsedMs / 1000 = rate × 0.010
// DEFAULT_DECEL_PERCENT_PER_SECOND = 250  →  2.5 %/tick  →  40-tick (400 ms) full stop.
// DEFAULT_ACCEL_PERCENT_PER_SECOND = 167  →  1.67 %/tick →  60-tick (600 ms) full spin-up.
static const float DEFAULT_DECEL_PERCENT_PER_SECOND = 250.0f;
static const float DEFAULT_ACCEL_PERCENT_PER_SECOND = 167.0f;
static const float DEFAULT_MIN_EFFECTIVE_WHEEL_OUTPUT_PERCENT = 0.025f;
static const float CURRENT_SENSOR_SUPPLY_VOLTS = 3.3f;
static const float CURRENT_SENSOR_VOLTS_PER_AMP = 0.185f;  // ACS712ELC-05B typical sensitivity
static const float CURRENT_SENSOR_FILTER_ALPHA = 0.2f;
static const uint16_t CURRENT_SENSOR_CALIBRATION_SAMPLES = 128;
static const uint16_t ADC_MAX_COUNT = 4095;

// ===== Fault bits =====
static const uint16_t MOTOR_FAULT_LEFT_DRIVER = (1u << 3);
static const uint16_t MOTOR_FAULT_RIGHT_DRIVER = (1u << 4);
static const uint16_t MOTOR_FAULT_OVERCURRENT = (1u << 5);
static const uint16_t MOTOR_FAULT_COMMAND_TIMEOUT = (1u << 0);

struct WheelSpeedCommand {
  uint32_t timestampMillis;
  float leftWheelTargetPercent;
  float rightWheelTargetPercent;
  bool enableDrive;
  uint16_t commandTimeoutMillis;
  bool hasAccelLimit;
  float maxAccelerationPercentPerSecond;
  bool hasDecelLimit;
  float maxDecelerationPercentPerSecond;
};

struct FeedbackSnapshot {
  uint32_t timestampMillis;
  int32_t leftEncoderDelta;
  int32_t rightEncoderDelta;
  int8_t leftPwmAppliedPercent;
  int8_t rightPwmAppliedPercent;
  float leftMotorCurrentAmps;
  float rightMotorCurrentAmps;
  bool watchdogHealthy;
  uint16_t faultFlags;
};

struct MotorState {
  const char *label;
  ledc_channel_t pwmChannel;
  uint8_t pwmPin;
  uint8_t dirPin;
  bool inverted;
  int8_t appliedPwmPercent;
  int8_t requestedPwmPercent;
  int8_t currentDirectionSign;
  bool directionChangePending;
  float targetPercent;
  float rampedTargetPercent;
};

struct CurrentSensorState {
  uint8_t pin;
  float zeroVoltageVolts;
  float filteredCurrentAmps;
};

volatile int32_t g_leftPulseAccumulator = 0;
volatile int32_t g_rightPulseAccumulator = 0;
volatile uint32_t g_lastLeftPulseMicros = 0;
volatile uint32_t g_lastRightPulseMicros = 0;
// Last sign written to the DIR pin for each wheel. The encoder ISRs sign
// each pulse by this value so coast pulses during brake-to-stop are
// attributed to the direction the wheel was last driven, not zeroed.
// applyMotorHardware updates these together with the digitalWrite that
// drives the DIR pin, so there is exactly one source of truth.
volatile int8_t g_leftDirSign = 1;
volatile int8_t g_rightDirSign = 1;
static const uint32_t ENCODER_DEBOUNCE_MICROS = 800;

MotorState g_leftMotor = { "left", LEFT_CHANNEL, LEFT_PWM_PIN, LEFT_DIR_PIN, false, 0, 0, 1, false, 0.0f, 0.0f };
MotorState g_rightMotor = { "right", RIGHT_CHANNEL, RIGHT_PWM_PIN, RIGHT_DIR_PIN, true, 0, 0, 1, false, 0.0f, 0.0f };

WheelSpeedCommand g_latestCommand = { 0, 0.0f, 0.0f, false, 0, false, 0.0f, false, 0.0f };
FeedbackSnapshot g_latestFeedback = { 0, 0, 0, 0, 0, 0.0f, 0.0f, false, 0 };
CurrentSensorState g_leftCurrentSensor = { LEFT_CURRENT_SENSE_PIN, CURRENT_SENSOR_SUPPLY_VOLTS / 2.0f, 0.0f };
CurrentSensorState g_rightCurrentSensor = { RIGHT_CURRENT_SENSE_PIN, CURRENT_SENSOR_SUPPLY_VOLTS / 2.0f, 0.0f };

portMUX_TYPE g_protocolStateMux = portMUX_INITIALIZER_UNLOCKED;

uint8_t g_txFrames[2][MOTOR_FEEDBACK_FRAME_SIZE];
volatile uint8_t g_activeTxFrameIndex = 0;
uint16_t g_feedbackSequence = 0;
uint32_t g_lastValidCommandMillis = 0;
bool g_haveValidCommand = false;
bool g_commandLeaseHealthy = false;
bool g_haveAcceptedWheelCommandSequence = false;
uint16_t g_lastAcceptedWheelCommandSequence = 0;
volatile bool g_currentCalibrationRequested = false;
bool g_currentSensorsCalibrated = false;

uint32_t g_lastControlMillis = 0;
uint32_t g_lastFeedbackMillis = 0;

// ===== Helpers =====
uint16_t crc16Ccitt(const uint8_t *data, size_t length) {
  uint16_t crc = 0xFFFF;
  for (size_t index = 0; index < length; index += 1) {
    crc ^= static_cast<uint16_t>(data[index]) << 8;
    for (uint8_t bit = 0; bit < 8; bit += 1) {
      if ((crc & 0x8000) != 0) {
        crc = static_cast<uint16_t>((crc << 1) ^ 0x1021);
      } else {
        crc = static_cast<uint16_t>(crc << 1);
      }
    }
  }
  return crc;
}

uint16_t readU16LE(const uint8_t *bytes) {
  return static_cast<uint16_t>(bytes[0]) | (static_cast<uint16_t>(bytes[1]) << 8);
}

uint32_t readU32LE(const uint8_t *bytes) {
  return static_cast<uint32_t>(bytes[0])
       | (static_cast<uint32_t>(bytes[1]) << 8)
       | (static_cast<uint32_t>(bytes[2]) << 16)
       | (static_cast<uint32_t>(bytes[3]) << 24);
}

int16_t readI16LE(const uint8_t *bytes) {
  return static_cast<int16_t>(readU16LE(bytes));
}

int32_t readI32LE(const uint8_t *bytes) {
  return static_cast<int32_t>(readU32LE(bytes));
}

bool isNewerSequence(uint16_t candidate, uint16_t previous) {
  return static_cast<int16_t>(candidate - previous) > 0;
}

void writeU16LE(uint8_t *bytes, uint16_t value) {
  bytes[0] = static_cast<uint8_t>(value & 0xFF);
  bytes[1] = static_cast<uint8_t>((value >> 8) & 0xFF);
}

void writeU32LE(uint8_t *bytes, uint32_t value) {
  bytes[0] = static_cast<uint8_t>(value & 0xFF);
  bytes[1] = static_cast<uint8_t>((value >> 8) & 0xFF);
  bytes[2] = static_cast<uint8_t>((value >> 16) & 0xFF);
  bytes[3] = static_cast<uint8_t>((value >> 24) & 0xFF);
}

void writeI16LE(uint8_t *bytes, int16_t value) {
  writeU16LE(bytes, static_cast<uint16_t>(value));
}

void writeI32LE(uint8_t *bytes, int32_t value) {
  writeU32LE(bytes, static_cast<uint32_t>(value));
}

int8_t clampPercent(int value) {
  if (value < -100) return -100;
  if (value > 100) return 100;
  return static_cast<int8_t>(value);
}

float clampFloat(float value, float minValue, float maxValue) {
  if (value < minValue) return minValue;
  if (value > maxValue) return maxValue;
  return value;
}

uint16_t encodeCurrentTenths(float amps) {
  float clamped = clampFloat(amps, 0.0f, 6553.4f);
  return static_cast<uint16_t>((clamped * 10.0f) + 0.5f);
}

// ===== Encoder ISR =====
//
// Single-line tachometer: each pulse reports physical wheel rotation, but the
// pulse alone has no direction. We sign each pulse by g_leftDirSign /
// g_rightDirSign, which applyMotorHardware updates atomically with the
// DIR-pin write — so the cache is the canonical record of the last
// commanded direction. Crucially this is correct during the brake/coast
// window (DIR is unchanged, so coast pulses inherit the last commanded
// direction) and during a direction reversal (the firmware ramps PWM
// magnitude to zero before flipping DIR, so deceleration pulses keep the
// OLD sign and post-flip pulses pick up the NEW sign).
void IRAM_ATTR onLeftPulse() {
  uint32_t now = micros();
  if (now - g_lastLeftPulseMicros > ENCODER_DEBOUNCE_MICROS) {
    g_leftPulseAccumulator += g_leftDirSign;
    g_lastLeftPulseMicros = now;
  }
}

void IRAM_ATTR onRightPulse() {
  uint32_t now = micros();
  if (now - g_lastRightPulseMicros > ENCODER_DEBOUNCE_MICROS) {
    g_rightPulseAccumulator += g_rightDirSign;
    g_lastRightPulseMicros = now;
  }
}

// ===== Protocol handling =====
bool decodeFrame(const uint8_t *frame, size_t length, uint8_t &messageType, uint16_t &sequence, const uint8_t *&payload, uint16_t &payloadLength) {
  if (length < FRAME_HEADER_SIZE + FRAME_CRC_SIZE) {
    return false;
  }
  if (frame[0] != PROTOCOL_START_OF_FRAME || frame[1] != PROTOCOL_VERSION || frame[2] != NODE_ID_MOTOR) {
    return false;
  }

  messageType = frame[3];
  sequence = readU16LE(&frame[5]);
  payloadLength = readU16LE(&frame[7]);
  size_t expectedLength = FRAME_HEADER_SIZE + payloadLength + FRAME_CRC_SIZE;
  if (length != expectedLength) {
    return false;
  }

  uint16_t actualCrc = readU16LE(&frame[FRAME_HEADER_SIZE + payloadLength]);
  uint16_t expectedCrc = crc16Ccitt(&frame[1], FRAME_HEADER_SIZE - 1 + payloadLength);
  if (actualCrc != expectedCrc) {
    return false;
  }

  payload = &frame[FRAME_HEADER_SIZE];
  return true;
}

size_t encodeFrame(uint8_t messageType, uint16_t sequence, uint8_t flags, const uint8_t *payload, uint16_t payloadLength, uint8_t *outFrame) {
  outFrame[0] = PROTOCOL_START_OF_FRAME;
  outFrame[1] = PROTOCOL_VERSION;
  outFrame[2] = NODE_ID_MOTOR;
  outFrame[3] = messageType;
  outFrame[4] = flags;
  writeU16LE(&outFrame[5], sequence);
  writeU16LE(&outFrame[7], payloadLength);
  memcpy(&outFrame[FRAME_HEADER_SIZE], payload, payloadLength);
  uint16_t crc = crc16Ccitt(&outFrame[1], FRAME_HEADER_SIZE - 1 + payloadLength);
  writeU16LE(&outFrame[FRAME_HEADER_SIZE + payloadLength], crc);
  return FRAME_HEADER_SIZE + payloadLength + FRAME_CRC_SIZE;
}

bool decodeWheelSpeedCommandPayload(const uint8_t *payload, uint16_t payloadLength, WheelSpeedCommand &command) {
  if (payloadLength != WHEEL_COMMAND_PAYLOAD_SIZE) {
    return false;
  }

  command.timestampMillis = readU32LE(&payload[0]);
  command.leftWheelTargetPercent = static_cast<float>(readI16LE(&payload[4])) / 1000.0f;
  command.rightWheelTargetPercent = static_cast<float>(readI16LE(&payload[6])) / 1000.0f;
  command.enableDrive = payload[8] == 1;
  command.commandTimeoutMillis = readU16LE(&payload[9]);

  uint16_t accelRaw = readU16LE(&payload[11]);
  command.hasAccelLimit = accelRaw != 0xFFFF;
  command.maxAccelerationPercentPerSecond = command.hasAccelLimit ? static_cast<float>(accelRaw) / 1000.0f : 0.0f;

  uint16_t decelRaw = readU16LE(&payload[13]);
  command.hasDecelLimit = decelRaw != 0xFFFF;
  command.maxDecelerationPercentPerSecond = command.hasDecelLimit ? static_cast<float>(decelRaw) / 1000.0f : 0.0f;
  return true;
}

void encodeMotorFeedbackPayload(const FeedbackSnapshot &feedback, uint8_t *payloadOut) {
  writeU32LE(&payloadOut[0], feedback.timestampMillis);
  writeI32LE(&payloadOut[4], feedback.leftEncoderDelta);
  writeI32LE(&payloadOut[8], feedback.rightEncoderDelta);
  payloadOut[12] = static_cast<uint8_t>(feedback.leftPwmAppliedPercent);
  payloadOut[13] = static_cast<uint8_t>(feedback.rightPwmAppliedPercent);
  writeU16LE(&payloadOut[14], encodeCurrentTenths(feedback.leftMotorCurrentAmps));
  writeU16LE(&payloadOut[16], encodeCurrentTenths(feedback.rightMotorCurrentAmps));
  payloadOut[18] = feedback.watchdogHealthy ? 1 : 0;
  writeU16LE(&payloadOut[19], feedback.faultFlags);
}

// ===== Low-level motor output =====
void applyMotorHardware(MotorState &motor) {
  int8_t dirSign = motor.currentDirectionSign >= 0 ? 1 : -1;
  int directionBit = dirSign >= 0 ? 0 : 1;
  digitalWrite(motor.dirPin, directionBit ^ (motor.inverted ? 1 : 0));

  // Mirror the sign that just drove the DIR pin into the volatile cache the
  // encoder ISR reads. Doing it here (the only place that writes the DIR
  // pin) keeps the cache and the pin in lockstep — the ISR can rely on the
  // cache being a faithful record of the last commanded direction.
  if (motor.dirPin == LEFT_DIR_PIN) {
    g_leftDirSign = dirSign;
  } else if (motor.dirPin == RIGHT_DIR_PIN) {
    g_rightDirSign = dirSign;
  }

  int duty = (abs(motor.appliedPwmPercent) * PWM_MAX_DUTY) / 100;
  ledc_set_duty(PWM_MODE, motor.pwmChannel, duty);
  ledc_update_duty(PWM_MODE, motor.pwmChannel);
}

void forceMotorStop(MotorState &motor) {
  motor.requestedPwmPercent = 0;
  motor.appliedPwmPercent = 0;
  // Leave currentDirectionSign at its last non-zero value. The DIR pin is
  // driven from this field, and the encoder ISR signs coast pulses by the
  // pin level. Zeroing the sign here would flip the DIR pin to a default
  // ("forward") while the wheel is still coasting in the prior direction,
  // mis-signing every coast pulse during the brake-to-stop window.
  motor.targetPercent = 0.0f;
  motor.rampedTargetPercent = 0.0f;
  applyMotorHardware(motor);
}

void stepMotorTowardRequested(MotorState &motor, uint32_t elapsedMs, float accelRatePercentPerSecond, float decelRatePercentPerSecond) {
  // The Pi owns control. This ESP32 only ramps the requested duty toward the
  // latest accepted target and handles safe direction reversals through zero.
  motor.rampedTargetPercent = motor.targetPercent;

  if (fabs(motor.rampedTargetPercent) < DEFAULT_MIN_EFFECTIVE_WHEEL_OUTPUT_PERCENT) {
    motor.requestedPwmPercent = 0;
  } else {
    motor.requestedPwmPercent = clampPercent(
      static_cast<int>(motor.rampedTargetPercent * 100.0f)
    );
  }

  int targetSign = motor.requestedPwmPercent >= 0 ? 1 : -1;
  int targetMagnitude = abs(motor.requestedPwmPercent);
  int currentMagnitude = abs(motor.appliedPwmPercent);
  float activeRate = (targetMagnitude > currentMagnitude) ? accelRatePercentPerSecond : decelRatePercentPerSecond;
  int maxStep = stepFromRate(activeRate, elapsedMs);

  if (motor.appliedPwmPercent != 0 && motor.currentDirectionSign != targetSign && targetMagnitude > 0) {
    int reduced = currentMagnitude - maxStep;
    if (reduced < 0) reduced = 0;
    motor.appliedPwmPercent = clampPercent(motor.currentDirectionSign * reduced);
    if (reduced == 0) {
      motor.currentDirectionSign = targetSign;
    }
    applyMotorHardware(motor);
    return;
  }

  int desiredSignedPercent = targetMagnitude == 0 ? 0 : targetSign * targetMagnitude;
  if (motor.appliedPwmPercent < desiredSignedPercent) {
    motor.appliedPwmPercent = clampPercent(motor.appliedPwmPercent + maxStep);
  } else if (motor.appliedPwmPercent > desiredSignedPercent) {
    motor.appliedPwmPercent = clampPercent(motor.appliedPwmPercent - maxStep);
  }

  int minimumMovingPwmPercent = max(
    1,
    static_cast<int>(DEFAULT_MIN_EFFECTIVE_WHEEL_OUTPUT_PERCENT * 100.0f)
  );
  int appliedMagnitude = abs(motor.appliedPwmPercent);
  bool effectiveMoveRequested = targetMagnitude > 0
    && fabs(motor.rampedTargetPercent) >= DEFAULT_MIN_EFFECTIVE_WHEEL_OUTPUT_PERCENT;
  if (effectiveMoveRequested && appliedMagnitude > 0 && appliedMagnitude < minimumMovingPwmPercent) {
    motor.appliedPwmPercent = clampPercent(targetSign * minimumMovingPwmPercent);
  } else if (targetMagnitude == 0 && appliedMagnitude < minimumMovingPwmPercent) {
    motor.appliedPwmPercent = 0;
  }

  if (motor.appliedPwmPercent > 0) {
    motor.currentDirectionSign = 1;
  } else if (motor.appliedPwmPercent < 0) {
    motor.currentDirectionSign = -1;
  }
  // When the applied PWM falls to zero we deliberately keep the last
  // non-zero direction sign. The DIR pin stays reflecting the direction
  // the wheel was last driven, so the encoder ISR signs coast pulses
  // correctly while the wheel rolls to a stop.
  applyMotorHardware(motor);
}

// Returns the per-tick step size (% units) for a given rate and elapsed time.
// rate is in %/s; elapsedMs is in ms.
// Example: rate=250, elapsed=10 → step=2.5 → truncates to 2 per tick.
inline int stepFromRate(float ratePercentPerSecond, uint32_t elapsedMs) {
  return max(1, static_cast<int>(ratePercentPerSecond * static_cast<float>(elapsedMs) / 1000.0f));
}

// ===== Control / feedback =====
float adcCountToVolts(int rawCount) {
  return (static_cast<float>(rawCount) / static_cast<float>(ADC_MAX_COUNT)) * CURRENT_SENSOR_SUPPLY_VOLTS;
}

void calibrateCurrentSensors() {
  uint32_t leftAccumulator = 0;
  uint32_t rightAccumulator = 0;
  for (uint16_t index = 0; index < CURRENT_SENSOR_CALIBRATION_SAMPLES; index += 1) {
    leftAccumulator += static_cast<uint32_t>(analogRead(g_leftCurrentSensor.pin));
    rightAccumulator += static_cast<uint32_t>(analogRead(g_rightCurrentSensor.pin));
    delay(2);
  }

  g_leftCurrentSensor.zeroVoltageVolts = adcCountToVolts(static_cast<int>(leftAccumulator / CURRENT_SENSOR_CALIBRATION_SAMPLES));
  g_rightCurrentSensor.zeroVoltageVolts = adcCountToVolts(static_cast<int>(rightAccumulator / CURRENT_SENSOR_CALIBRATION_SAMPLES));
  g_leftCurrentSensor.filteredCurrentAmps = 0.0f;
  g_rightCurrentSensor.filteredCurrentAmps = 0.0f;
  g_currentSensorsCalibrated = true;
}

float readCurrentSensor(CurrentSensorState &sensor) {
  if (!g_currentSensorsCalibrated) {
    return 0.0f;
  }
  const int rawCount = analogRead(sensor.pin);
  const float measuredVolts = adcCountToVolts(rawCount);
  const float signedCurrentAmps = (measuredVolts - sensor.zeroVoltageVolts) / CURRENT_SENSOR_VOLTS_PER_AMP;
  const float currentMagnitudeAmps = fabs(signedCurrentAmps);

  sensor.filteredCurrentAmps = (sensor.filteredCurrentAmps * (1.0f - CURRENT_SENSOR_FILTER_ALPHA))
    + (currentMagnitudeAmps * CURRENT_SENSOR_FILTER_ALPHA);
  return sensor.filteredCurrentAmps;
}

void refreshFeedbackSnapshot(uint32_t nowMillis) {
  static uint32_t lastSnapshotMillis = 0;
  uint32_t elapsedMs = nowMillis - lastSnapshotMillis;
  if (elapsedMs == 0) {
    elapsedMs = FEEDBACK_PERIOD_MS;
  }
  lastSnapshotMillis = nowMillis;

  // The encoder ISRs already sign each pulse by the live DIR-pin level, so
  // the accumulator is the signed pulse delta over this feedback window —
  // including coast pulses during brake-to-stop and ramp-down, which used
  // to be discarded by an unwanted "is the motor driven right now?" gate.
  int32_t signedLeftPulses = 0;
  int32_t signedRightPulses = 0;
  noInterrupts();
  signedLeftPulses = g_leftPulseAccumulator;
  signedRightPulses = g_rightPulseAccumulator;
  g_leftPulseAccumulator = 0;
  g_rightPulseAccumulator = 0;
  interrupts();

  g_latestFeedback.timestampMillis = nowMillis;
  g_latestFeedback.leftEncoderDelta = signedLeftPulses;
  g_latestFeedback.rightEncoderDelta = signedRightPulses;
  g_latestFeedback.leftPwmAppliedPercent = g_leftMotor.appliedPwmPercent;
  g_latestFeedback.rightPwmAppliedPercent = g_rightMotor.appliedPwmPercent;
  g_latestFeedback.leftMotorCurrentAmps = readCurrentSensor(g_leftCurrentSensor);
  g_latestFeedback.rightMotorCurrentAmps = readCurrentSensor(g_rightCurrentSensor);
  g_latestFeedback.faultFlags = g_commandLeaseHealthy ? 0 : MOTOR_FAULT_COMMAND_TIMEOUT;
  g_latestFeedback.watchdogHealthy = g_commandLeaseHealthy;

  uint8_t payload[MOTOR_FEEDBACK_PAYLOAD_SIZE];
  encodeMotorFeedbackPayload(g_latestFeedback, payload);

  const uint8_t inactiveIndex = static_cast<uint8_t>(1u - g_activeTxFrameIndex);
  encodeFrame(
    MESSAGE_TYPE_MOTOR_FEEDBACK,
    g_feedbackSequence,
    g_latestFeedback.faultFlags == 0 ? 0 : 0x01,
    payload,
    MOTOR_FEEDBACK_PAYLOAD_SIZE,
    g_txFrames[inactiveIndex]
  );
  g_feedbackSequence = static_cast<uint16_t>(g_feedbackSequence + 1u);
  g_activeTxFrameIndex = inactiveIndex;
}

void runControlStep(uint32_t nowMillis) {
  static uint32_t lastStepMillis = 0;
  WheelSpeedCommand commandSnapshot;
  portENTER_CRITICAL(&g_protocolStateMux);
  commandSnapshot = g_latestCommand;
  const uint32_t lastValidCommandMillis = g_lastValidCommandMillis;
  const bool haveValidCommand = g_haveValidCommand;
  portEXIT_CRITICAL(&g_protocolStateMux);

  const bool commandLeaseHealthy = haveValidCommand
    && commandSnapshot.commandTimeoutMillis > 0
    && nowMillis - lastValidCommandMillis <= commandSnapshot.commandTimeoutMillis;
  g_commandLeaseHealthy = commandLeaseHealthy;
  const bool requestsMotion = commandSnapshot.enableDrive
    && (fabs(commandSnapshot.leftWheelTargetPercent) >= DEFAULT_MIN_EFFECTIVE_WHEEL_OUTPUT_PERCENT
      || fabs(commandSnapshot.rightWheelTargetPercent) >= DEFAULT_MIN_EFFECTIVE_WHEEL_OUTPUT_PERCENT);
  if (requestsMotion && !g_currentSensorsCalibrated) {
    g_currentCalibrationRequested = true;
  }
  bool allowDrive = commandSnapshot.enableDrive && commandLeaseHealthy && g_currentSensorsCalibrated;

  float leftTarget = allowDrive ? commandSnapshot.leftWheelTargetPercent : 0.0f;
  float rightTarget = allowDrive ? commandSnapshot.rightWheelTargetPercent : 0.0f;
  g_leftMotor.targetPercent = leftTarget;
  g_rightMotor.targetPercent = rightTarget;

  if (!allowDrive) {
    forceMotorStop(g_leftMotor);
    forceMotorStop(g_rightMotor);
    if (g_currentCalibrationRequested) {
      g_currentCalibrationRequested = false;
      calibrateCurrentSensors();
    }
    lastStepMillis = nowMillis;
    return;
  }

  uint32_t elapsedMs = nowMillis - lastStepMillis;
  if (elapsedMs == 0 || elapsedMs > (CONTROL_PERIOD_MS * 2)) {
    elapsedMs = CONTROL_PERIOD_MS;
  }
  lastStepMillis = nowMillis;

  // Wire field is 1/rampSeconds; convert to %/s: rate = wireValue × 100.
  float accelRate = commandSnapshot.hasAccelLimit
    ? commandSnapshot.maxAccelerationPercentPerSecond * 100.0f
    : DEFAULT_ACCEL_PERCENT_PER_SECOND;
  float decelRate = commandSnapshot.hasDecelLimit
    ? commandSnapshot.maxDecelerationPercentPerSecond * 100.0f
    : DEFAULT_DECEL_PERCENT_PER_SECOND;

  stepMotorTowardRequested(g_leftMotor, elapsedMs, accelRate, decelRate);
  stepMotorTowardRequested(g_rightMotor, elapsedMs, accelRate, decelRate);
}

// ===== I2C =====
void onReceive(int numBytes) {
  if (numBytes <= 0 || numBytes > static_cast<int>(MAX_FRAME_SIZE)) {
    while (Wire.available()) {
      Wire.read();
    }
    return;
  }

  uint8_t buffer[MAX_FRAME_SIZE];
  int count = 0;
  while (Wire.available() && count < numBytes) {
    buffer[count++] = Wire.read();
  }

  uint8_t messageType = 0;
  uint16_t sequence = 0;
  uint16_t payloadLength = 0;
  const uint8_t *payload = nullptr;
  if (!decodeFrame(buffer, count, messageType, sequence, payload, payloadLength)) {
    return;
  }

  if (messageType == MESSAGE_TYPE_WHEEL_SPEED_COMMAND) {
    WheelSpeedCommand decoded;
    if (decodeWheelSpeedCommandPayload(payload, payloadLength, decoded)) {
      portENTER_CRITICAL(&g_protocolStateMux);
      const bool requestsMotion = decoded.enableDrive
        && (fabs(decoded.leftWheelTargetPercent) > 0.0f || fabs(decoded.rightWheelTargetPercent) > 0.0f);
      // Neutral and disabled commands are always accepted: safety commands
      // must still work after a Pi restart resets its sequence counter. A
      // motion command, however, may not revive an older target that arrived
      // after a newer stop because of upstream queueing or async completion.
      const bool acceptCommand = !requestsMotion
        || !g_haveAcceptedWheelCommandSequence
        || isNewerSequence(sequence, g_lastAcceptedWheelCommandSequence);
      if (acceptCommand) {
        g_latestCommand = decoded;
        g_lastValidCommandMillis = millis();
        g_haveValidCommand = true;
        g_lastAcceptedWheelCommandSequence = sequence;
        g_haveAcceptedWheelCommandSequence = true;
        if (!decoded.enableDrive) {
          // A hard disable marks the end of an operating session. The motor
          // supply may be disconnected while the Pi and ESP remain powered,
          // so the next motion request must establish a fresh zero point.
          g_currentSensorsCalibrated = false;
        }
      }
      portEXIT_CRITICAL(&g_protocolStateMux);
    }
  } else if (messageType == MESSAGE_TYPE_CURRENT_CALIBRATION_COMMAND && payloadLength == 0) {
    // Calibration is serviced by the control loop only after both outputs
    // have been forced off. Invalidate any earlier drive command immediately
    // so a calibration request can never sample motor load current as zero.
    portENTER_CRITICAL(&g_protocolStateMux);
    g_latestCommand.enableDrive = false;
    g_latestCommand.leftWheelTargetPercent = 0.0f;
    g_latestCommand.rightWheelTargetPercent = 0.0f;
    g_haveAcceptedWheelCommandSequence = false;
    g_currentCalibrationRequested = true;
    portEXIT_CRITICAL(&g_protocolStateMux);
  }
}

void onRequest() {
  const uint8_t activeIndex = g_activeTxFrameIndex;
  Wire.write(g_txFrames[activeIndex], MOTOR_FEEDBACK_FRAME_SIZE);
}

void configureTaskWatchdog() {
#if ESP_IDF_VERSION_MAJOR >= 5
  esp_task_wdt_config_t config = {
    .timeout_ms = TASK_WATCHDOG_TIMEOUT_SECONDS * 1000,
    .idle_core_mask = 0,
    .trigger_panic = true,
  };
  esp_task_wdt_init(&config);
#else
  esp_task_wdt_init(TASK_WATCHDOG_TIMEOUT_SECONDS, true);
#endif
  esp_task_wdt_add(nullptr);
}

// ===== Setup / loop =====
void configurePwm() {
  ledc_timer_config_t timerConfig;
  memset(&timerConfig, 0, sizeof(timerConfig));
  timerConfig.speed_mode = PWM_MODE;
  timerConfig.timer_num = PWM_TIMER;
  timerConfig.freq_hz = PWM_FREQ_HZ;
  timerConfig.duty_resolution = PWM_RESOLUTION;
  timerConfig.clk_cfg = LEDC_AUTO_CLK;
  ledc_timer_config(&timerConfig);

  ledc_channel_config_t leftChannelConfig;
  memset(&leftChannelConfig, 0, sizeof(leftChannelConfig));
  leftChannelConfig.gpio_num = LEFT_PWM_PIN;
  leftChannelConfig.speed_mode = PWM_MODE;
  leftChannelConfig.channel = LEFT_CHANNEL;
  leftChannelConfig.intr_type = LEDC_INTR_DISABLE;
  leftChannelConfig.timer_sel = PWM_TIMER;
  leftChannelConfig.duty = 0;
  ledc_channel_config(&leftChannelConfig);

  ledc_channel_config_t rightChannelConfig = leftChannelConfig;
  rightChannelConfig.gpio_num = RIGHT_PWM_PIN;
  rightChannelConfig.channel = RIGHT_CHANNEL;
  ledc_channel_config(&rightChannelConfig);
}

void setup() {
  Serial.begin(115200);

  pinMode(LEFT_DIR_PIN, OUTPUT);
  pinMode(RIGHT_DIR_PIN, OUTPUT);
  pinMode(LEFT_TACH_PIN, INPUT_PULLUP);
  pinMode(RIGHT_TACH_PIN, INPUT_PULLUP);
  pinMode(LEFT_CURRENT_SENSE_PIN, INPUT);
  pinMode(RIGHT_CURRENT_SENSE_PIN, INPUT);

  analogReadResolution(12);
  analogSetPinAttenuation(LEFT_CURRENT_SENSE_PIN, ADC_11db);
  analogSetPinAttenuation(RIGHT_CURRENT_SENSE_PIN, ADC_11db);

  configurePwm();
  applyMotorHardware(g_leftMotor);
  applyMotorHardware(g_rightMotor);
  attachInterrupt(digitalPinToInterrupt(LEFT_TACH_PIN), onLeftPulse, FALLING);
  attachInterrupt(digitalPinToInterrupt(RIGHT_TACH_PIN), onRightPulse, FALLING);

  Wire.begin(I2C_SLAVE_ADDRESS, SDA_PIN, SCL_PIN, 400000);
  Wire.onReceive(onReceive);
  Wire.onRequest(onRequest);

  refreshFeedbackSnapshot(millis());
  refreshFeedbackSnapshot(millis());
  configureTaskWatchdog();
}

void loop() {
  esp_task_wdt_reset();
  uint32_t nowMillis = millis();
  if ((nowMillis - g_lastControlMillis) >= CONTROL_PERIOD_MS) {
    g_lastControlMillis = nowMillis;
    runControlStep(nowMillis);
  }

  if ((nowMillis - g_lastFeedbackMillis) >= FEEDBACK_PERIOD_MS) {
    g_lastFeedbackMillis = nowMillis;
    refreshFeedbackSnapshot(nowMillis);
  }
}
