davidgoddard/mower2026/external-hardware/manual-tests/manual_drive_server.js

// Live manual-drive bring-up server.
// Uses the legacy HID controller mapping, drives the motor node, polls GNSS + IMU,
// and serves a phone-friendly live dashboard over HTTP/SSE.
// Run `npm run build` first so the built TypeScript modules exist in `dist/`.

import http from "node:http";
import path from "node:path";
import { appendFile, readFile } from "node:fs/promises";
import { fileURLToPath } from "node:url";
import i2c from "i2c-bus";
import { HidGameController } from "./hidGameController.js";
import { loadSystemParameters } from "./systemConfig.js";
import { Bmi160ImuSensor } from "../../dist/src/hardware/bmi160ImuSensor.js";
import { PollingMotorNodeClient } from "../../dist/src/nodes/motorNodeClient.js";
import { PollingGnssNodeClient } from "../../dist/src/nodes/gnssNodeClient.js";
import { GnssAdapter } from "../../dist/src/sensing/gnssAdapter.js";
import { MotorFeedbackAdapter } from "../../dist/src/sensing/motorFeedbackAdapter.js";
import { ImuAdapter } from "../../dist/src/sensing/imuAdapter.js";
import { PoseEstimator } from "../../dist/src/estimation/poseEstimator.js";
import { CommandLimiter } from "../../dist/src/control/commandLimiter.js";
import {
  computeManualDriveDemand,
  manualMotionLimiterOptions,
} from "../../dist/src/control/manualDriveProfile.js";
import { mapPhysicalWheelTargetsToRaw } from "../../dist/src/control/motorMapping.js";
import { NodeId } from "../../dist/src/protocols/commonProtocol.js";
import { gnssPayloadLength } from "../../dist/src/protocols/gnssCodec.js";
import { motorFeedbackSampleLength } from "../../dist/src/protocols/motorCodec.js";
import {
  I2C_ADDRESS_BMI160_DEFAULT,
  I2C_ADDRESS_GNSS_DEFAULT,
  I2C_ADDRESS_MOTOR_DEFAULT,
  I2C_BUS_NUMBER_DEFAULT,
} from "../../dist/constants.js";

const PORT = Number(process.env.MOWER_MANUAL_DRIVE_PORT ?? 8093);
const BUS_NUMBER = Number(process.env.MOWER_I2C_BUS_NUMBER ?? I2C_BUS_NUMBER_DEFAULT);
const GNSS_I2C_ADDRESS = Number(process.env.MOWER_GNSS_I2C_ADDRESS ?? I2C_ADDRESS_GNSS_DEFAULT);
const MOTOR_I2C_ADDRESS = Number(process.env.MOWER_MOTOR_I2C_ADDRESS ?? I2C_ADDRESS_MOTOR_DEFAULT);
const CONTROL_LOOP_MS = Number(process.env.MOWER_MANUAL_DRIVE_INTERVAL_MS ?? 100);
const GNSS_REFRESH_INTERVAL_MS = Number(process.env.MOWER_GNSS_REFRESH_INTERVAL_MS ?? 400);
const TELEMETRY_LOG_INTERVAL_MS = Number(process.env.MOWER_TELEMETRY_LOG_INTERVAL_MS ?? 250);
const __filename = fileURLToPath(import.meta.url);
const __dirname = path.dirname(__filename);
const dashboardPath = path.join(__dirname, "manual_drive_dashboard.html");
const sessionLogPath = path.join(
  __dirname,
  `manual-drive-${new Date().toISOString().replace(/[:.]/g, "-")}.jsonl`,
);

const FRAME_HEADER_SIZE = 9;
const FRAME_CRC_SIZE = 2;
const gnssFrameLength = FRAME_HEADER_SIZE + gnssPayloadLength() + FRAME_CRC_SIZE;
const motorFeedbackFrameLength = FRAME_HEADER_SIZE + motorFeedbackSampleLength() + FRAME_CRC_SIZE;

let controller;
const sensor = new Bmi160ImuSensor();
const clients = new Set();

let parameters;
let i2cBus;
let motorNodeClient;
let gnssNodeClient;
let gnssAdapter;
let motorFeedbackAdapter;
let imuAdapter;
let poseEstimator;
let commandLimiter;
let manualDriveEnabled = false;
let lastGnssRefreshMillis = 0;
let lastTelemetryLogMillis = 0;
let lastWheelTargets = { leftMetersPerSecond: 0, rightMetersPerSecond: 0 };
let gnssNodeNowMillis = 0;
let motorNodeNowMillis = 0;
let shuttingDown = false;

const state = {
  serverTimestampMillis: Date.now(),
  sessionLogPath,
  controller: {
    connected: false,
    product: "unavailable",
    angleDegrees: 0,
    speed: 0,
    buttons: {},
    manualDriveEnabled: false,
    lastButtonEvents: [],
  },
  command: {
    mode: "stopped",
    requestedLeftMetersPerSecond: 0,
    requestedRightMetersPerSecond: 0,
    limitedLeftMetersPerSecond: 0,
    limitedRightMetersPerSecond: 0,
  },
  gnss: {
    ok: false,
    error: "not_started",
  },
  motor: {
    ok: false,
    error: "not_started",
  },
  imu: {
    ok: false,
    error: "not_started",
  },
  estimate: {
    ok: false,
    error: "not_started",
  },
  notes: [
    "Press controller top or right-top to enable manual drive.",
    "Press controller cross or left-top to stop and disable drive.",
  ],
};

function sleep(ms) {
  return new Promise((resolve) => setTimeout(resolve, ms));
}

function clamp(value, min, max) {
  return Math.max(min, Math.min(max, value));
}

function deriveImuState(sample) {
  const ax = sample.acceleration.xMetersPerSecondSquared;
  const ay = sample.acceleration.yMetersPerSecondSquared;
  const az = sample.acceleration.zMetersPerSecondSquared;
  const gravityMagnitude = Math.sqrt((ax * ax) + (ay * ay) + (az * az));
  const rollDegrees = Math.atan2(ay, az) * (180 / Math.PI);
  const pitchDegrees = Math.atan2(-ax, Math.sqrt((ay * ay) + (az * az))) * (180 / Math.PI);
  return {
    sample,
    derived: {
      rollDegrees,
      pitchDegrees,
      gravityMagnitude,
    },
  };
}

function deriveMotorState(sample) {
  const leftPhysical = sample.leftWheelActualMetersPerSecond * parameters.leftMotorForwardSign;
  const rightPhysical = sample.rightWheelActualMetersPerSecond * parameters.rightMotorForwardSign;
  return {
    sample,
    derived: {
      leftPhysicalMetersPerSecond: leftPhysical,
      rightPhysicalMetersPerSecond: rightPhysical,
      speedMetersPerSecond: (leftPhysical + rightPhysical) / 2,
      turnBiasMetersPerSecond: rightPhysical - leftPhysical,
    },
  };
}

function deriveGnssState(sample) {
  return {
    sample,
    derived: {
      headingDegrees: sample.headingDegrees ?? null,
      groundSpeedMetersPerSecond: sample.groundSpeedMetersPerSecond ?? 0,
    },
  };
}

function normalizeManualTurnDemand(angleDegrees) {
  const deadbandDegrees = 6;
  const fullLockDegrees = 84;
  const magnitudeDegrees = Math.abs(angleDegrees);
  if (magnitudeDegrees <= deadbandDegrees) {
    return 0;
  }
  const normalizedMagnitude = Math.max(
    0,
    Math.min((magnitudeDegrees - deadbandDegrees) / (fullLockDegrees - deadbandDegrees), 1),
  );
  return Math.sign(angleDegrees) * Math.pow(normalizedMagnitude, 2);
}

function computeManualDemand() {
  if (!state.controller.connected || !manualDriveEnabled) {
    return {
      mode: "stopped",
      requestedLeftMetersPerSecond: 0,
      requestedRightMetersPerSecond: 0,
    };
  }

  return computeManualDriveDemand({
    speedDemand: state.controller.speed,
    turnDemand: normalizeManualTurnDemand(state.controller.angleDegrees),
    maxWheelSpeedMetersPerSecond: parameters.maxWheelSpeedMetersPerSecond,
  });
}

function pushButtonEvent(label) {
  state.controller.lastButtonEvents.unshift({
    label,
    timestampMillis: Date.now(),
  });
  state.controller.lastButtonEvents = state.controller.lastButtonEvents.slice(0, 8);
}

function publishState() {
  state.serverTimestampMillis = Date.now();
  const payload = `data: ${JSON.stringify(state)}\n\n`;
  for (const client of clients) {
    client.write(payload);
  }
}

async function logTelemetryIfDue() {
  if (Date.now() - lastTelemetryLogMillis < TELEMETRY_LOG_INTERVAL_MS) {
    return;
  }
  lastTelemetryLogMillis = Date.now();
  await appendFile(sessionLogPath, `${JSON.stringify(state)}\n`, "utf8");
}

function requestLengthForNode(nodeId) {
  if (nodeId === NodeId.Gnss) {
    return gnssFrameLength;
  }
  if (nodeId === NodeId.Motor) {
    return motorFeedbackFrameLength;
  }
  throw new Error(`Unknown node ${nodeId}`);
}

function addressForNode(nodeId) {
  if (nodeId === NodeId.Gnss) {
    return GNSS_I2C_ADDRESS;
  }
  if (nodeId === NodeId.Motor) {
    return MOTOR_I2C_ADDRESS;
  }
  throw new Error(`Unknown node ${nodeId}`);
}

class LiveI2cBusAdapter {
  constructor(bus) {
    this.bus = bus;
  }

  async send(nodeId, payload) {
    const address = addressForNode(nodeId);
    const buffer = Buffer.from(payload);
    await this.bus.i2cWrite(address, buffer.length, buffer);
  }

  async request(nodeId, payload) {
    const address = addressForNode(nodeId);
    const request = Buffer.from(payload);
    let lastError;

    for (let attempt = 0; attempt < 4; attempt += 1) {
      try {
        await this.bus.i2cWrite(address, request.length, request);
        const response = Buffer.alloc(requestLengthForNode(nodeId));
        const result = await this.bus.i2cRead(address, response.length, response);
        if (result.bytesRead !== response.length) {
          throw new Error(`short read ${result.bytesRead}/${response.length}`);
        }
        return new Uint8Array(response);
      } catch (error) {
        lastError = error;
        await sleep(40);
      }
    }

    throw lastError instanceof Error ? lastError : new Error(String(lastError));
  }

  async close() {
    await this.bus.close();
  }
}

async function refreshGnssIfDue() {
  if (Date.now() - lastGnssRefreshMillis < GNSS_REFRESH_INTERVAL_MS) {
    return;
  }
  lastGnssRefreshMillis = Date.now();

  try {
    const sample = await gnssNodeClient.refresh();
    gnssNodeNowMillis = sample.timestampMillis;
    state.gnss = {
      ok: true,
      ...deriveGnssState(sample),
      adapted: gnssAdapter.adapt(sample),
      health: gnssNodeClient.health(),
    };
    poseEstimator.ingest(state.gnss.adapted);
  } catch (error) {
    state.gnss = {
      ok: false,
      error: error instanceof Error ? error.message : String(error),
    };
  }
}

async function refreshImu() {
  try {
    const sample = await sensor.read();
    const adapted = imuAdapter.adapt(sample);
    state.imu = {
      ok: true,
      ...deriveImuState(sample),
      adapted,
    };
    poseEstimator.ingest(adapted);
  } catch (error) {
    state.imu = {
      ok: false,
      error: error instanceof Error ? error.message : String(error),
    };
  }
}

async function refreshMotorAndDrive() {
  const requested = computeManualDemand();
  const motionLimits = manualMotionLimiterOptions(parameters, CONTROL_LOOP_MS);
  state.command.mode = requested.mode;
  state.command.requestedLeftMetersPerSecond = requested.requestedLeftMetersPerSecond;
  state.command.requestedRightMetersPerSecond = requested.requestedRightMetersPerSecond;

  const mapped = mapPhysicalWheelTargetsToRaw(parameters, {
    leftMetersPerSecond: requested.requestedLeftMetersPerSecond,
    rightMetersPerSecond: requested.requestedRightMetersPerSecond,
  });

  commandLimiter = new CommandLimiter({
    maxWheelSpeedMetersPerSecond: parameters.maxWheelSpeedMetersPerSecond,
    maxWheelAccelerationStepMetersPerSecond: motionLimits.maxWheelAccelerationStepMetersPerSecond,
    maxWheelDecelerationStepMetersPerSecond: motionLimits.maxWheelDecelerationStepMetersPerSecond,
  });
  const limited = commandLimiter.limit(lastWheelTargets, mapped);
  lastWheelTargets = limited;
  state.command.limitedLeftMetersPerSecond = limited.leftMetersPerSecond;
  state.command.limitedRightMetersPerSecond = limited.rightMetersPerSecond;

  try {
    await motorNodeClient.sendWheelSpeedCommand({
      timestampMillis: Date.now() >>> 0,
      leftWheelTargetMetersPerSecond: limited.leftMetersPerSecond,
      rightWheelTargetMetersPerSecond: limited.rightMetersPerSecond,
      enableDrive: manualDriveEnabled && state.controller.connected,
      commandTimeoutMillis: 300,
    });

    const feedback = await motorNodeClient.refreshFeedback();
    motorNodeNowMillis = feedback.timestampMillis;
    const adapted = motorFeedbackAdapter.adapt(feedback);
    state.motor = {
      ok: true,
      ...deriveMotorState(feedback),
      adapted,
      health: motorNodeClient.health(),
    };
    const estimate = poseEstimator.ingest(adapted);
    state.estimate = {
      ok: true,
      sample: estimate,
    };
  } catch (error) {
    state.motor = {
      ok: false,
      error: error instanceof Error ? error.message : String(error),
    };
  }
}

async function controlLoop() {
  while (!shuttingDown) {
    await refreshImu();
    await refreshGnssIfDue();
    await refreshMotorAndDrive();
    await logTelemetryIfDue();
    publishState();
    await sleep(CONTROL_LOOP_MS);
  }
}

async function handlePage(response) {
  const html = await readFile(dashboardPath, "utf8");
  response.writeHead(200, { "Content-Type": "text/html; charset=utf-8" });
  response.end(html);
}

function handleEvents(response) {
  response.writeHead(200, {
    "Content-Type": "text/event-stream",
    "Cache-Control": "no-cache",
    Connection: "keep-alive",
  });
  response.write("\n");
  response.write(`data: ${JSON.stringify(state)}\n\n`);
  clients.add(response);
  response.on("close", () => clients.delete(response));
}

async function handleState(response) {
  response.writeHead(200, { "Content-Type": "application/json; charset=utf-8" });
  response.end(JSON.stringify(state));
}

const server = http.createServer(async (request, response) => {
  try {
    if (request.url === "/" || request.url === "/manual_drive_dashboard.html") {
      await handlePage(response);
      return;
    }
    if (request.url === "/events") {
      handleEvents(response);
      return;
    }
    if (request.url === "/api/state") {
      await handleState(response);
      return;
    }

    response.writeHead(404, { "Content-Type": "text/plain; charset=utf-8" });
    response.end("Not found");
  } catch (error) {
    response.writeHead(500, { "Content-Type": "text/plain; charset=utf-8" });
    response.end(error instanceof Error ? error.stack ?? error.message : String(error));
  }
});

async function shutdown(exitCode = 0) {
  if (shuttingDown) {
    return;
  }
  shuttingDown = true;

  try {
    controller.close();
  } catch {}
  try {
    await motorNodeClient?.sendWheelSpeedCommand({
      timestampMillis: Date.now() >>> 0,
      leftWheelTargetMetersPerSecond: 0,
      rightWheelTargetMetersPerSecond: 0,
      enableDrive: false,
      commandTimeoutMillis: 300,
    });
  } catch {}
  try {
    await sensor.close();
  } catch {}
  try {
    await i2cBus?.close();
  } catch {}
  for (const client of clients) {
    client.end();
  }
  clients.clear();
  await new Promise((resolve) => server.close(resolve));
  process.exitCode = exitCode;
}

async function main() {
  const config = await loadSystemParameters();
  parameters = config.parameters;
  controller = new HidGameController({
    steeringSign: parameters.controllerSteeringSign,
    speedSign: parameters.controllerSpeedSign,
  });
  i2cBus = await i2c.openPromisified(BUS_NUMBER);
  const busAdapter = new LiveI2cBusAdapter(i2cBus);

  gnssNodeClient = new PollingGnssNodeClient(busAdapter);
  motorNodeClient = new PollingMotorNodeClient(busAdapter);
  gnssAdapter = new GnssAdapter({ staleAfterMillis: 1000, now: () => gnssNodeNowMillis });
  motorFeedbackAdapter = new MotorFeedbackAdapter({
    leftMetersPerEncoderCount: parameters.wheelCircumferenceMeters / parameters.encoderCountsPerWheelRevolution,
    rightMetersPerEncoderCount: parameters.wheelCircumferenceMeters / parameters.encoderCountsPerWheelRevolution,
    staleAfterMillis: 500,
    now: () => motorNodeNowMillis,
  });
  imuAdapter = new ImuAdapter({ staleAfterMillis: 500 });
  poseEstimator = new PoseEstimator({ wheelBaseMeters: parameters.wheelBaseMeters });
  const motionLimits = manualMotionLimiterOptions(parameters, CONTROL_LOOP_MS);
  commandLimiter = new CommandLimiter({
    maxWheelSpeedMetersPerSecond: parameters.maxWheelSpeedMetersPerSecond,
    maxWheelAccelerationStepMetersPerSecond: motionLimits.maxWheelAccelerationStepMetersPerSecond,
    maxWheelDecelerationStepMetersPerSecond: motionLimits.maxWheelDecelerationStepMetersPerSecond,
  });

  console.log(
    `Initialising BMI160 IMU sensor on I2C bus ${BUS_NUMBER} address 0x${I2C_ADDRESS_BMI160_DEFAULT.toString(16)}...`,
  );
  await sensor.initialise();
  console.log("Calibrating gyro bias. Keep the mower still...");
  await sensor.calibrateGyro();

  controller.on("update", (snapshot) => {
    state.controller = {
      ...state.controller,
      ...snapshot,
      manualDriveEnabled,
    };
  });
  controller.on("top", () => {
    manualDriveEnabled = true;
    state.controller.manualDriveEnabled = true;
    pushButtonEvent("top");
  });
  controller.on("right-top", () => {
    manualDriveEnabled = true;
    state.controller.manualDriveEnabled = true;
    pushButtonEvent("right-top");
  });
  controller.on("cross", () => {
    manualDriveEnabled = false;
    state.controller.manualDriveEnabled = false;
    pushButtonEvent("cross");
  });
  controller.on("left-top", () => {
    manualDriveEnabled = false;
    state.controller.manualDriveEnabled = false;
    pushButtonEvent("left-top");
  });
  for (const label of ["triangle", "circle", "square", "select", "start", "analog", "left", "right", "bottom"]) {
    controller.on(label, () => pushButtonEvent(label));
  }
  controller.on("error", (error) => {
    state.notes.unshift(`Controller error: ${error instanceof Error ? error.message : String(error)}`);
    state.notes = state.notes.slice(0, 8);
  });
  controller.start();

  server.listen(PORT, () => {
    console.log(`Manual drive dashboard ready at http://0.0.0.0:${PORT}`);
    console.log(`Session telemetry log: ${sessionLogPath}`);
  });

  await controlLoop();
}

process.on("SIGINT", async () => {
  await shutdown(0);
});

process.on("SIGTERM", async () => {
  await shutdown(0);
});

main().catch(async (error) => {
  console.error(error);
  await shutdown(1);
});
