davidgoddard/mower2026/(commit log)

2026-05-17 Initial TypeScript server, logging, and sensor-controller integration
2026-05-17 Integrate GNSS sensor polling and document IMU/GNSS APIs
2026-05-17 Add motor/control primitives and integrate HID manual drive loop
2026-05-18 Add turn controller with self-learning brake points
    Implements autonomous on-the-spot turns with adaptive learning:
    Features:
    - TurnController: executes turns using IMU heading at 50Hz
    - TurnLearningModel: adaptive brake angle learning per direction
    - Emergency stop support during turn execution
    - JSON persistence of learned parameters
    - Modern responsive web UI for tuning and monitoring
    - Angle binning strategy (18 bins from 10° to 180°)
    - Direction-specific learning (CCW vs CW asymmetry)
    - Small angle handling (<20° threshold)
    Web interface:
    - Real-time turn status and history visualization
    - Single turn execution and full tuning sequences
    - Prominent STOP button for emergency abort
    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
2026-05-18 Refactor to event-driven sensor architecture
    Major architectural improvement: sensor controller now emits events at 30Hz
    instead of controllers polling sensors. This eliminates unnecessary loops,
    ensures synchronized updates, and enables scoped subscriptions.
    Architecture changes:
    - SensorController extends EventEmitter with type-safe event methods
    - Created sensorEvents.ts with typed event interfaces:
    - imuHeadingUpdate (30Hz)
    - gnssPositionUpdate (30Hz)
    - motorFeedbackUpdate (30Hz)
    - TurnController subscribes to imuHeadingUpdate only during active turns
    - Scoped subscription pattern: subscribe on entry, unsubscribe on exit
    - Proper error handling ensures event listeners always clean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
2026-05-18 Add drive controller with event-driven architecture
    Core implementation:
    - positionTypes.ts: Branded types for Position, Meters with geometry functions
    - poseFusion.ts: GNSS/IMU/encoder sensor fusion with dead-reckoning fallback
    - driveController.ts: Event-driven point-to-point driving with CTE correction
    - driveLearningModel.ts: Self-learning brake distance and CTE gain
    - driveControllerTypes.ts: Type definitions for drive operations
    Design document:
    - DRIVE-CONTROLLER-DESIGN.md: Complete architecture and implementation guide
    Key features:
    - Event-driven scoped subscriptions (pose updates at 30Hz)
    - Asymmetric CTE correction (keep one wheel at full speed, slow the other)
    - Single brake di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
2026-05-18 Add drive tuning web UI and server integration
    Web UI (driveTuningPage.ts):
    - Modern responsive interface matching turn tuning design
    - Target position inputs (X, Y meters)
    - Execute single drive and run test pattern buttons
    - Large red STOP button for emergency abort
    - Real-time status display (1Hz polling)
    - Drive history table with color-coded results
    - Learning parameters display (brake distance, CTE gain, encoder calibration)
    - Clear history and reset learning buttons
    Server integration (appServer.ts):
    - GET /drive-tuning - serve drive tuning page
    - GET /api/drive/status - controller state, history, and parameters
    - POST /api/drive/execute - execute single drive (targetX, targetY)
    - PO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
2026-05-18 Add drive controller unit tests
    Test coverage:
    - Execute 5m straight drive successfully
    - Execute drive with initial turn (>5 degrees off)
    - Emergency stop during drive
    - Track drive history
    - Clear drive history
    - Learning model default parameters
    - Learning model brake distance updates from error
    Tests use EventEmitter-based mocks matching turn controller pattern.
2026-05-18 Update pull request document with drive controller details
    Added comprehensive documentation of drive controller implementation:
    - Drive controller components and features
    - PoseFusion sensor fusion details
    - Drive tuning web UI
    - API endpoints
    - Statistics updated (~6,500 lines added)
    - Testing status
    - Review focus areas expanded
    - Next steps updated with drive-specific items
2026-05-18 Fix web UI to work without hardware using stub sensor gateway
    Problem: When running without i2c hardware (eg. on Windows), the server
    would fail to create turn/drive controllers, causing 503 errors on web UI.
    Solution:
    - Created StubSensorGateway that implements SensorHardwareGateway interface
    - Stub throws errors on sensor reads but silently accepts motor commands
    - When hardware initialization fails, use stub gateway instead
    - Controllers are still created and functional (just show sensor errors)
    - Web UI loads properly and displays sensor error states
    Benefits:
    - Web UI works for development without hardware
    - API endpoints return proper idle states instead of 503 errors
    - Sensor error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
2026-05-18 Redesign home page as professional dashboard with graphical displays
    Complete redesign of the web interface for professional look and feel:
    Home Page (Dashboard):
    - Modern card-based layout with action cards for Turn/Drive tuning
    - Visual sensor displays instead of raw JSON:
    - IMU: Animated compass with rotating needle showing heading
    - GNSS: Position coordinates, fix type, accuracy, satellites, heading
    - Motors: Speed, PWM, watchdog status, fault flags displayed as metrics
    - Color-coded status indicators (green=running, red=error, gray=idle)
    - Professional graphics with gradient effects and smooth animations
    - Error messages displayed in readable format when sensors fail
    - Footer wit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
2026-05-18 Add IMU pitch/roll tilt sensing and motor current VU meters
    Hardware & Sensors:
    - Extend BMI160 IMU driver to read accelerometer (X, Y, Z axes)
    - Add pitch/roll calculation from accelerometer gravity vector
    - Implement startup calibration for pitch/roll zero reference
    - Add pitch/roll to ImuSample type and sensor events
    Sensor Controller:
    - Calculate pitch/roll from accelerometer in pollImu()
    - Expose pitch/roll in primitives store and events
    - Update all IMU primitive initializations with pitch/roll fields
    Web Dashboard Enhancements:
    - Add circular level indicators for pitch and roll in IMU widget
    - Add compass display to GNSS widget matching IMU style
    - Replace motor current text with VU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
2026-05-18 Add retry system and path following with Pure Pursuit
    Implements Design B for both systems:
    Retry System (Event-Driven Recovery with Checkpoint System):
    - CheckpointStore: Maintains recovery points for different operation contexts
    - RetryManager: Event-driven recovery handling for obstructions
    - Context-aware recovery strategies for line, path, and turn operations
    - Max 3 retry attempts before session abort
    - Obstruction detection via motor current, wheel slip, and stall conditions
    Path Following (Pure Pursuit Algorithm):
    - IPathFollower API: Abstract interface supporting multiple algorithms
    - PurePursuitFollower: Pure Pursuit implementation with adaptive lookahead
    - PathStore: Persistent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
2026-05-18 Update documentation with retry and path following systems
    Documentation updates:
    - README.md: Added Pure Pursuit path following and obstruction recovery features
    - system-map.md: Added comprehensive sections for:
    - Pose Estimation location (src/sensing/poseFusion.ts) - clarified this is THE place for pose estimation
    - Retry System with event-driven recovery and checkpoint management
    - Path Following with Pure Pursuit algorithm implementation
    - Drive Controller with retry integration
    - Turn Controller with retry integration
    - Updated Sensors section with IMU pitch/roll and obstruction detection
    - Updated sensor events with obstruction detection types
    All documentation now cons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
2026-05-18 Fix TypeScript compilation errors in path following system
    Fixes:
    - pathRecorder.ts: Store bound callback and use proper EventEmitter off() method
    - pathRecorder.ts: Define poseFusion dependency interface with explicit on/off methods
    - pathStore.ts: Add explicit type annotations for filter/map callback parameters
    All TypeScript errors resolved, build now succeeds.
2026-05-18 Add Path Tracing web UI page
    New Features:
    - Path recording interface with start/stop/cancel controls
    - Live recording status with point counter
    - Stored paths list with metadata (points, distance, created date)
    - Drive and delete actions for each path
    - Auto-increment naming (Obstacle 1, 2, 3...)
    - Instructions and visual feedback
    - Responsive design for mobile/desktop
    UI Components:
    - Recording indicator with pulsing dot animation
    - Status box showing recording state
    - Empty state for no paths
    - Action buttons for drive and delete operations
    Navigation:
    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
2026-05-18 Update Turn and Drive Tuning page headers to match Path Tracing layout
    Changes:
    - Removed back button icon on left
    - Title now stands alone on left (larger font)
    - Status badge centered in middle
    - Back link text on right (matches Path Tracing)
    - Cleaner, more consistent layout across all tuning pages
    Header layout now: Title (left) | Status (center) | Back Link (right)
2026-05-18 Reorganize manual drive page layout
    Left column (50%):
    - Position map with stored paths
    - 3 primary status cards (controller, command, position estimate)
    Right column (50%, 2x2 grid):
    - Controller demand details
    - Motion feedback details
    - GNSS details
    - IMU details
    Responsive:
    - Desktop (>1024px): side-by-side layout
    - Tablet (768-1024px): stacked, sensors remain 2x2
    - Mobile (<768px): fully stacked, sensors 1 column
2026-05-19 Refactor config and stop handling
    [motor-calibration.json]
2026-05-19 Switched speed from m/s to percentages
    [motor-calibration.json]
2026-05-21 Added validation to real turns
    [motor-calibration.json]
2026-05-29 Updating motor widget with DR
2026-05-29 rebase motor derived positionin on good GNSS
2026-06-01 another pose fix attempt
    [gnss-node-v2.ino]
2026-06-02 WIP on calibration
2026-06-04 fix(esp): sign encoder pulses in ISR from cached DIR sign so coast pulses count
    The firmware was zeroing every signed encoder delta whenever
    appliedPwmPercent was 0. That dropped all pulses arriving during
    ramp-up, ramp-down and the brake-to-stop coast — so the Pi saw
    the mower "freeze" the instant a stop command fired even though
    the wheel was still rolling. This corrupted per-tick distance
    calibration (the dead-reckoning calibrator was computing wheel
    bases of ~1.5 m for a 0.55 m mower), pose-fusion encoder
    integration, and stall detection.
    Sign each pulse in the ISR by a cached DIR-pin sign per wheel.
    applyMotorHardware updates the cache in lockstep with the DIR
    pin write, so it is the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
2026-06-04 remove drive duration timeouts; gentle manual-drive disconnect; longer ESP watchdog
    Drive controllers no longer timeout based on elapsed time. A drive
    that is making honest progress is allowed to continue; arrival
    tolerance, the optional cross-track-error limit, and the global
    stall detector are the only stop conditions. Removed
    DRIVE_TIMEOUT_MULTIPLIER, TURN_TIMEOUT_MULTIPLIER (already dead),
    SEGMENTED_DRIVE_TIMEOUT_MINIMUM_MS, the timeoutMinimumMs and
    disableTimeout request fields, and the "timeout" status from
    DriveResult/TurnResult.
    Manual-drive disconnect now sends a single gentle stop and keeps
    manual drive armed for a 2 s reconnect grace window — flaky HID
    links can recover without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
2026-06-04 pose fusion: wheel-speed rebase gate, encoder re-anchor on every TRUSTED GNSS, doc
    Replace the tilt-compensated yaw-rate gate in
    getHeadingRebaseReadiness with a measured-wheel-speed gate
    (both wheels ≤ 1 cm/s, or null when no feedback yet). Wheel
    speed is the direct ground-truth signal — gyro noise on a
    parked mower no longer holds rebases off, and the threshold
    is comfortably above sensor noise. Consolidate the existing
    1 cm/s threshold into a shared WHEELS_STATIONARY_SPEED_THRESHOLD_MPS.
    Drop the now-unused latestTiltCompensatedYawRateDegPerSec
    cache. Update HeadingRebaseReadiness fields and the two log
    sites that referenced the old yaw-rate fields.
    Re-anchor the encoder-only X/Y tra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
2026-06-04 perimeter follow: segmented-only, drop pure pursuit, wire retry recovery
    Why: pure-pursuit smoothing on hand-driven perimeters compromised the recorded
    edge - the operator drove close to obstacles deliberately, so the retrace must
    follow those points faithfully. Segmented drive over a chord+turn-angle
    simplifier preserves intent without cutting corners.
    - replace pure pursuit follower with the segmented executor for all perimeter
    follows (path drive/verify, area-perimeter drive/verify, mowing first-encounter
    trace, inter-strip connectors). delete PurePursuitFollower module, the
    per-path drive-algorithm choice, and the obstacle outward-loop inflation;
    arrival standoff stays for body-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
2026-06-10 Drive line controller: straight-line only, encoder-tick stationary, GNSS-gated learning
    The straight-line driver no longer pretends to follow curves or reason
    about wheel speed in m/s. Pure-pursuit, lookahead, curvature, and the
    m/s wheel-speed plumbing have all been removed because the cutting blade
    and drive are mechanically coupled — slow speeds risk stalling, so every
    drive runs at full power with only a proportional left/right wheel trim
    to hold the line.
    The wheels-stationary check that gated heading rebases and IMU bias
    auto-recalibration was using `(encoderDelta * metersPerTick) / dt` and
    comparing against a 1 cm/s threshold. metersPerTick is uncalibrated
    until the dead-reckonin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
2026-06-10 Re-enable per-drive diagnostic heartbeat
    Throttled to one log entry per HEARTBEAT_INTERVAL_MS, captures the
    fused pose the controller steers against alongside the raw GNSS
    position (no lever-arm correction) and IMU-derived heading. Lets a
    post-mortem distinguish lever-arm-amplified-jitter from real body
    wander from a bad start-anchor heading without re-running the drive.
2026-06-10 Log brake-trigger reason and remaining-along-track at the moment it fires
    The 200 ms heartbeat throttle hides the moment the brake check actually
    trips, which makes it impossible to tell from logs alone whether brake
    fired on the brake-distance path, the arrival-tolerance path, or with
    some unexpected remaining-along-track value. Add an explicit one-line
    log at each trigger site capturing reason, elapsed time, the remaining
    distance and the brake-distance/tolerance it was compared against, plus
    the fused pose at that instant. Diagnostic-only; no behaviour change.
2026-06-10 Motor stop is ramped by default; only operator stop / stall disables H-bridges
    Drive learning was failing because every "successful" drive went through
    finishStoppedDrive / completeDrive paths that raised systemStop and then
    called disableMotorDriver(), which sent enableDrive=false — slamming the
    H-bridges off and skipping the configured deceleration profile entirely.
    The brake fraction had no effect on final position because the mower was
    not coasting; it was being slammed to a stop the moment the brake check
    fired.
    Restructured so the only paths that disable the drive are:
    - /api/stop and every per-feature "stop" button on the web UI
    - confirmed stall detection
    - I2C watchdog / sensor-l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
2026-06-10 Drop 0.05 brake-fraction floor; silence per-tick diagnostic logs
    The short-drive brake-fraction learner has been clamping at 0.05 for
    days, which is exactly what was preventing the 50 cm bucket from
    converging. When the mower never reaches cruise speed on a short
    drive, the natural answer for "where do I trigger the brake?" is "at
    the target itself" — fraction = 0. The arrival-tolerance check picks
    up at remaining ≤ 1 cm so fraction = 0 is well-behaved. Allow the
    full [0, 1] range.
    Also silence two log paths that were heavy enough to make ssh
    unresponsive on the Pi:
    - drive.line.heartbeat fired at 5 Hz throughout every drive and dumped
    the full pose-fusion diagnostic snapshot. Bo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
2026-06-12 Replace fixed step cap with proportional learning rate for brake convergence
    The 5cm step cap prevented brake distance from ever converging: a 37cm
    overshoot only moved the value 5cm, and the next undershoot reset it.
    Replace with errorX * 0.7 so large errors produce large corrections and
    the brake distance reaches the correct value in 3-5 runs from zero.
2026-06-12 Fix lat/lon precision loss in ESP32 GNSS firmware
    Latitude and longitude were parsed as float then cast to double.
    At ~51 degrees latitude, float has ~0.42m resolution, causing the
    reported position to appear frozen for ~42cm then jump — making
    GNSS useless for brake distance control during short drives.
    Parse directly to double via strtod so full receiver precision is
    preserved through to the I2C payload.
    [gnss-node-v2.ino]
2026-06-14 Turning and drives calibrating
2026-06-15 turning bug fix
    [motor-calibration.json]
2026-06-16 Angular velocity large angles
2026-07-15 Allow sustained GNSS heading to rebase IMU
2026-07-22 Migrate untrained turn timing buckets
2026-07-22 Prefer direct drive for safe short connectors
2026-07-25 Complete boundary traces near their join point
2026-08-07 Track mowing progress and discover sweep pockets
2026-08-08 Add ESP-NOW GNSS correction relay
    [gnss-node-v2.ino]
2026-08-08 Print GNSS base station MAC at startup
2026-08-12 adding return to charge point
    [motor-battery-usage.json]
2026-08-12 fixed up remaining tests
    [motor-battery-usage.json]
2026-08-15 Stabilize mowing planning and execution recovery
    Simplify regional route planning and validate connector geometry, harden turn-then-drive and continuous-path execution, improve resume/recharge routing, and keep GNSS/IMU responsibilities explicit. Add a one-shot safe retry for low-current translation stalls on active mowing strips, with updated diagnostics, tests, operator UI behavior, and documentation.
    [motor-battery-usage.json]
2026-08-15 Ignore generated motor battery usage state
    [motor-battery-usage.json]
2026-09-04 Fix drive training and motor command ordering
    [motor-controller.ino]
2026-09-04 Harden GNSS node and shared I2C recovery
2026-09-13 Stabilize GNSS transport and mowing path recovery
    [gnss-firmware.cpp, gnss-mower.ino]
